Seba-san/Trabajo_Final_Controlados/Posible_bibliografia/Bibliografia_SJ/CONTROL PID_2017.pdf

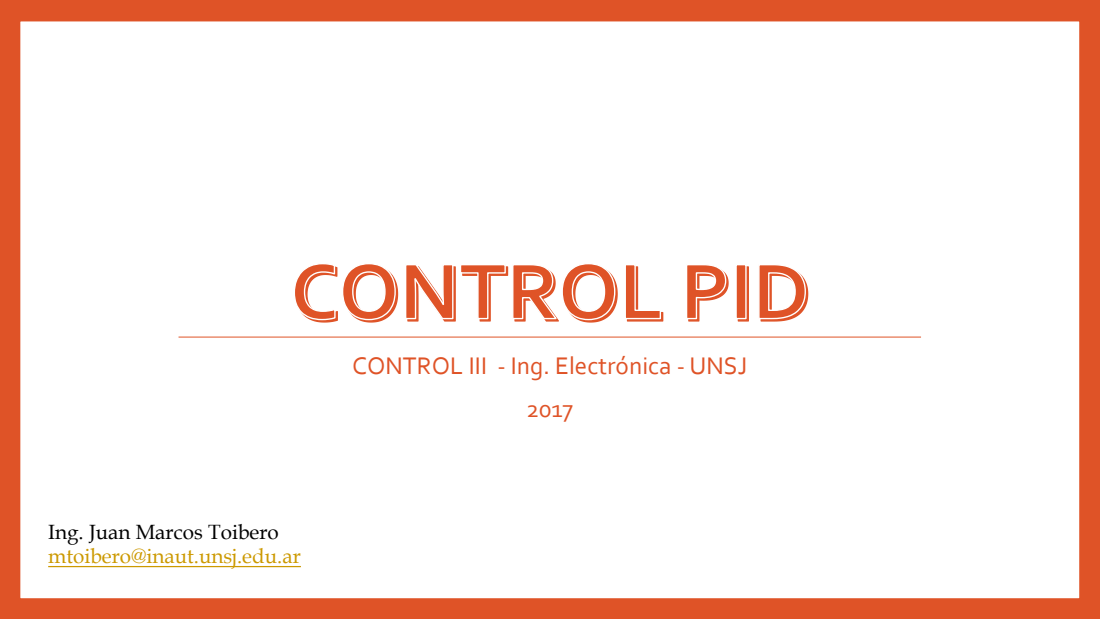
[picture p93: page 1]

CONTROL III - Ing. Electrónica - UNSJ

Ing. Juan Marcos Toibero
mtoibero@inaut.unsj.edu.ar

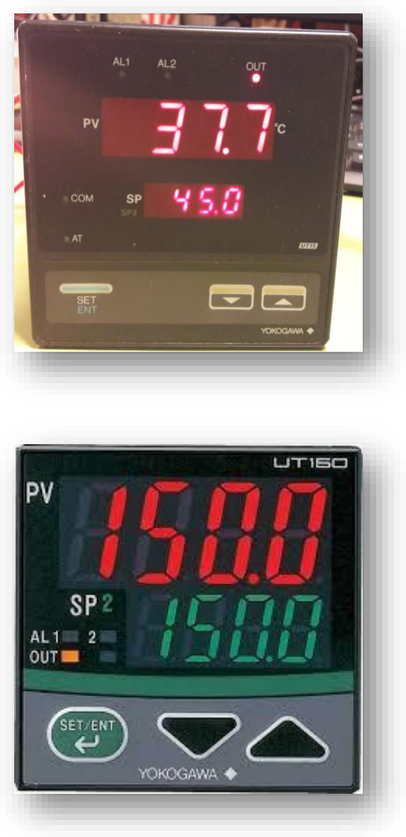
[picture p94: figure]

# Controladores PID industriales

### - Yokogawa UT15 (disponible)

### - Yokogawa UT150 (último modelo comercial)

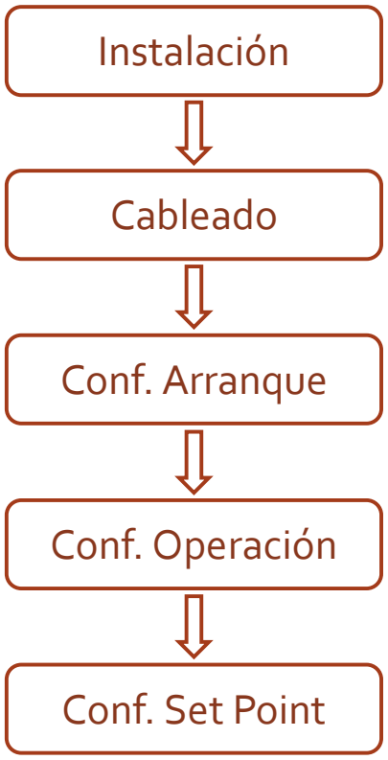
[picture p95: figure]
Instalación; Cableado; Conf. Arranque; Conf. Operación; Conf. Set Point

UT15

### - Pasos antes de operar el equipo

1) Instalación
2) Cableado
3) Configuración de Parámetros de Arranque
4) Configuración de Parámetros de Operación
5) Configuración de Set Point

¡Precaución!
El equipo no tiene interruptor de encendido y apagado.
Entrega la acción de control apenas es conectado en caso de ser necesario.

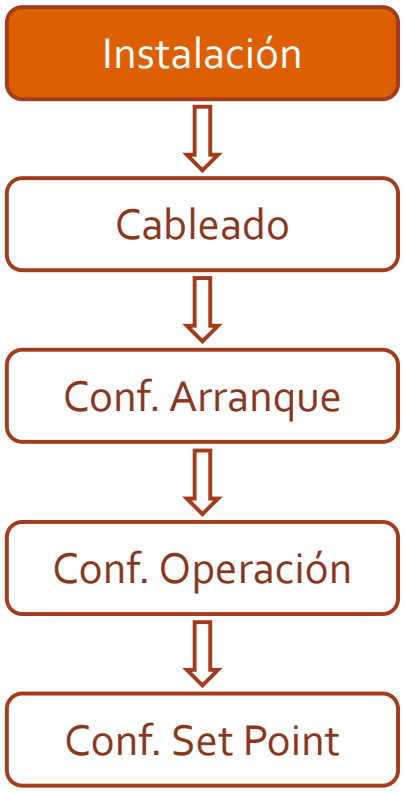
[picture p96: figure]
Instalación; Cableado; Conf. Arranque; Conf. Operación; Conf. Set Point

UT15

### - Instalación

Es la conexión del equipo al tablero, teniendo en cuenta las dimensiones del mismo.

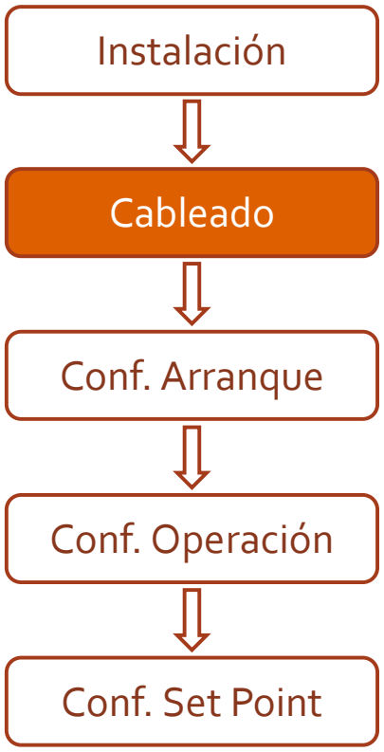
[picture p97: figure]
Instalación; Cableado; Conf. Arranque; Conf. Operación; Conf. Set Point

UT15

### - Cableado

Las conexiones se encuentran en la parte trasera

¡Precaución!

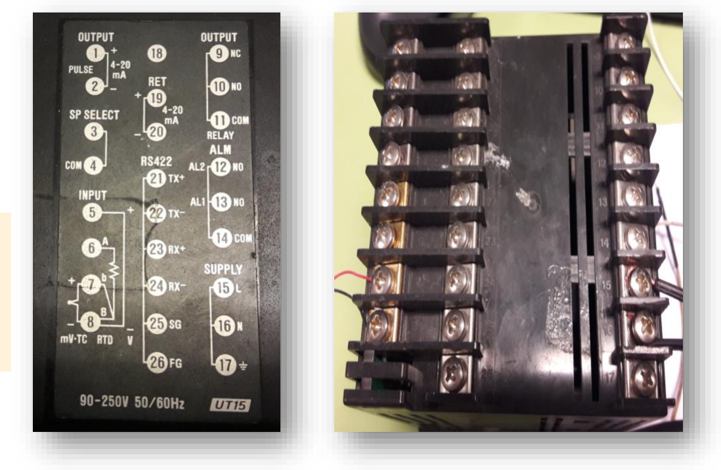
[picture p98: figure]

El equipo no tiene fusibles. De ser necesario se deben agregar en una instalación aparte. Si la carga excede el valor máximo de contacto de salida, deberán agregarse relés extra. Debe tenerse en cuenta además que se pueden llegar a requerir protecciones para los circuitos de accionamiento:
- Diodos para las salidas de DC
- Circuitos RC para las salidas de AC

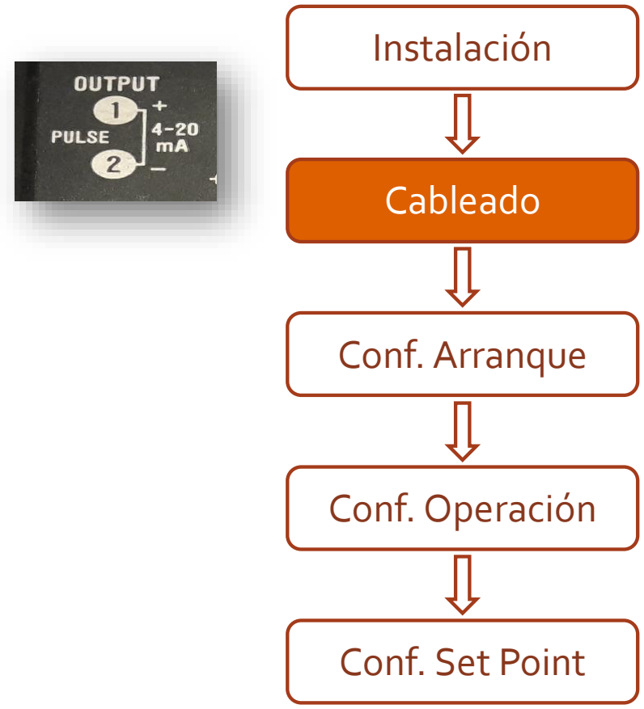
[picture p99: figure]
Instalación; Cableado; Conf. Arranque; Conf. Operación; Conf. Set Point

UT15

### - Salida Analógica

### 4-20[mA] o para tensión

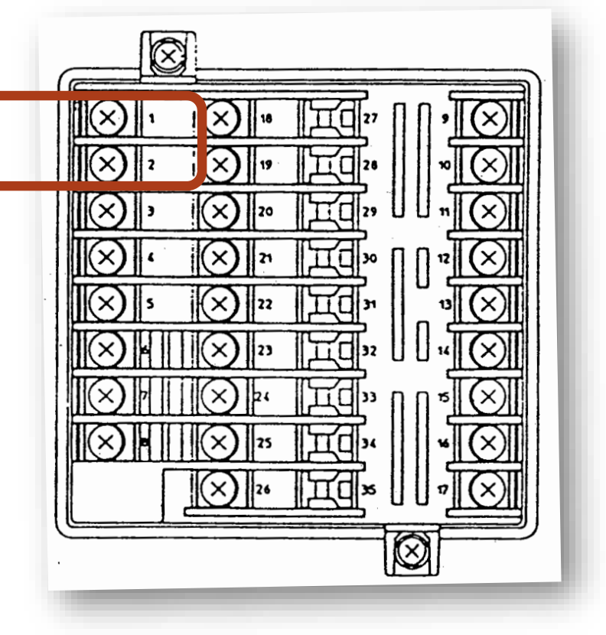
[picture p100: figure]

OUT Analógica

UT15

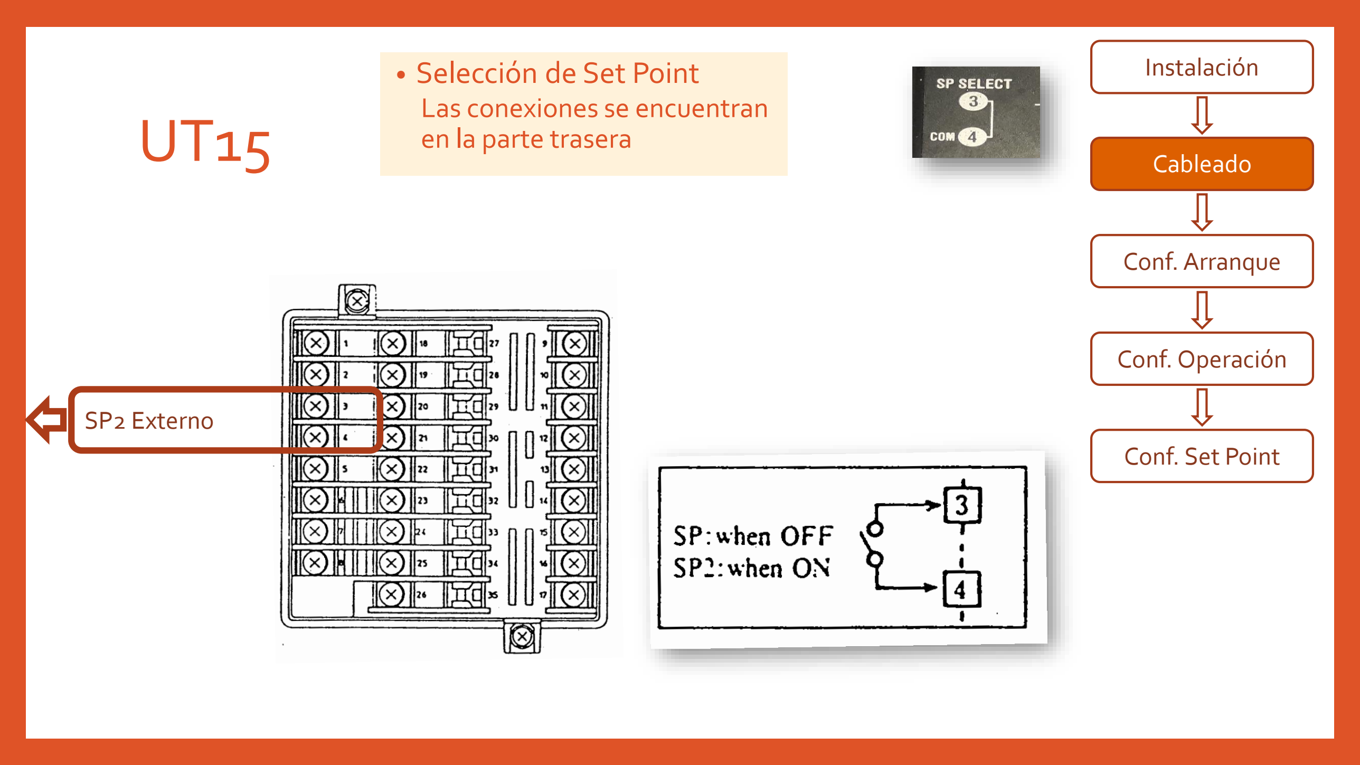
[picture p101: page 7]

### - Selección de Set Point

Las conexiones se encuentran en la parte trasera

Instalación

Cableado

Conf. Arranque

Conf. Operación

Conf. Set Point

SP2 Externo

UT15

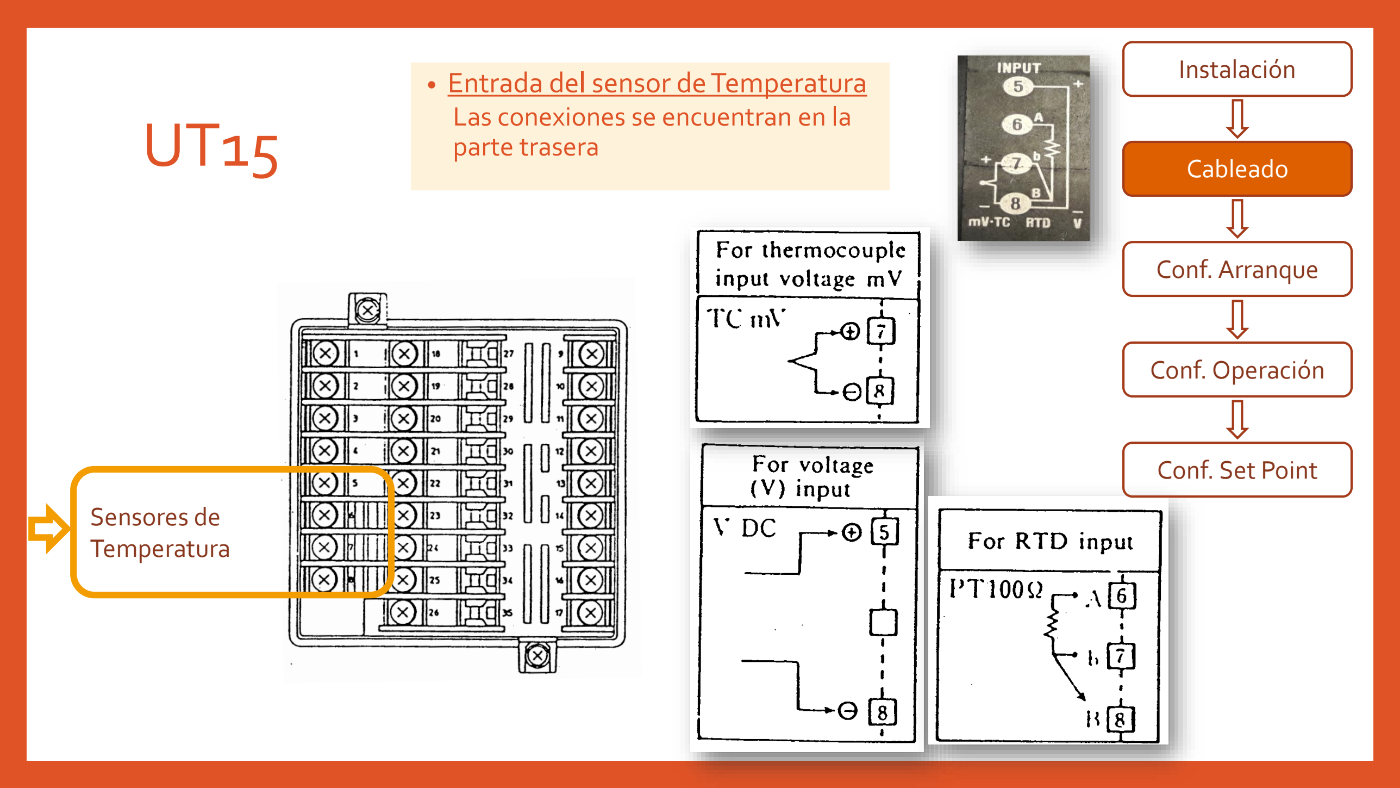
[picture p102: page 8]

- Entrada del sensor de Temperatura Las conexiones se encuentran en la parte trasera

Sensores de
Temperatura

Instalación

Cableado

Conf. Arranque

Conf. Operación

Conf. Set Point

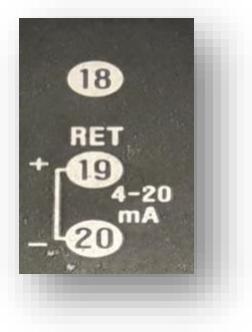
[picture p103: figure]

UT15

### - Retransmisión Salida Opcional

4-20 [mA]

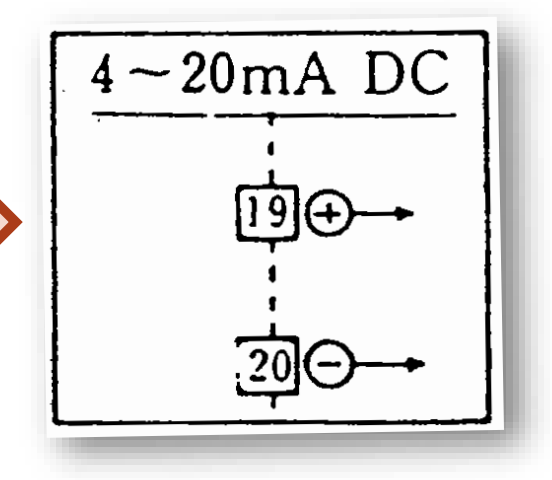
[picture p104: figure]
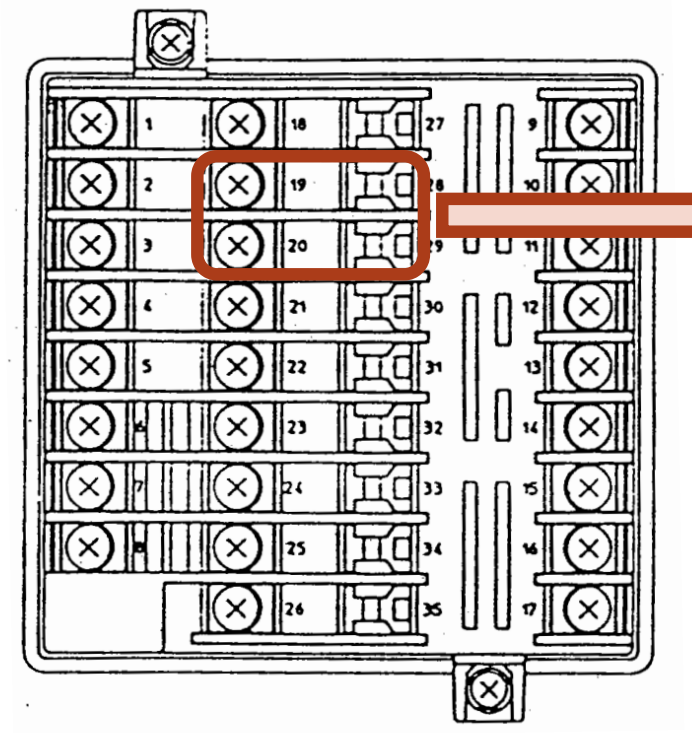
[picture p105: figure]

UT15

### - Comunicación RS422 Opcional

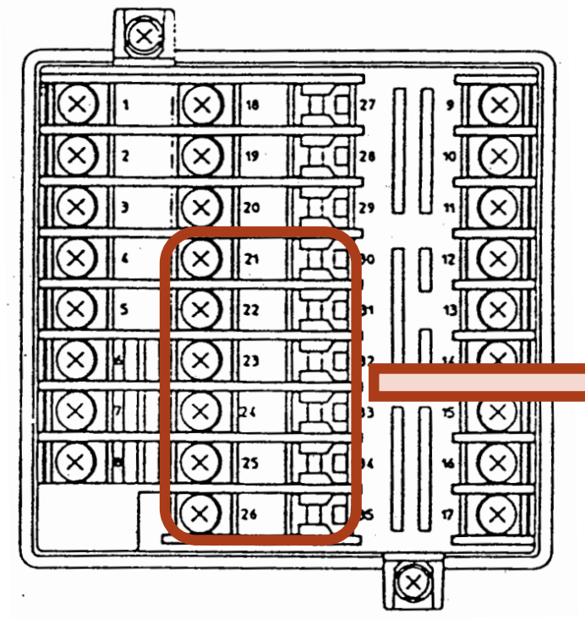
[picture p106: figure]
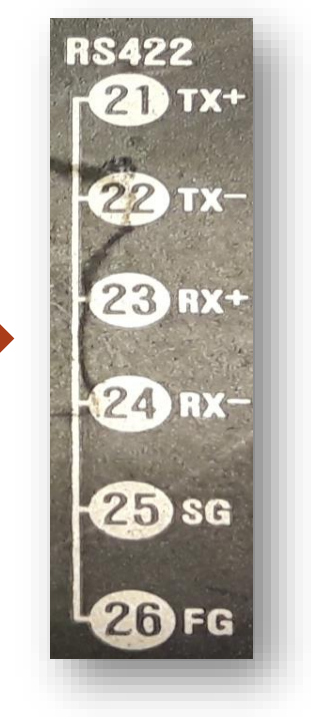
[picture p107: figure]

UT15

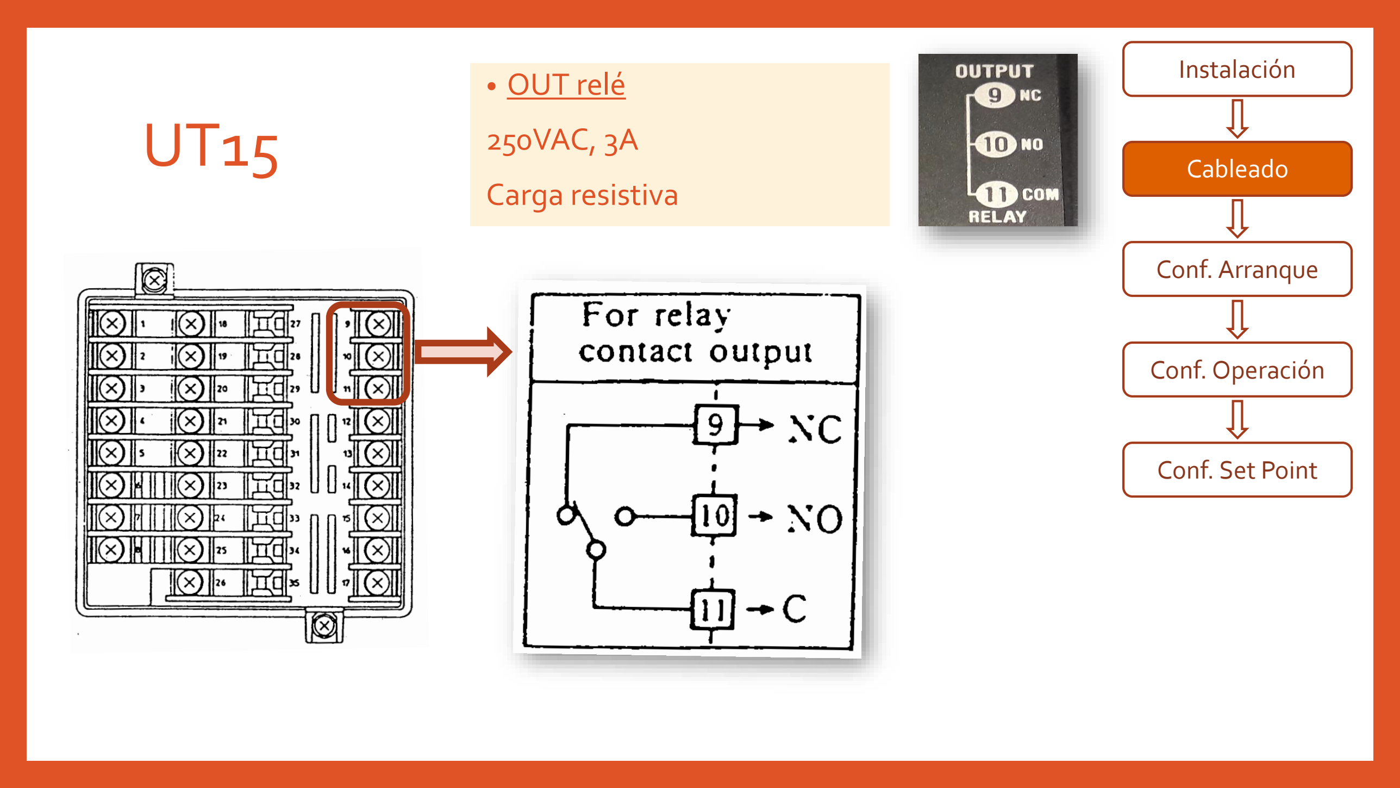
[picture p108: page 11]

### - OUT relé

### 250VAC, 3A

### Carga resistiva

Instalación

Cableado

Conf. Arranque

Conf. Operación

Conf. Set Point

UT15

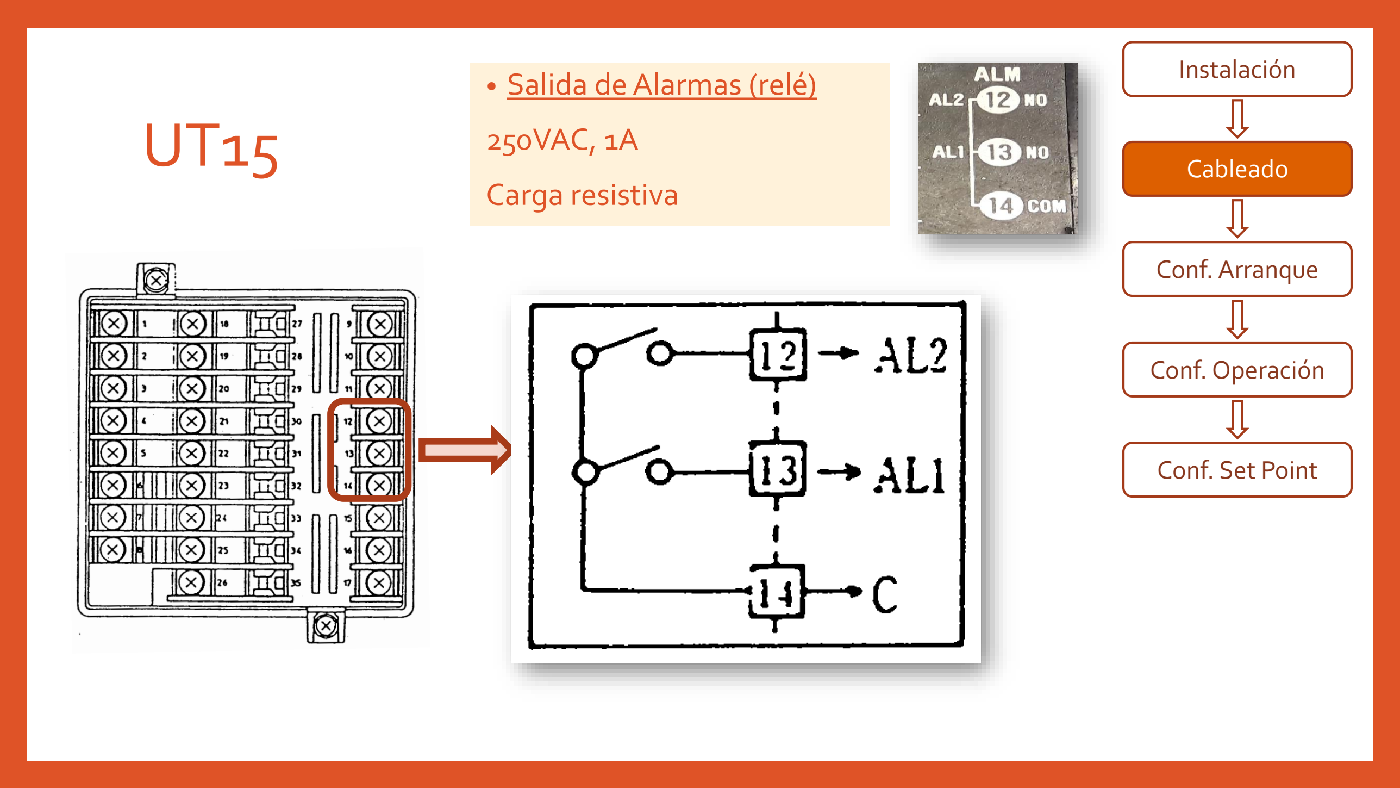
[picture p109: page 12]

### - Salida de Alarmas (relé)

### 250VAC, 1A

### Carga resistiva

Instalación

Cableado

Conf. Arranque

Conf. Operación

Conf. Set Point

UT15

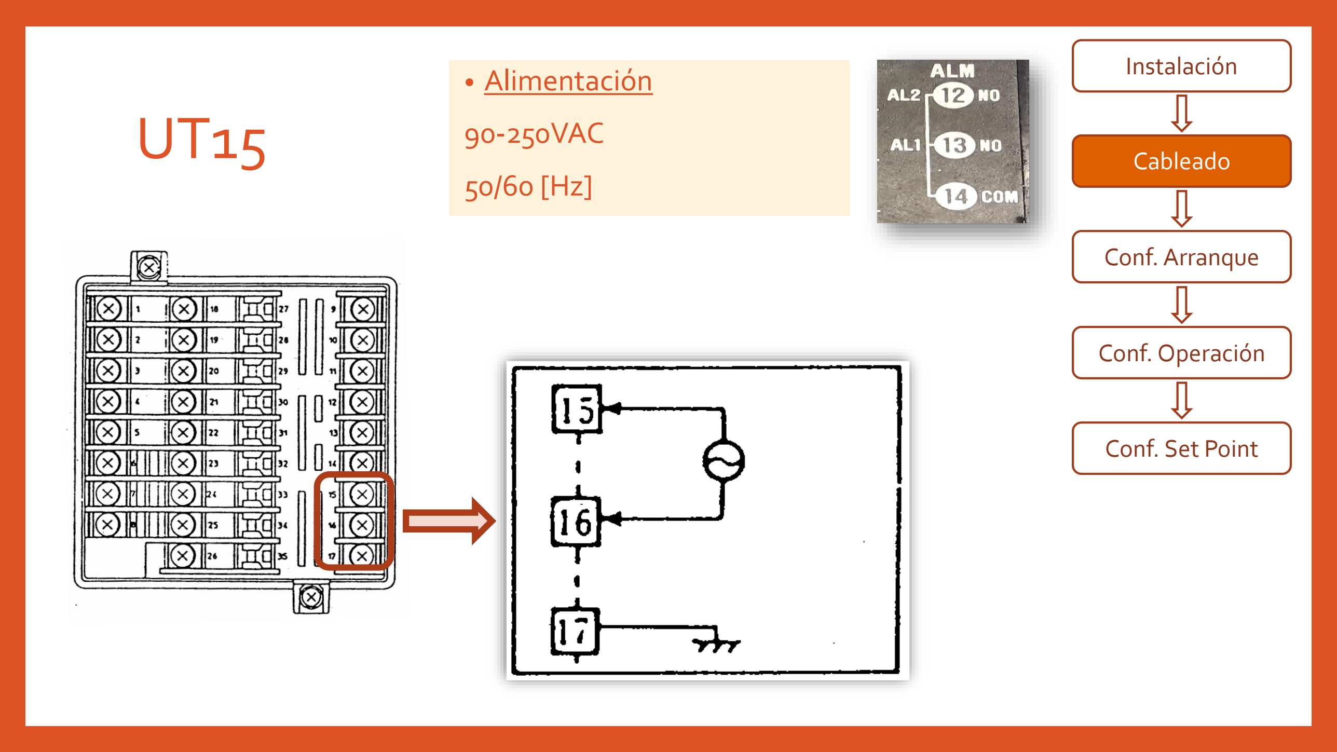
[picture p110: page 13]

### - Alimentación

90

### -250VAC

50/60 [Hz]

Instalación

Cableado

Conf. Arranque

Conf. Operación

Conf. Set Point

UT15

### - Panel Frontal

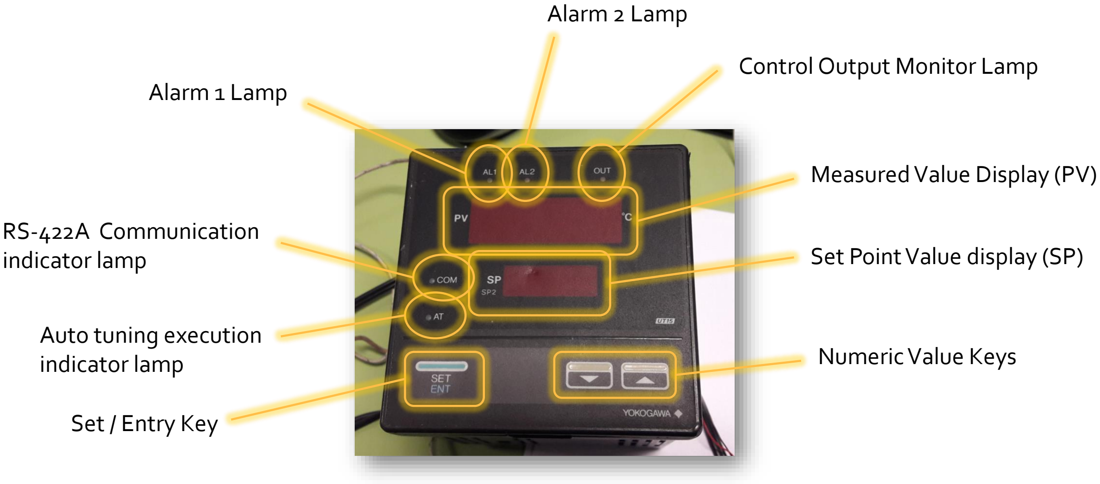
[picture p111: figure]
Set / Entry Key; Numeric Value Keys; Alarm 1 Lamp; Alarm 2 Lamp; Control Output Monitor Lamp; Measured Value Display (PV); Set Point Value display (SP); Auto tuning execution indicator lamp; RS-422A Communication indicator lamp

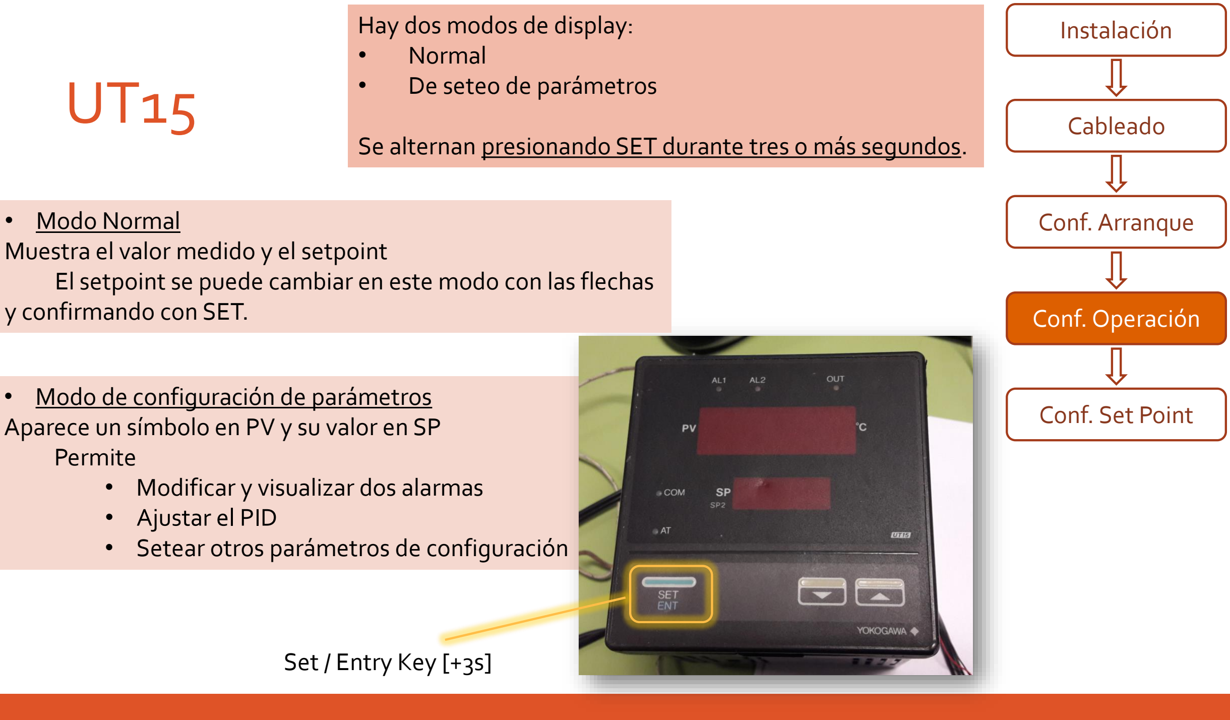
[picture p112: figure]
• Modo de configuración de parámetros; Permite • Modificar y visualizar dos alarmas • Ajustar el PID; Set / Entry Key [+3s]; Hay dos modos de display: • Normal • De seteo de parámetros; • Modo Normal Muestra el valor medido y el setpoint; y confirmando con SET.; Instalación; Cableado; Conf. Arranque; Conf. Operación; Conf. Set Point

Aparece un símbolo en PV y su valor en SP

- Setear otros parámetros de configuración

Se alternan presionando SET durante tres o más segundos.

El setpoint se puede cambiar en este modo con las flechas

UT15

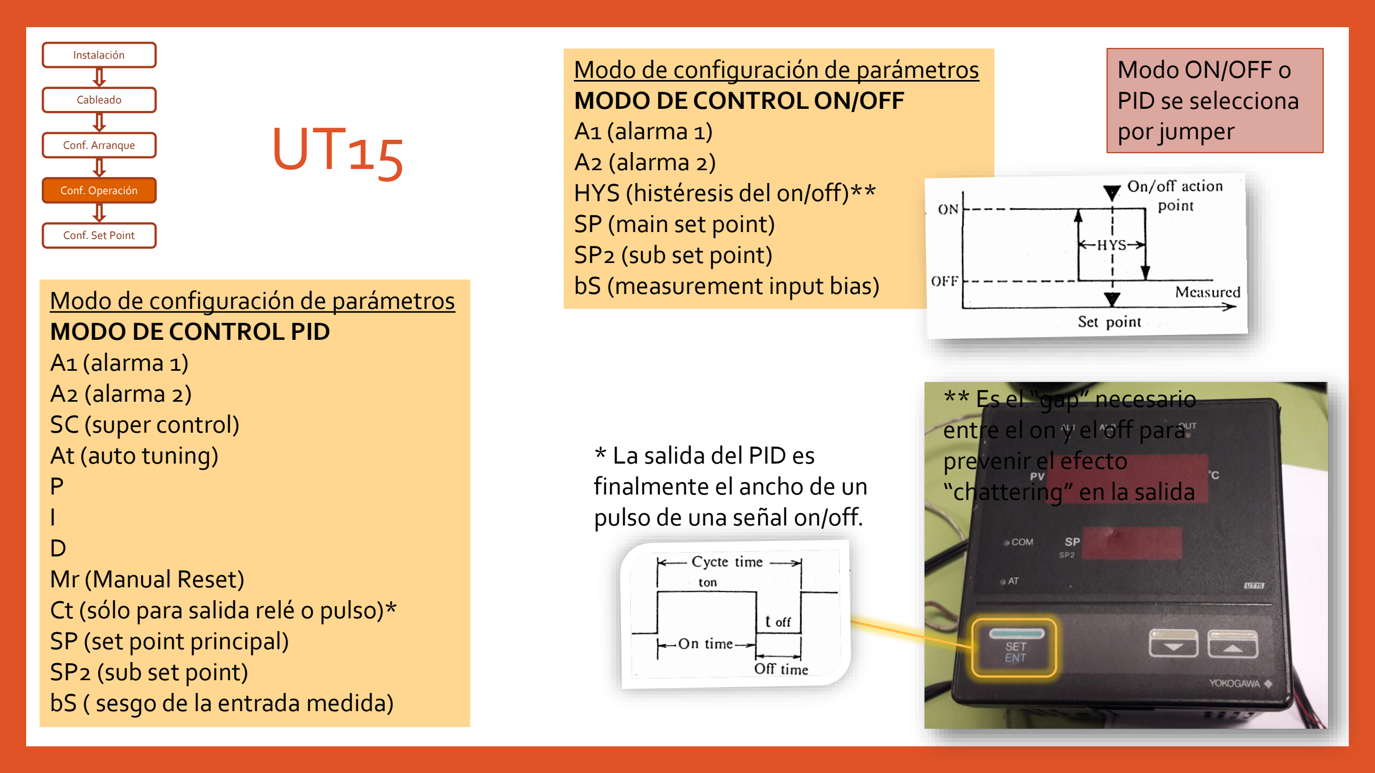
[picture p113: page 16]

Set / Entry Key

Modo de configuración de parámetros MODO DE CONTROL PID
A1 (alarma 1)
A2 (alarma 2)
SC (super control)
At (auto tuning)
P
I
D
Mr (Manual Reset)
Ct (sólo para salida relé o pulso)* SP (set point principal)
SP2 (sub set point)
bS ( sesgo de la entrada medida)

Modo de configuración de parámetros MODO DE CONTROL ON/OFF
A1 (alarma 1)
A2 (alarma 2)
HYS (histéresis del on/off)** SP (main set point)
SP2 (sub set point)
bS (measurement input bias)

Modo ON/OFF o
PID se selecciona
por jumper

* La salida del PID es
finalmente el ancho de un
pulso de una señal on/off.

** Es el “gap” necesario
entre el on y el off para
prevenir el efecto
“chattering” en la salida

Instalación

Cableado

Conf. Arranque

Conf. Operación

Conf. Set Point

SP2

- Los valores del PID son los mismo para SP que para SP2
- Hay que tener precaución si se usó auto tuning para algún set point, porque puede ser que los valores obtenidos no funcionen tan bien con uno como con el otro.

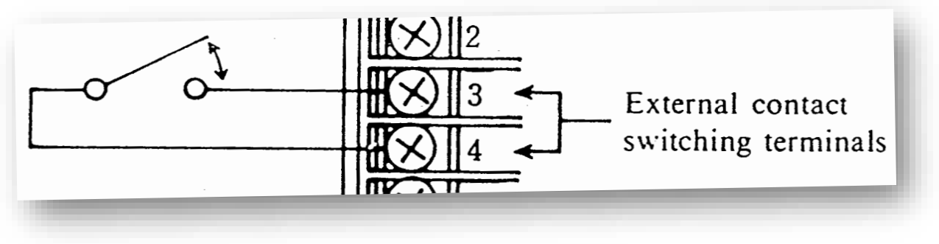
[picture p114: figure]

### - Cuando se observe una diferencia entre la temperatura en la ubicación del sensor

y la que debe ser controlada. Se puede ingresar esta diferencia para compensar.

### PV_medida + Bias = PV_empleada

# Sesgo en la medida de entrada (input bias)

El cambio entre SP y SP2
se realiza por medio de
un contacto externo

Instalación

Cableado

Conf. Arranque

Conf. Operación

Conf. Set Point

# UT15 :: Configuración de Alarmas

Modo de configuración de parámetros
Aparece A1 en PV
Se ajusta el valor de alarma MÁXIMA A1 usando las flechas
El punto decimal en SP debe parpadear.

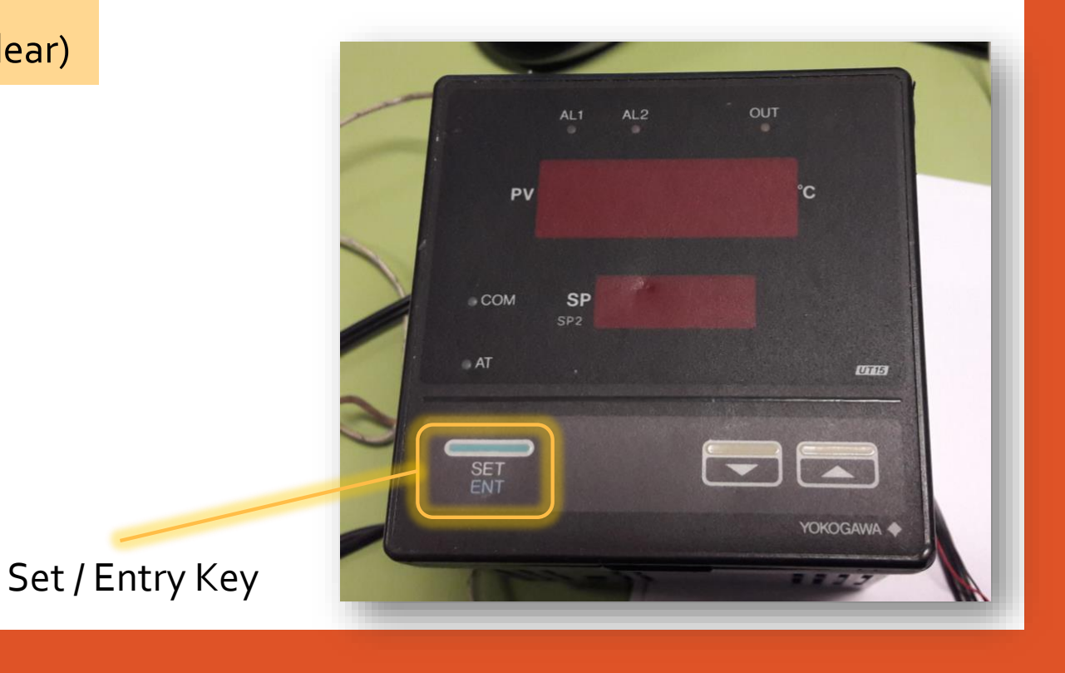
[picture p115: figure]
Set / Entry Key

Se confirma con SET (el punto decimal debe dejar de parpadear)

✓ La alarma suena cuando PV>A1 encendiendo
el led AL1 y activando el relé correspondiente en la salida [salida 13].

✓ Se cancela cuando PV<A1 pero un valor de histéresis del 0,5% para activar y para desactivar

Instalación

Cableado

Conf. Arranque

Conf. Operación

Conf. Set Point

UT15

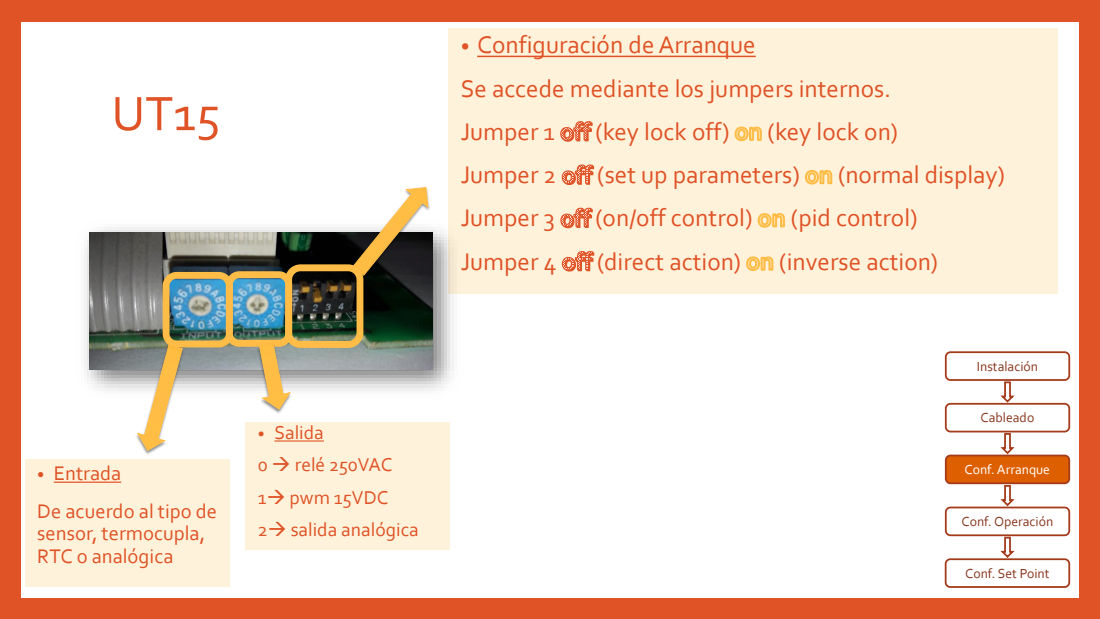
[picture p116: page 19]
Jumper 1; (key lock off); (key lock on); Jumper 2; (set up parameters); (normal display); Jumper 3; (on/off control); (pid control); Jumper 4; (direct action); (inverse action); Instalación; Cableado; Conf. Arranque; Conf. Operación; • Salida; 0 → relé 250VAC; 1→ pwm 15VDC; 2→ salida analógica

• Configuración de Arranque
Se accede mediante los jumpers internos.

• Entrada
De acuerdo al tipo de
sensor, termocupla,
RTC o analógica

Conf. Set Point

UT15

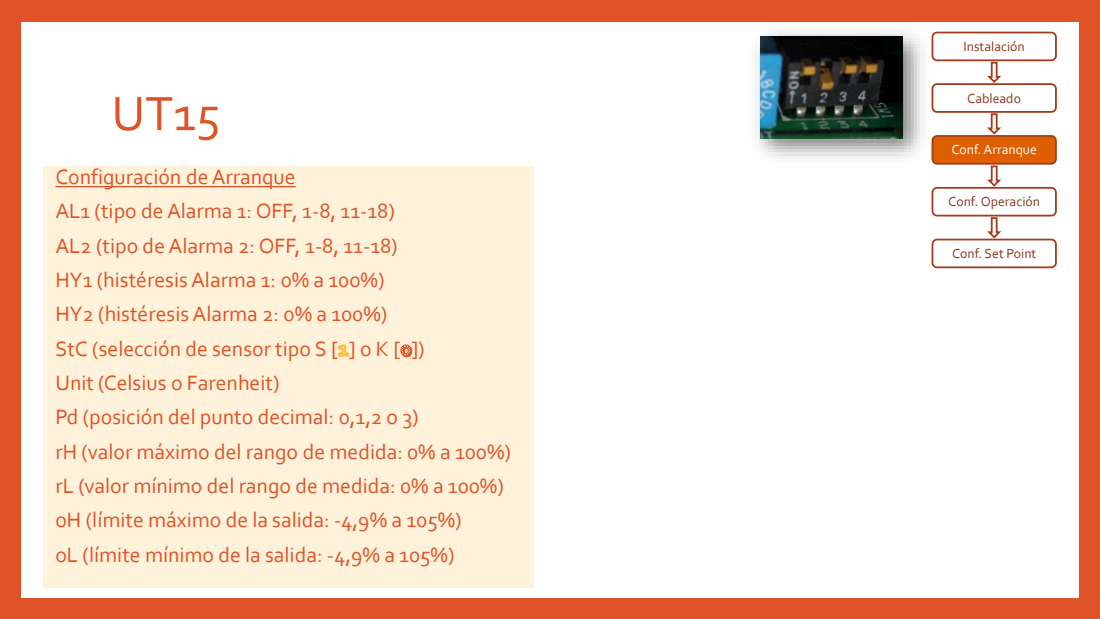
[picture p117: page 20]
Instalación; Cableado; Conf. Arranque; Conf. Operación

Configuración de Arranque
AL1 (tipo de Alarma 1: OFF, 1
AL2 (tipo de Alarma 2: OFF, 1
HY1 (histéresis Alarma 1: 0% a 100%)
HY2 (histéresis Alarma 2: 0% a 100%)
StC (selección de sensor tipo S [ ] o K [ ])
Unit (Celsius o Farenheit
Pd (posición del punto decimal: 0,1,2 o 3)
rH (valor máximo del rango de medida: 0% a 100%)
rL (valor mínimo del rango de medida: 0% a 100%)
oH (límite máximo de la salida:
oL (límite mínimo de la salida:

Conf. Set Point

UT15

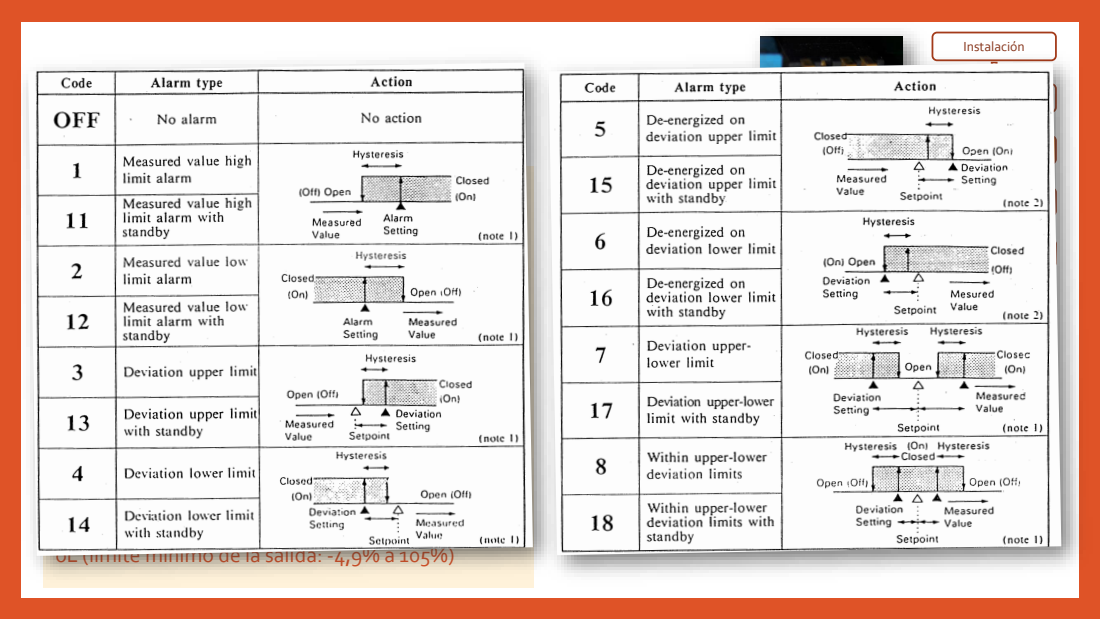
[picture p118: page 21]
Instalación; Cableado; Conf. Arranque; Conf. Operación

Configuración de Arranque
AL1 (tipo de Alarma 1: OFF, 1
AL2 (tipo de Alarma 2: OFF, 1
HY1 (histéresis Alarma 1: 0% a 100%)
HY2 (histéresis Alarma 2: 0% a 100%)
StC (selección de sensor tipo S [ ] o K [ ])
Unit (Celsius o Farenheit
Pd (posición del punto decimal: 0,1,2 o 3)
rH (valor máximo del rango de medida: 0% a 100%)
rL (valor mínimo del rango de medida: 0% a 100%)
oH (límite máximo de la salida:
oL (límite mínimo de la salida:

Conf. Set Point

UT15

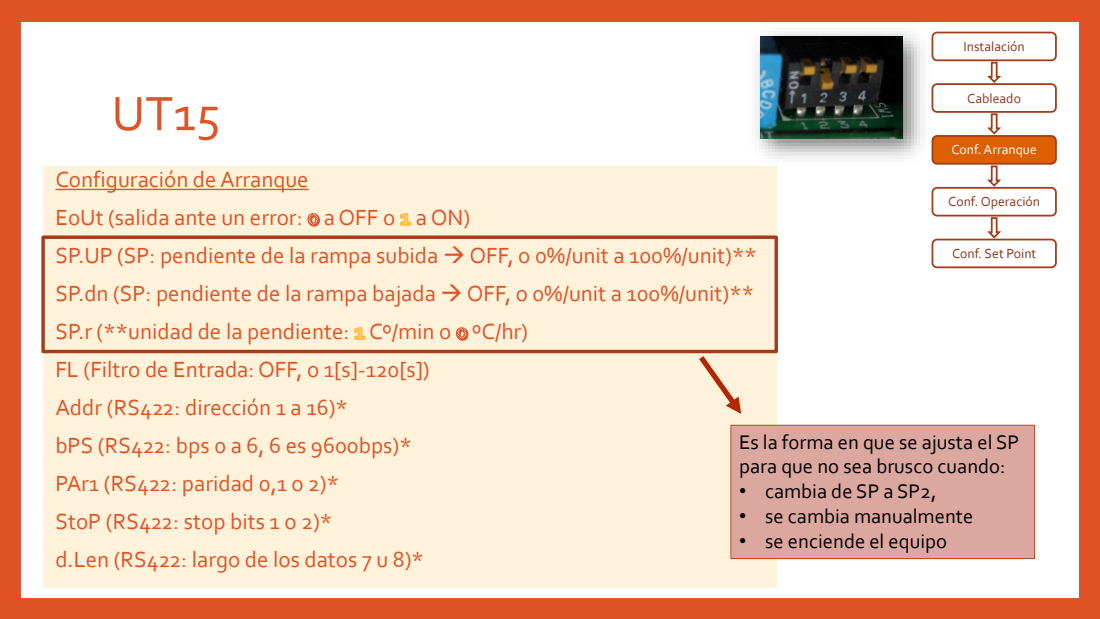
[picture p119: page 22]
Instalación; Cableado; Conf. Arranque; Conf. Operación

Configuración de Arranque
EoUt (salida ante un error: a OFF o a ON)
SP.UP (SP: pendiente de la rampa subida → OFF, o 0%/unit a 100%/unit)**
SP.dn (SP: pendiente de la rampa bajada →OFF, o 0%/unit a 100%/unit)**
SP.r (**unidad de la pendiente: Cº/min o ºC/hr)
FL (Filtro de Entrada: OFF, o 1[s]-120[s])
Addr (RS422: dirección 1 a 16)*
bPS (RS422: bps 0 a 6, 6 es 9600bps)*
PAr1 (RS422: paridad 0,1 o 2)*
StoP (RS422: stop bits 1 o 2)*
d.Len (RS422: largo de los datos 7 u 8)*

Conf. Set Point

Es la forma en que se ajusta el SP
para que no sea brusco cuando:
• cambia de SP a SP2,
• se cambia manualmente
• se enciende el equipo

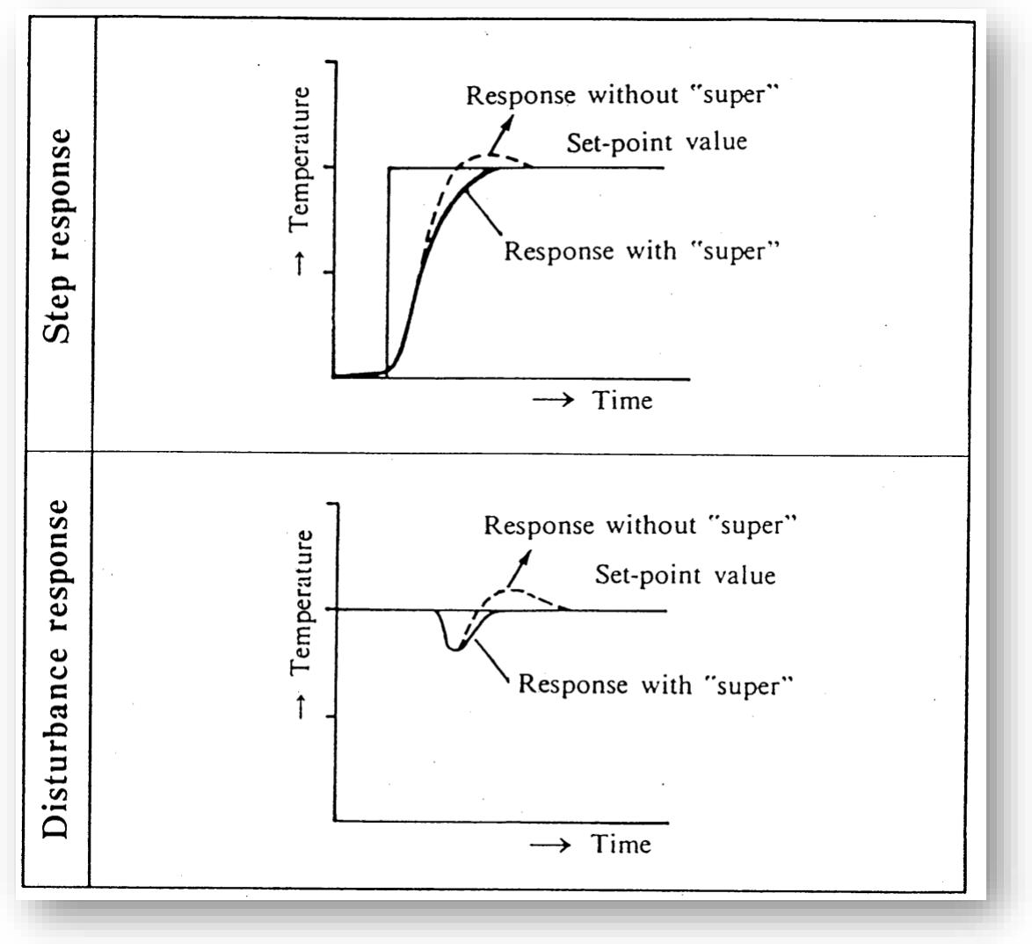
[picture p120: figure]

# PID Modo “Super”

### Efectos en cambios de carga o en cambios de set point:

### - Suprime sobre-elongación

### - Acorta tiempo de subida

Se basa en un algoritmo fuzzy.

# PID Auto-tuning

### Al conectarlo [1], habilita la salida hasta su máximo hasta que se alcance la referencia [2]. La

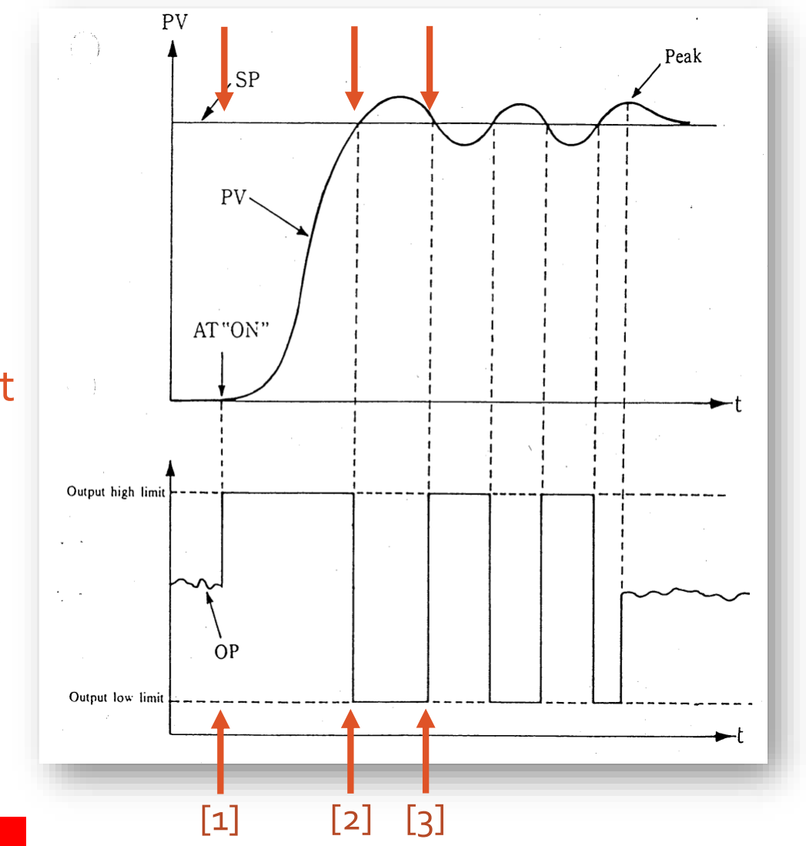
[picture p121: figure]

### salida se anula hasta que vuelve a alcanzarse el set

point en [3].

### Esto se repite tres veces, luego de esto se obtienen los valores de P, I y D en forma automática de acuerdo a como se ha comportado

la planta.

¡Precaución!
Antes de ejecutar esta secuencia, hay que asegurar que el producto final no sea afectado por las variaciones de la salida.

# P → Banda proporcional

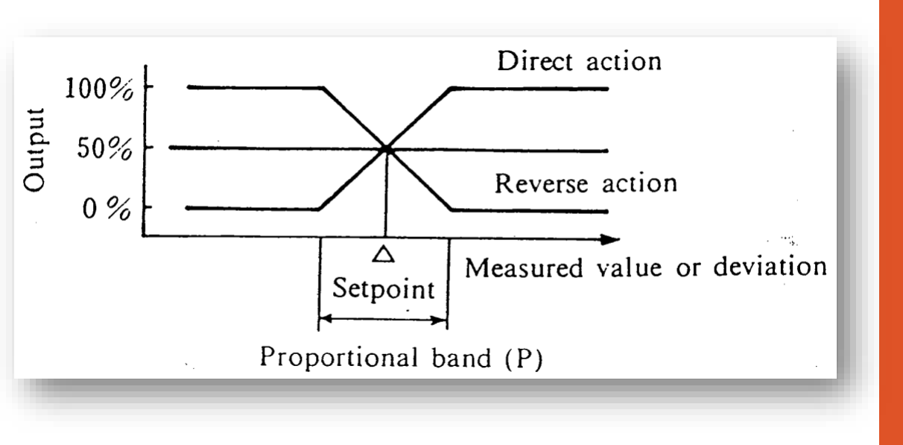
[picture p122: figure]

### En acción proporcional, la magnitud del cambio en la variable medida (o desviación) se expresa en porcentaje del rango total que se requiere para que la salida cambie

de 0 a 100%.

### En general, la salida será de un 50% cuando la variable medida y el set point sean exactamente iguales. Pero esto debe ser

ajustado manualmente.

# I →Tiempo Integral

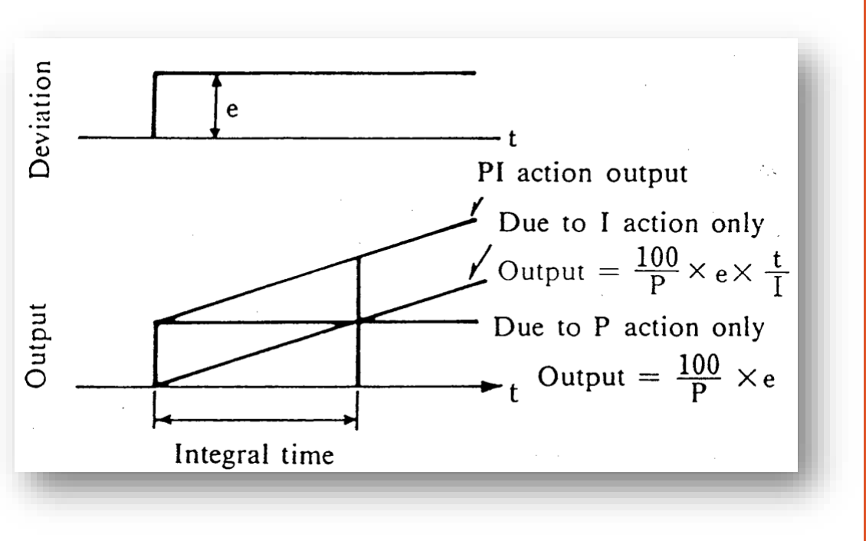
[picture p123: figure]

### Es el parámetro que determina que tan rápido cambia la salida en correspondencia

con el error.

### Cuanto menor el tiempo integral, mayor es la acción integral (la tasa de cambio de la

salida).

Es el tiempo requerido para que el cambio en la salida debido sólo al efecto I sea igual al efecto P para una entrada escalón. Generalmente se aplica con la acción P.

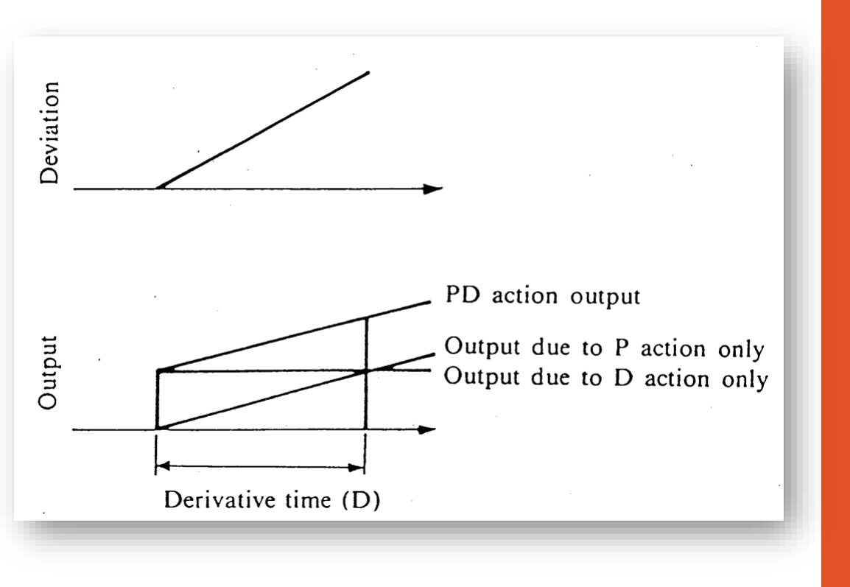
[picture p124: figure]

# D →Tiempo Derivativo

### Se utiliza para alcanzar respuestas más rápidas y operar en una zona más estable en plantas lentas o con tiempos muertos

considerables.

### Siempre debe aplicarse con un P o con un

PI.

### Es el tiempo requerido cuando al aplicar una rampa unitaria a un controlador PD, la salida del efecto P es igual a la salida del

efecto D.
Cuanto mayor sea el tiempo derivativo, mayor será la acción derivativa.

# FIN

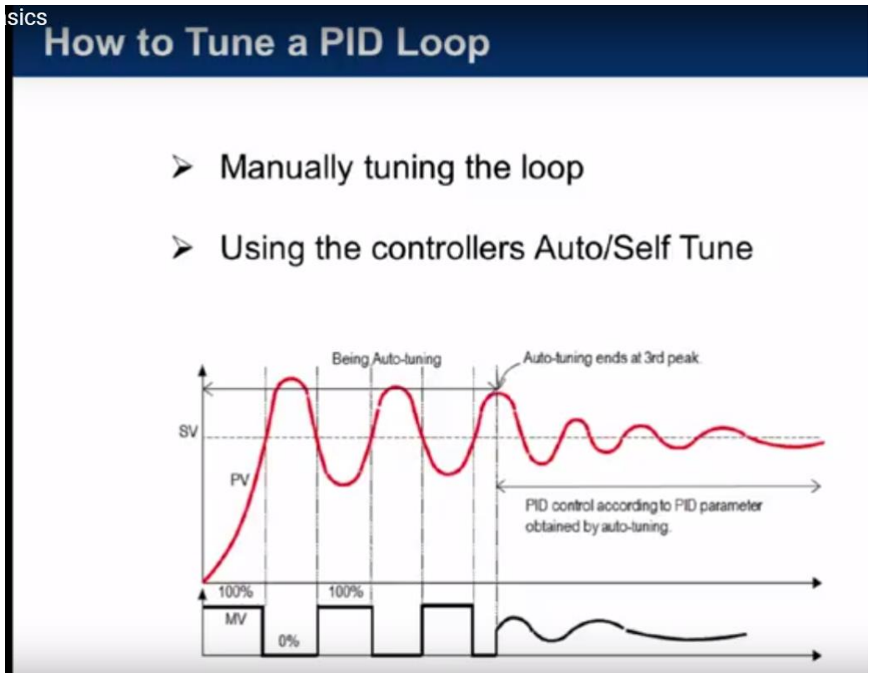
[picture p125: figure]

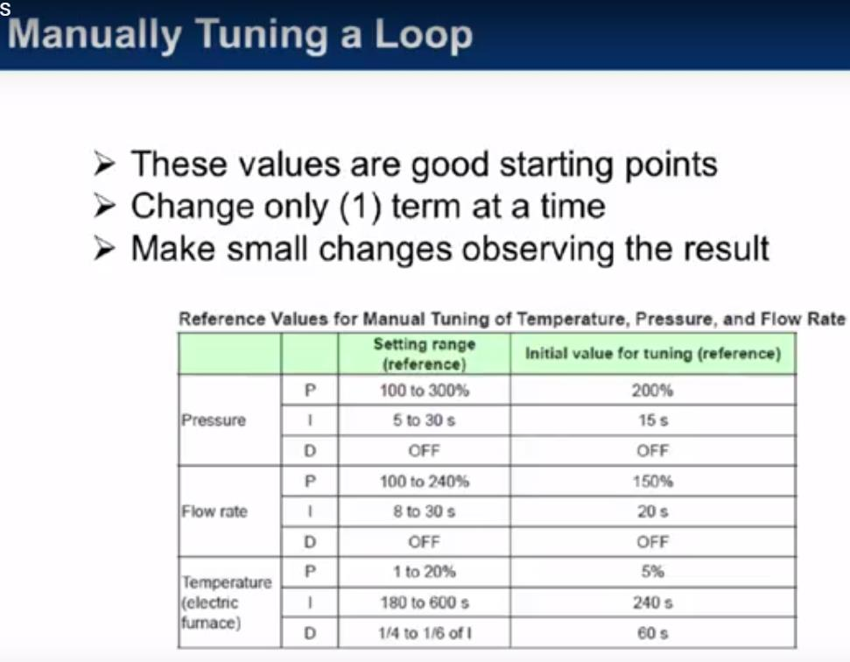
[picture p126: figure]

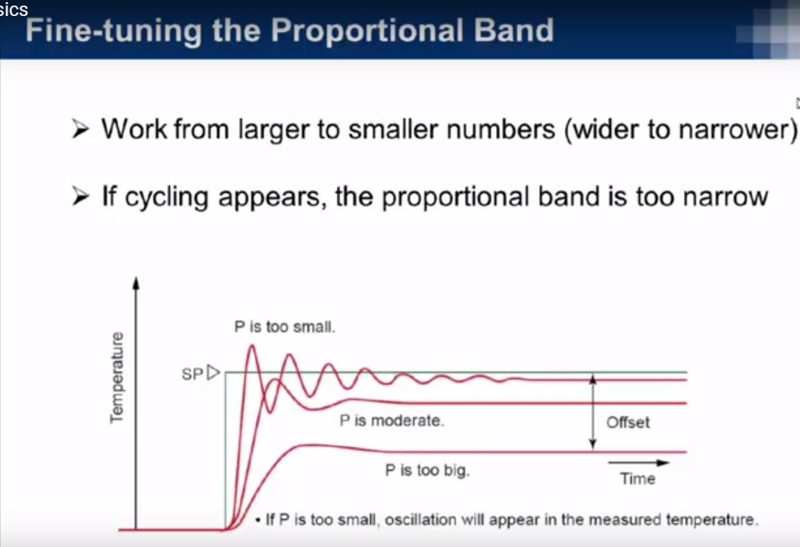
[picture p127: figure]

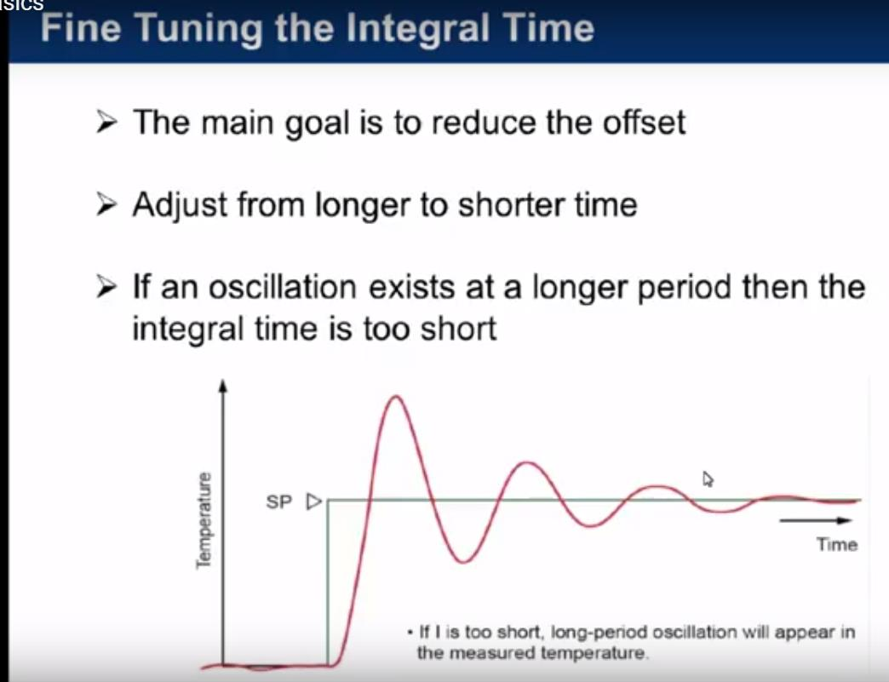
[picture p128: figure]

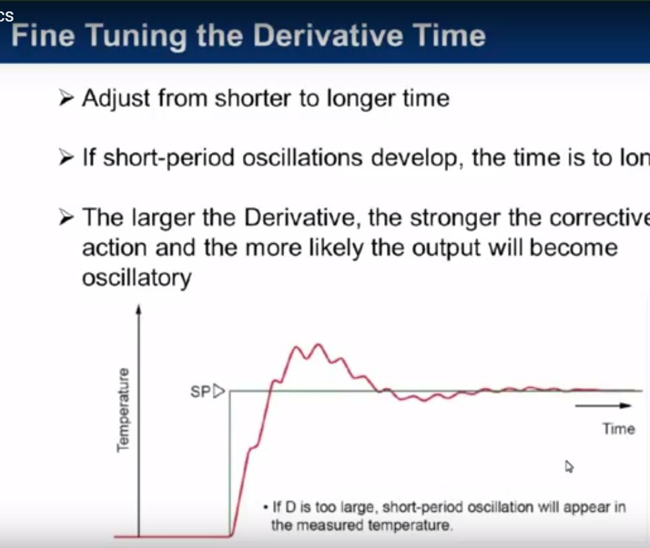
[picture p129: figure]

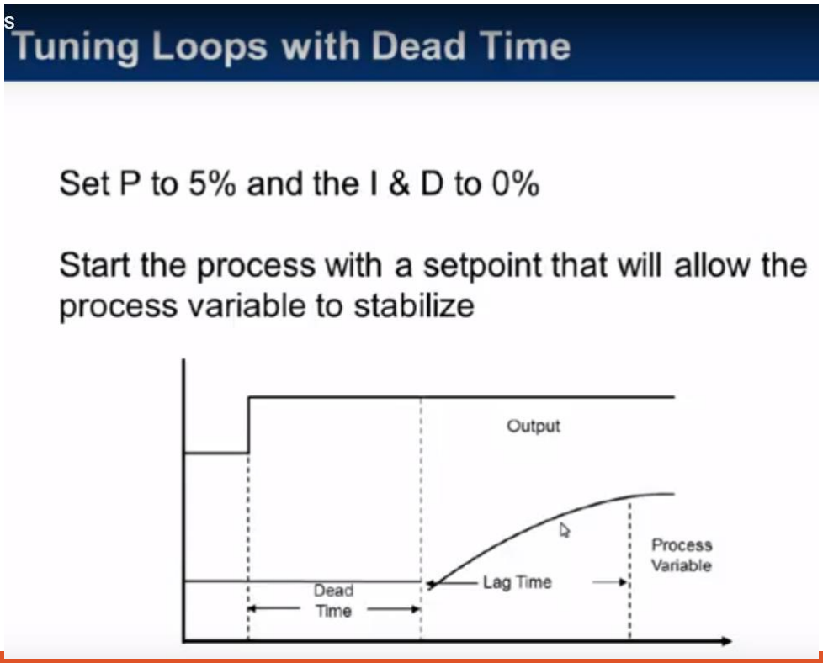
[picture p130: figure]

# Auto Tune

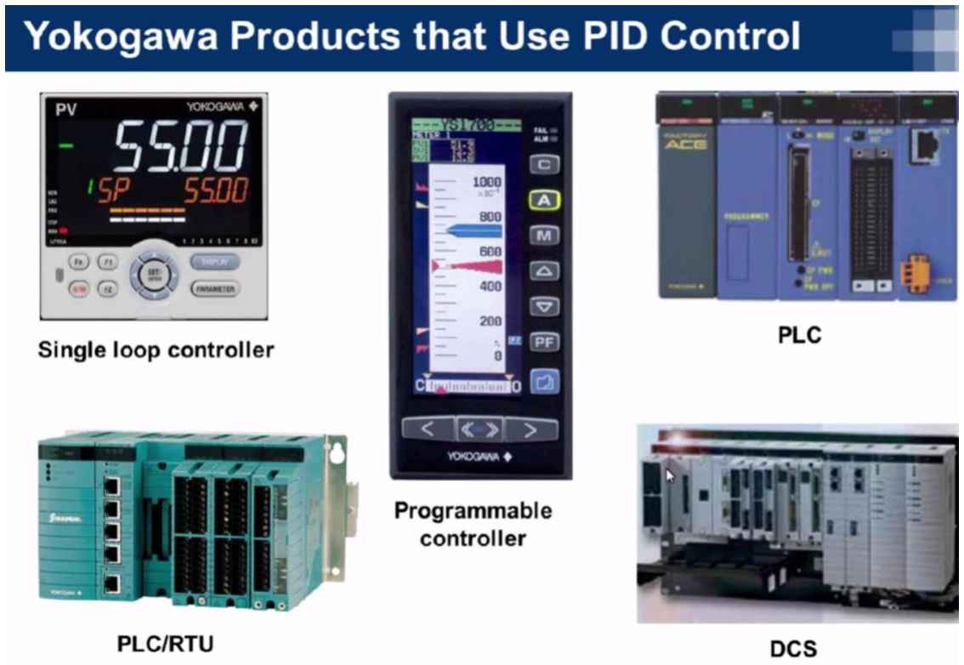
[picture p131: figure]

# Auto Tune

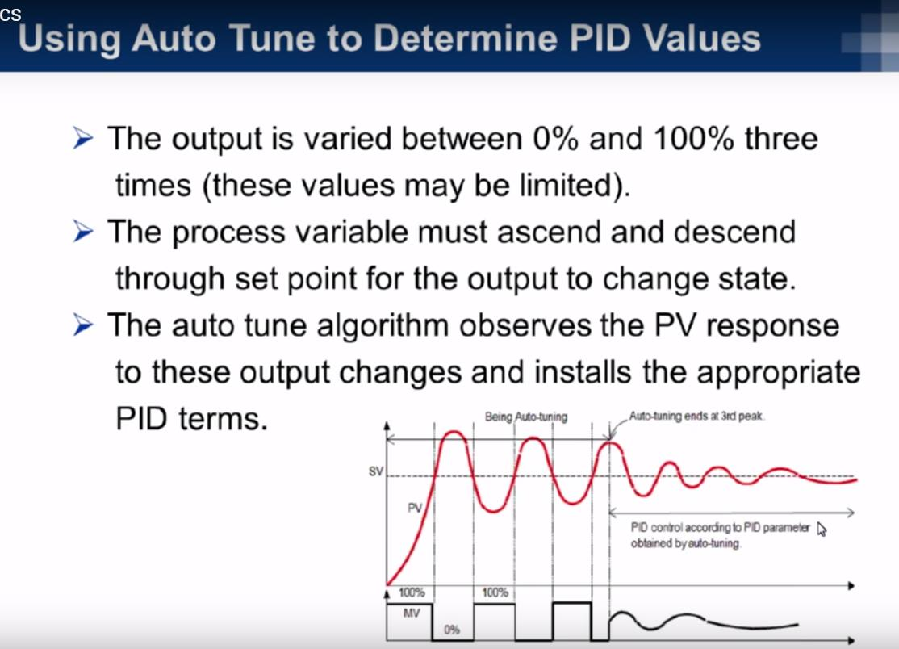
[picture p132: figure]

# Auto Tune

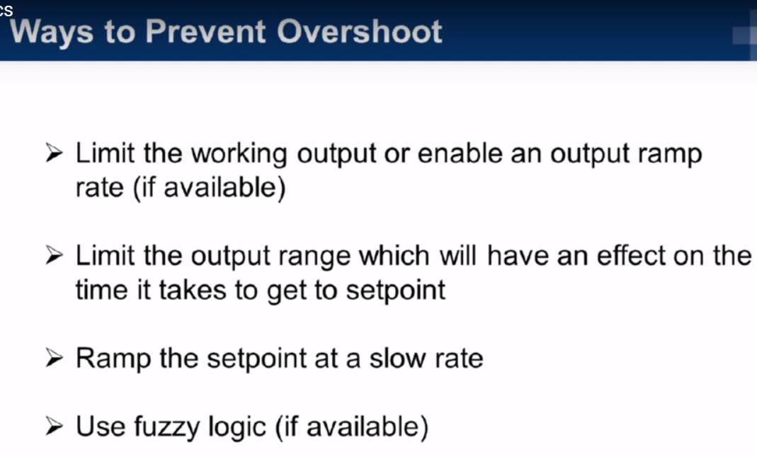
[picture p133: figure]

# Auto Tune

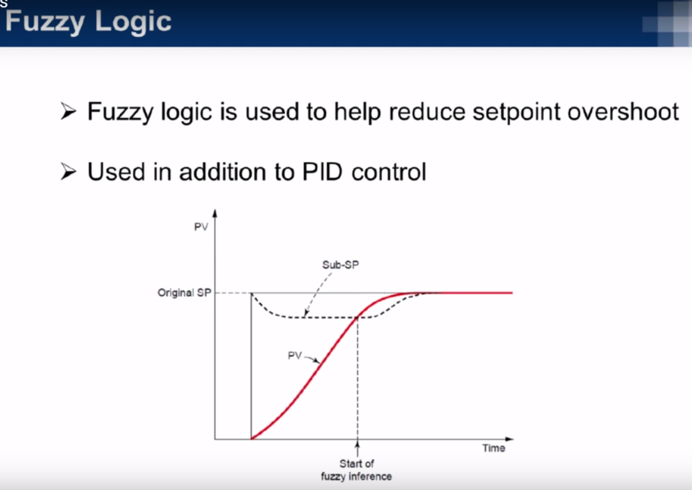
[picture p134: figure]

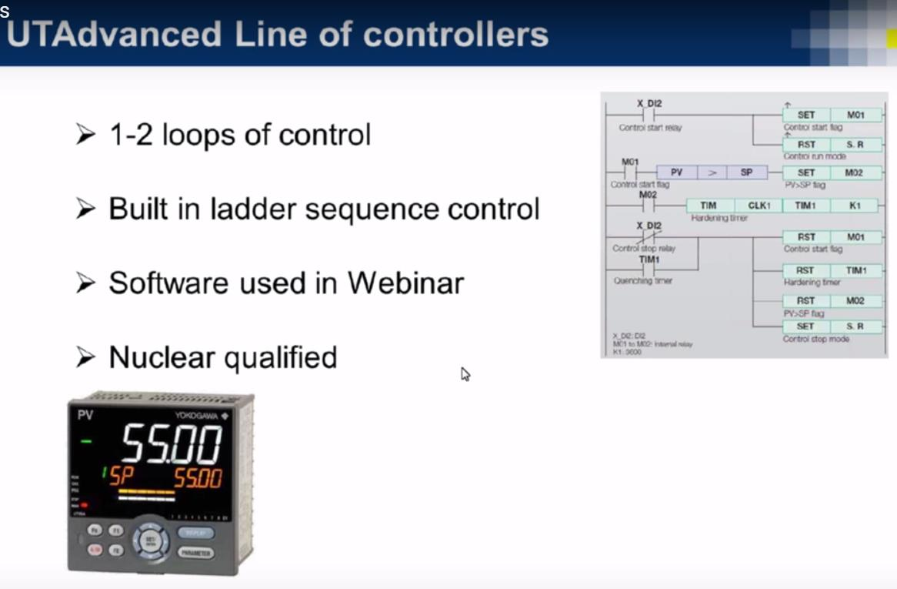
[picture p135: figure]

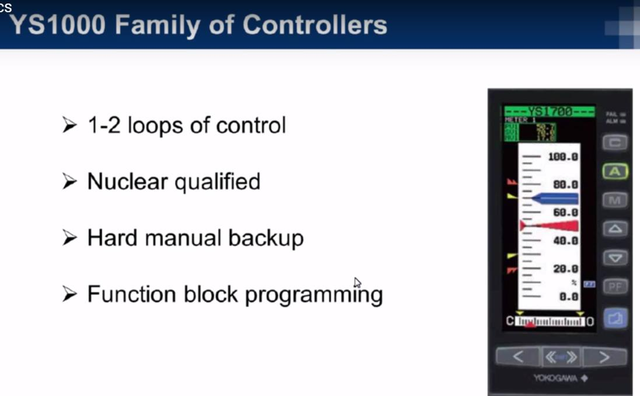
[picture p136: figure]

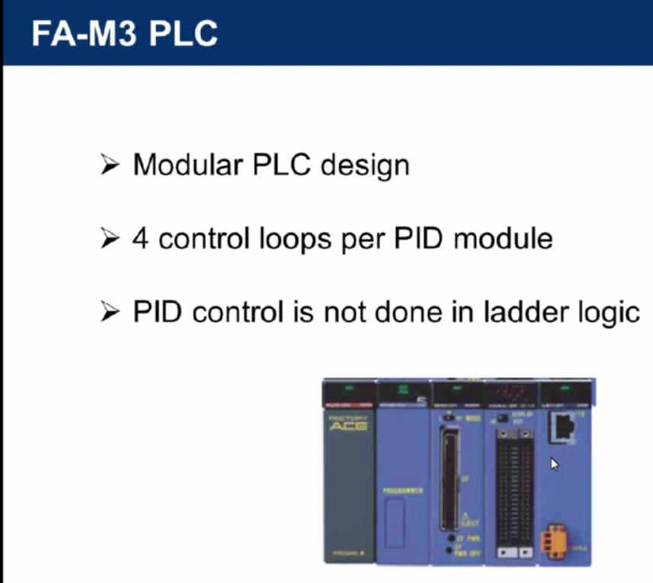
[picture p137: figure]
