Seba-san/Trabajo_Final_Controlados/Informe/Pre_informe/imagenes/LogoUNC-eps-converted-to.pdf

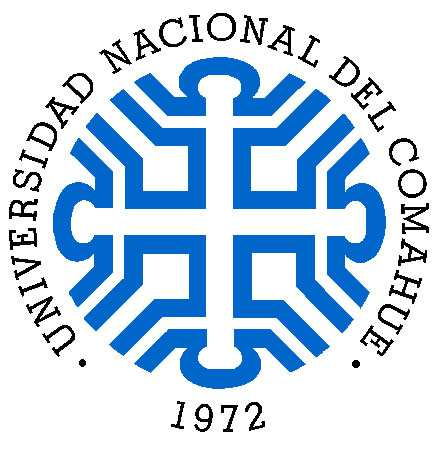
[picture p138: page 1]
