Seba-san/Trabajo_Final_Controlados/Informe/Pre_informe/imagenes/resp_escalon_sys_total-eps-converted-to.pdf

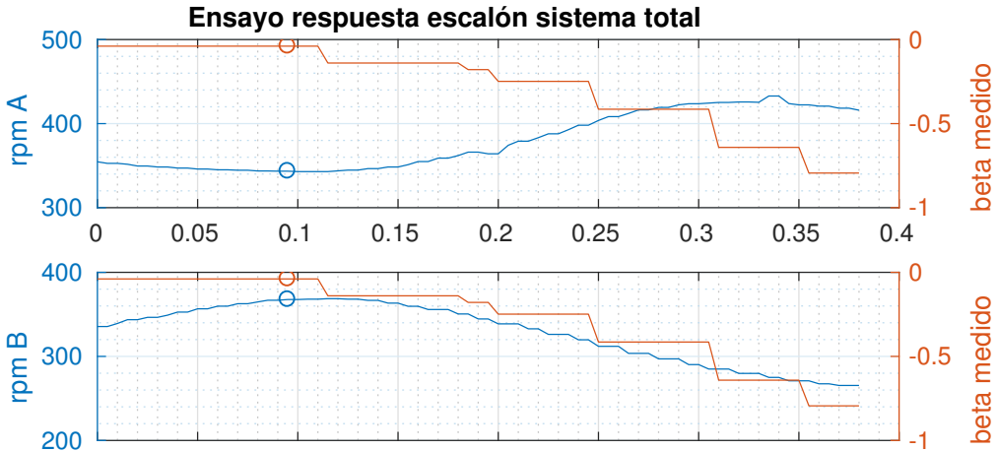
[picture p139: figure]
rpm A; beta medido; Ensayo respuesta escalón sistema total
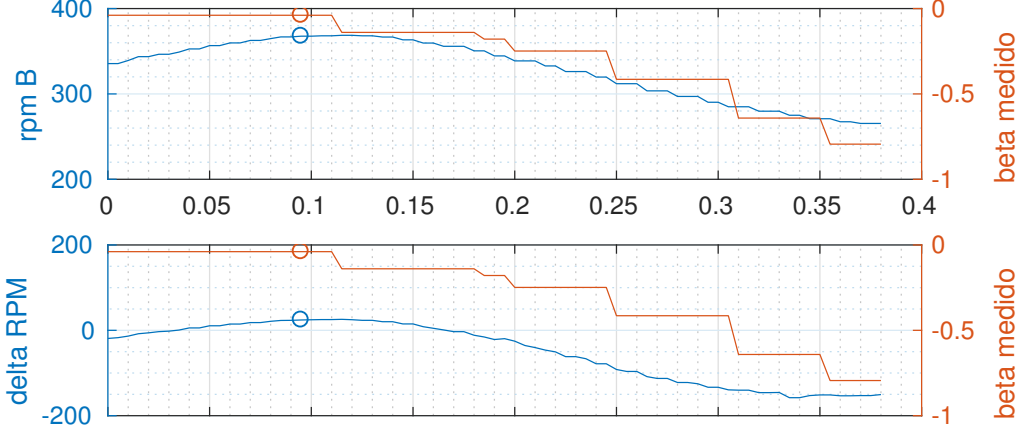
[picture p140: figure]
rpm B; delta RPM; beta medido
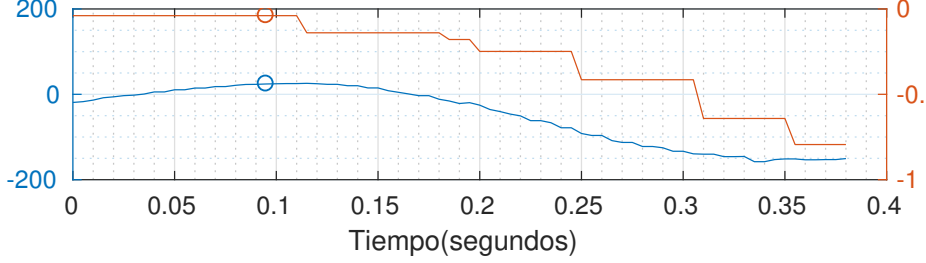
[picture p141: figure]
Tiempo(segundos)
