Seba-san/Trabajo_Final_Controlados/Posible_bibliografia/Bibliografia_SJ/capitulo6_predictor.pdf

Ingeniería Electrónica | 1 | CONTROL III

CONTROL DE PROCESOS CON RETARDOS

1. Introducción.

En capítulos anteriores se han estudiado y desarrollado controladores digitales para procesos sin retardo o con retardos pequeños tal que se puedan considerar incluidos dentro de la constante de tiempo del sistema. Para procesos cuyos retardos son comparables con estas constantes de tiempo, las técnicas desarrolladas no son aplicables en forma directa. Una excepción es el caso del controlador de tiempo finito, en donde se hizo una consideración especial para procesos con retardo. Por otra parte, los procesos con retardos son comunes de encontrar en la práctica, por lo tanto se justifica analizar este caso particular.

Los retardos, generalmente son producidos por el tiempo de transporte de energía o materia dentro del sistema. Otro origen de los retardos son las dinámicas de distintos elementos colocados a lo largo del proceso que, por efecto cascada se suman y generan entre la entrada y salida un retardo que puede ser considerable. Desde el punto de vista del control, se puede considerar un único retardo, que es la sumatoria de todos. En control digital el retardo se expresa en (1), donde d =1, 2,3,...m y T0
es el periodo de muestreo.
Retardo | 0 = d T | (1)
En este capítulo se presenta una solución a este problema de control que es conocida como “Predictor de Smith”. Esta solución permite utilizar técnicas ya conocidas para el diseño de controladores para sistemas sin retardo y adaptarlas a sistemas con retardo.
2. Modelos de Sistemas con Retardo.
Como ya se dijo, independientemente del origen del retardo, el efecto visto desde la entrada y salida es el mismo y por lo tanto en el modelo se puede considerar un único retardo que incluye a todos. El modelo de un sistema con retardo se puede expresar como una función de transferencia discreta (2) o como una ecuación en diferencias (3) .
( ) ( )
( )

d
P
Y z G z | b z
U z

−
= | = | (2)
y k | b u k d ( ) | ( | ) = | − | (3)
En general un proceso con retardo y dinámica adicional se puede expresar como lo indica la Ec. (4)
1 | 1 | 2
1 | 2
1 | 1 | 2
1 | 2
( ) | ( ) | ... ( )
( ) | ( ) | 1 | ...

m
d | m | d
p | m
m
Y z | B z | b z | b z | b z G z | z | z
U z | A z | a z | a z | a z
− | − | − | −
− | −
− | − | − | −
+ | + +
= | = | =
+ | + | + +

(4)

3. Principio de Smith.
El “Principio de Smith” plantea como objetivo de diseño lograr que la respuesta del sistema con retardo, tenga las mismas características dinámicas del sistema sin retardo, por ejemplo que tenga la misma respuesta a la entrada escalón, pero desplazada en el tiempo el valor del retardo. La Fig. 1 presenta la respuesta a una entrada escalón unitario para un sistema sin retardo y con retardo. Se puede observar que la salida con retardo tiene la mismas características dinámicas pero

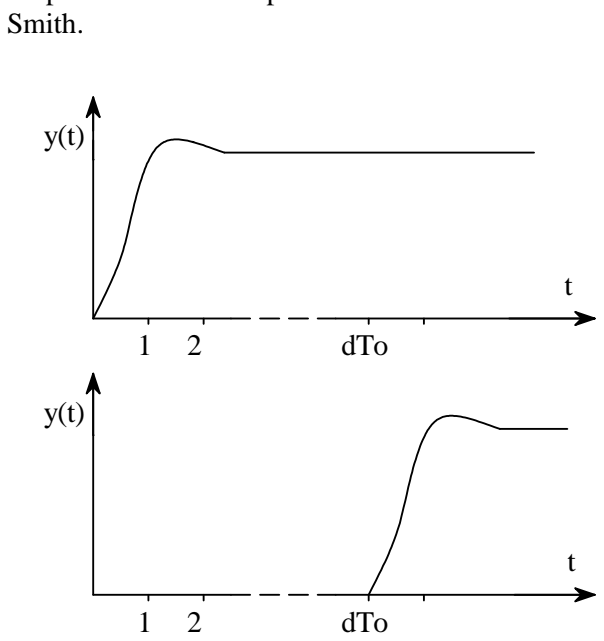
[picture p190: figure]
Smith.; dTo
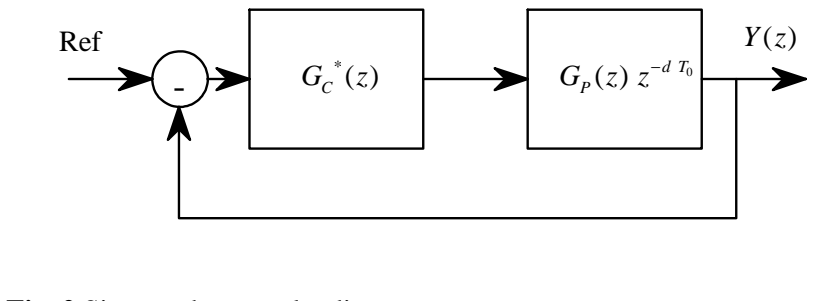
[picture p191: figure]
Ref

Ingeniería Electrónica | 2 | CONTROL III

desplazada en el tiempo el valor del retardo. El sistema presentado cumple con el principio de

4. Método de Smith.
En un sistema sin retardo, la función de transferencia de lazo cerrado es como lo indica (5). ( ) ( ) ( )
1 | ( ) ( )
C | P
T
C | P

G z G z G z
G z G z

=
+

(5)

Para un proceso con un retardo 0

d T , la función de transferencia de lazo cerrado para un sistema que cumpla con el Principio de Smith deberá ser como lo expresa (6). ( ) ( ) ( )
1 | ( ) ( )
C | P | d
T
C | P
G z G z G z | z
G z G z

−
=
+

(6)

El objetivo es diseñar un controlador * G z( ), presentado en la Fig. 2, de tal forma que el sistema de control cumpla con el principio de Smith. Esta condición está expresada en (7).

Fig. 1: Respuesta de un sistema que cumple el Principio de Smith

Fig. 2 Sistema de control a diseñar

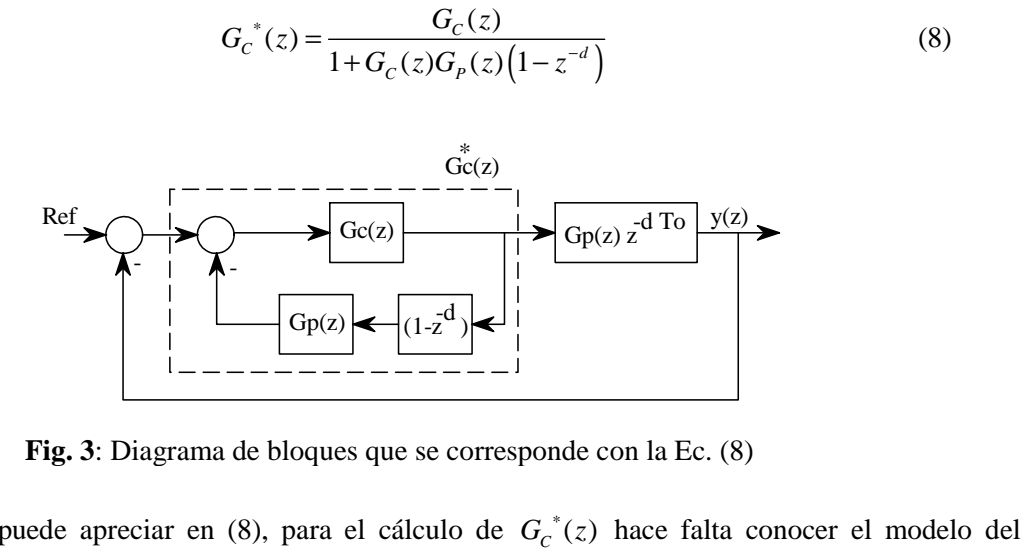
[picture p192: figure]
hace falta conocer el modelo del; Ref
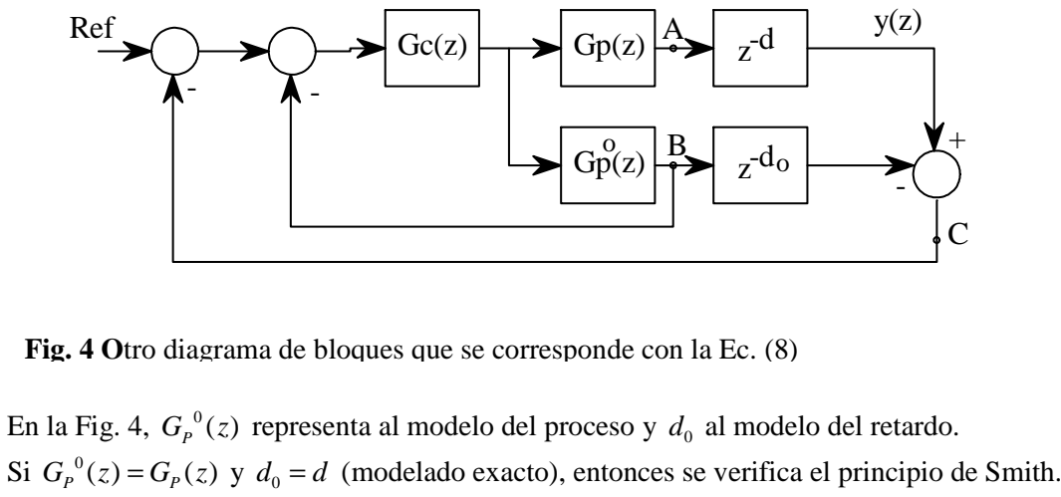
[picture p193: figure]
En la Fig. 4,; representa al modelo del proceso y 0; d al modelo del retardo.; Ref

Ingeniería Electrónica | 3 | CONTROL III

*

*

| ( ) ( ) | | ( ) ( )
1 | ( ) ( ) | 1 | ( ) ( )

d
C | P | C | P | d
d
C | P | C | P
G z G z z | G z G z
z
G z G z z G z G z

−
−
−

=
+ | +

(7)

De (7) se obtiene (8) que es la expresión del controlador buscado.

Como se puede apreciar en (8), para el cálculo de *
proceso, esto implica una previa identificación de la planta. La función de transferencia del controlador *
( ) G z C

corresponde a un diagrama de bloques como el mostrado en la Fig. 3.

Otra forma de presentar un controlador con Predictor de Smith para un proceso con retardo es el mostrado en la Fig. 4, donde se ha expresado la posible diferencia entre el modelo y la planta

d d = (modelado exacto), entonces se verifica el principio de Smith.

De la Fig. 4, se pueden hacer las siguientes observaciones:

Fig. 4 Otro diagrama de bloques que se corresponde con la Ec. (8)

Fig. 3: Diagrama de bloques que se corresponde con la Ec. (8)

Ingeniería Electrónica | 4 | CONTROL III
- El lazo interno realimenta al proceso en base a un modelo de la planta. Este lazo realiza el control como si los retardos no existieran y el valor instantáneo de la variable a controlar (punto A) fuera accesible. Este lazo funciona como un observador-predictor de la salida.
- El lazo externo sirve para realimentar los errores de modelado. Si el modelo del proceso y del retardo se corresponden exactamente con los correspondientes al sistema real, la señal en C es nula para condiciones iniciales iguales.

Resumiendo, el proceso de diseño de un controlador con predictor de Smith es el siguiente:

- Realizar el diseño del controlador para un proceso sin retardo.
- Obtener un modelo de la planta y del retardo.
- Obtener *
( ) G z C

La función de transferencia del sistema presentado en la Fig. 4 está expresada en (9).
( | ) ⁰ | 0 | 0

( ) ( ) ( )
1 | ( ) | ( ) | ( ) | ( ) | ( )
| | | | d
C | P
T | d | d
C | P | C | P | P

G z G z z G z
G z G z G z G z z G z z

−

− | −

=
+ | + | −

(9)

5. Necesidad de Precisión en el Modelado.
Si el modelado es exacto ( | ( ) | ( )
0 G z | G | z P | P = | y | 0

d d = ) se cumple (10) y observando (9) se verifica el principio de Smith, como lo demuestra (11).
( | )
0 | 0
( ) | ( ) | ( ) | 0 d | d G z G z z | G z z C | P | P
− | −
− | = | (10)
( ) ( ) ( )
1 ( ) ( )

d
C | P
T
C | P

G z G z z G z
G z G z

−
=
+

(11)

Cuando el modelado es inexacto, los polos del sistema cambian y de (9) pueden calcularse las raíces del sistema mediante (12).
( | )
0 | 0 | 0 1 | ( ) | ( ) | ( ) | ( ) | ( ) | 0 d | d d G z G z G z G z z | G z z | z C | P | C | P | P
− | −
- + | + | − | =

(12)

Por lo expuesto se desprende la necesidad de un modelado preciso del proceso y del retardo.

Ingeniería Electrónica | 5 | CONTROL III

Ejemplo Nº 1:
Para el proceso G z | b P ( ) = , con un tiempo de retardo | 0
d T en el lazo de control, diseñar:
a) Un controlador de tiempo finito para el sistema con retardo
b) Un controlador de tiempo finito aplicando Predictor de Smith
c) Un controlador PI para el sistema con retardo.
d) Un controlador PI aplicando predictor de Smith
a) Diseño de un controlador de tiempo finito para el sistema con retardo. El modelo del proceso se puede expresar como en (13).
( )
1 | 2 0 | 0 | ... d | d G z | b z | z | z | b z P
− | − | − | − = | = | + | + + | (13)
De (13) se calculan los parámetros de controlador:

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
; | 1 | 1 0 q a q = | = 0 ; | 1 0 | 1 d
p | b q = | =

El controlador de tiempo finito diseñado para el sistema con retardo queda como lo expresa (14)
( )

1
0 1

1

1 | 1 C | d | d
d
q q z | b G z
p z | z

−

− | −

+
= | =
− | −

(14)

b) Diseño con un controlador de tiempo finito para el sistema sin retardo y aplicar Predictor de Smith contemplando el retardo
Se puede descomponer el modelo del proceso con retardo como lo expresa (15)
( )
d | 1 | (d 1) G z | b z | b z z P
− | − | − −
= | = | (15)
Se calculan los parámetros del controlador de tiempo finito:

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
; | 1

1
p b 1
b

= =

El controlador de tiempo finito para el sistema sin retardo está expresado en
( ) 0
1
1

1

1 | 1 C | d
q | b G z
p z | z
− | −
= | =
− | −

(16)

El Predictor de Smith para este sistema queda expresado en

( ) | ( )
( ) ( ) | ( ) ( | )
( ) ( | )

1
*
1
1 | 1
1

1
1
1
1 | 1 | 1 | 1
1 | 1
1

C
C | d | d
C | P
d

b
G z | z | b G | z
G z G z | z | z
b
b z z
z

−
− − | −
− | − −
−
− = | = | =
+ | − | −
+ | −
−

(17)

Se observa de (14) y (17) se llega al mismo controlador por dos caminos diferentes:
- Considerando el retardo en el diseño del controlador de tiempo finito.
- Diseñando un controlador de tiempo finito para el sistema sin retardo y aplicando (8).

Ingeniería Electrónica | 6 | CONTROL III
c) Diseño de un controlador PI para G z | b P ( ) =

El controlador PI está expresado en (18), donde 0

q > 0 y (q q 0 | 1 + | >) 0
( )

1
0 1
1
1

C

q q z G z
z

−

−

+
=
−

(18)

La función de transferencia total del sistema es (19) y su ecuación característica (20).
( ) ( ) ( )
( )
( )

1
0 | 1
1 | 1
0 | 1 1 | 1
d | d | d
C
T | d | d | d
C
G z b z | q bz | q bz G z
G z b z | z | q bz | q z
− | | − | − +
− | − | − | − +

+
= | =
+ | − + | +

(19)

1
0 | 1 | 0
d | d z | z | q bz q b ⁺ | − − | + | + | = | (20)
d) Diseño de controlador PI y aplicación de Predictor de Smith para contemplar el retardo puro d
Aplicando (8) se obtiene el controlador (21) y la función de transferencia total (22).
( )
( | ) ( | ) ( | ) | ( )

1
0 1
1
1
* | 0 | 1
1 | 1
0 | 1 | 0 | 1 | 0 | 1
1

1
1 | 1 1 | 1
1
C | d | d
d

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

−
−
−
− | − | − +
−
−

+
− | +
= | =
+ | + | + | − − | −
+ | −
−

(21)

( ) | ( | )

1
0 | 1 | 1
1
0 | 1
1 | 1 | 1
0 | 1 | 0 | 1
1

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

−
−
−
− | −
− | − | −

−

+
+
− = | =
+ | − + | +
+
−

(22)

La ecuación característica de (22) es (23).
( | ) | (( | ) ( | ))
1 | 1 | 1
0 | 1 | 0 | 1 1 | 1 | 1 | 0 d | d | d | d
q b z | z | q bz | q b z q b | z ⁻ | − | −
+ | − | + | = + | + | − | = | (23)

Se observa que la ecuación característica tiene:

( )

1

0

1 raíces en elorigen
1-q 1 raíz en
1

d
b
q b
- −
- +

### 6. Sensibilidad a Errores del Modelo de Retardo

Para el controlador de tiempo finito ya calculado, (24) es la ecuación del controlador, (25) es el modelo de la planta y d 1
z

−
es el retardo.
( ) 1

1

1

C

b G z
z

−

=
−

(24)
( )
1 G z bz P

−
= | (25)
La ecuación característica del sistema total fue obtenida en (12):
( ) ( ) | ( ) ( ) | ( ) ( | )
0 | 0 | 0 1 | 0
d | d | d G z G | z G z G z z | G | z z | z C | P | C | P | P
− | − + | + | − | =

(26)
Asumiendo que se tiene incertidumbre solo en el retardo, entonces | ( ) | ( )
0 G z | G | z P | P = | y | 0

d d ≠ , la
ecuación característica (26) queda como lo expresa (27).

Ingeniería Electrónica | 7 | CONTROL III
( ) ( ) | ( ) ( )( | )
( ) ( ) | ( ) ( ) | ( ) ( )
| | 0

0

1
0
d | d | d
C | P | C | P
d | d | d d
C | P | C | P | C | P
G z G z G z G z z | z | z
z | G z G z z | G z G z G z G z z
− | −

−

- + | + | − | =
+ | + | − | =

(27)

En el caso analizado se tiene

0 | 0

1
1
d | d
d | d
- → −
- → −

obteniéndose,

0

0

1 | 1 | 1 | 1
1 | 1 | 1

1
1
1 | 1 | 1
1 | 1 | 1
1
1 | 1 | 1
1 | 1 | 0
1 | 1 | 1
d | d d
d | d d
b | b | b bz | z | bz | bz z
z | z | z

z
z | z
z | z | z
− | − | − | − | −
− | − | −

−
− | −
− | − | −
- | | / | / | / | + | + | − | = / | / | /
− | − | − | |
+ | − | =
− | − | −

(28)

Sacando factor común

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
se obtiene (29).

0 1 | 0 d | d d
z | z

−
+ − | = | (29)
Si 0
d | d = −1, se obtiene (30).
1 | 0 d
z | z + − = | (30)
Si 0
d | d = +1, se obtiene (31).
| 1
1 | 0 d
z | z −
+ − | = | (31)
Si | 0
d d = , | 0
d

z = (se obtienen d raíces en el origen).

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
se obtienen 2 raíces en

0.5 | 0.866
0.5 | 0.866

j
j
- +
- −

, es un sistema estable y se corresponde con

(32).

2

z | z − − =1 0 | (32)

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
se obtienen 3 raíces en

0.3412 1.1615
0.3412 1.1615
0.6823

j
j
− | +
− | −

, es un sistema inestable y se corresponde

con (33).

3

z | z − − =1 0 | (33)

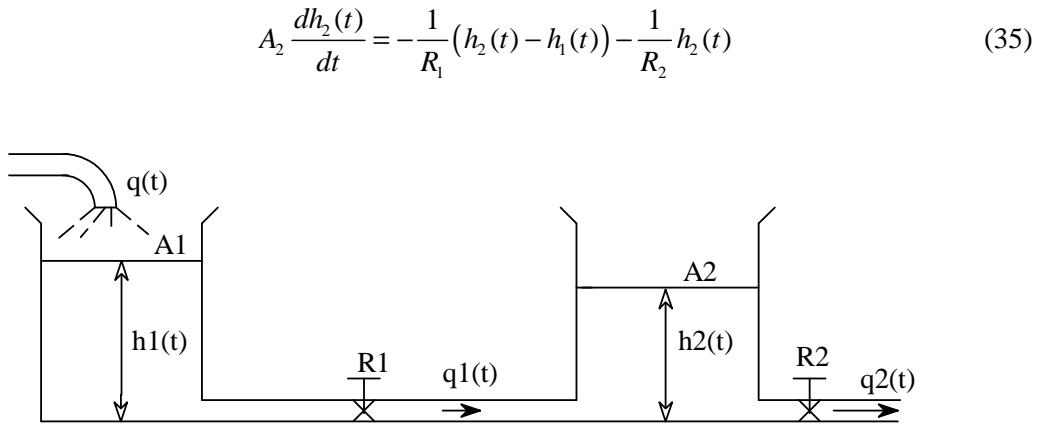
[picture p194: figure]

Ingeniería Electrónica | 8 | CONTROL III

Ejemplo Nº 2:
Se desea controlar el nivel del tanque 2 de la planta hidráulica presentada en la Fig. 5. El modelo matemático del proceso está descripto por (34) y (35). En el lazo de control existe un retardo total debido al sensor y al actuador de 2 segundos (D = 2s).
Desarrollar las siguientes actividades:
a) Ajustar un controlador PID para la planta sin retardo
b) Ajustar un controlador PID para la planta con retardo.
c) Aplicar Predictor de Smith con un modelado exacto de la planta y del retardo.
d) Aplicar Predictor de Smith cuando el modelo de la planta tiene un error del 20%.
e) Aplicar Predictor de Smith cuando el modelo del retardo tiene un error del 20%.
f) Obtener conclusiones.
( | ) ¹
1 | 2 | 1
1
( ) | 1
( ) | ( ) | ( ) dh t A | h t h t | q t
dt | R
= | − | + | (34)
( | ) ²

Donde: 1 A = 2 , 2 A = 2 , 1

1
3

R = , 2

1
4

R =

De (34) y (35) operando y reemplazando por los valores de los parámetros se obtiene la función de transferencia (36).
( ) | ( )
( ) | ( | )
2 | 2
2 | 2
1 2 1 2 | 2 1 | 1 1 | 2 2

0.75
1 | 5 3
H s | | R
G s
Q s | R R A A s | R A A R A R s | s | s
= | = | =
+ | + | + | + | + +

(36)

a) Ajustar un controlador PID para la planta sin retardo
Se ensaya el proceso a lazo abierto con una entrada escalón, de la respuesta temporal obtenida, se determinan los valores de TU

, TG

, KE

y posteriormente con tablas y realizando ajustes se
obtienen los siguientes parámetros del controlador PID: K = 0.85 , | 0.0835 TD = | , | 0.555 KI = | ,
0 T = 0.5.
El diagrama de bloques del sistema simulado lo muestra la Fig. 6 y la respuesta del sistema se presenta en la Fig. 7. Se observa que el sistema se establece aproximadamente a los 1.8s.

Fig. 5: Planta hidráulica

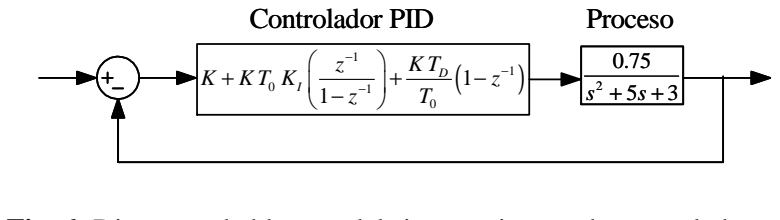
[picture p195: figure]
Controlador PID; Proceso
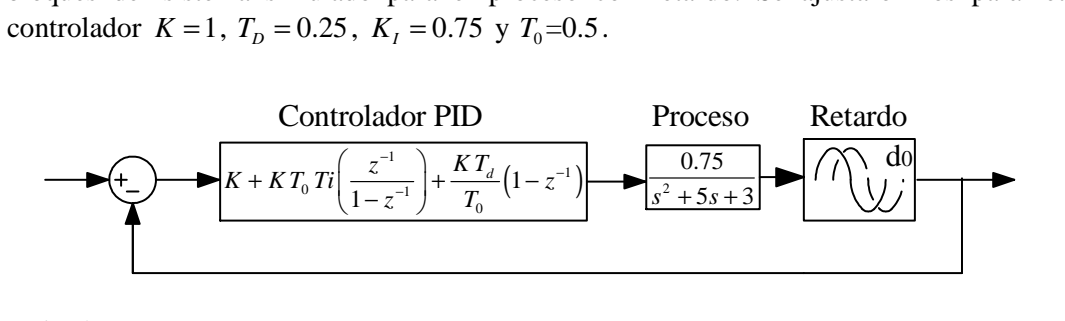
[picture p196: figure]
controlador K =1,; Controlador PID; Proceso; Retardo

Ingeniería Electrónica | 9 | CONTROL III
b) Ajustar un controlador PID para la planta con retardo
Se ajusta un controlador PID para el sistema con retardo. La Fig. 8 presenta el diagrama de bloques del sistema simulado para el proceso con retardo. Se ajustaron los parámetros del

La salida del sistema se presenta en la Fig. 9. Se observa de la respuesta temporal de la salida, que el sistema se establece aproximadamente a los 21 s.

Fig. 6: Diagrama de bloques del sistema sin retardo controlado con un PID

0 | 0.5 | 1 | 1.5 | 2 | 2.5 | 3 | 3.5 | 4 | 4.5 | 5

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
SISTEMA SIN RETARDO CONTROLADO CON PID

Tiempo [Seg]

Altura del Tanque 2 [m]

Fig. 7: Respuesta del sistema sin retardo controlado con un PID

Fig. 8: Diagrama de bloques del controlador PID aplicado a un proceso con retardo

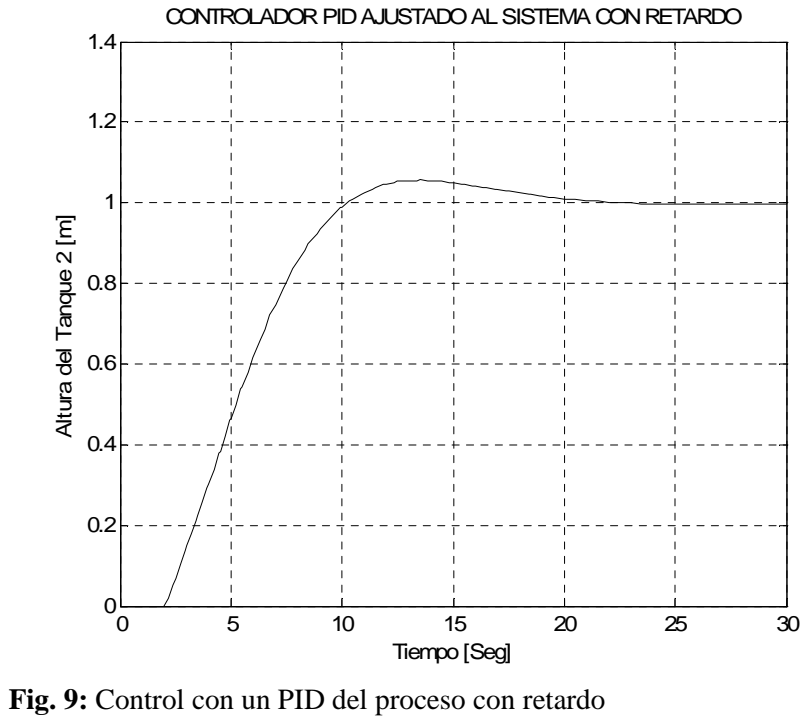
[picture p197: figure]
Tiempo [Seg]; Altura del Tanque 2 [m]

Ingeniería Electrónica | 10 | CONTROL III
c) Aplicar Predictor de Smith con un modelado exacto de la planta y del retardo.
Se aplica Predictor de Smith al sistema con retardo. El PID se ajustó con los parámetros que se
obtuvieron cuando no tenía retardo ( K = 8.35 , | 0.0835 TD = | , K =0.555 I

, 0 T = 0.5). La respuesta temporal de la salida es presentada en la Fig. 10. Se observa que el tiempo de establecimiento es aproximadamente 3.8 s.

d) Aplicar Predictor de Smith cuando el modelo del proceso tiene un error del 20%
Se aplica Predictor de Smith en el caso de que el modelo del proceso tiene un error del 20% en sus parámetros ( 1 A = 2.4 , 2 A = 2.4 , 1 R = 0.4, 2 R = 0.3). La respuesta temporal obtenida es presentada en la Fig. 11.

CONTROLADOR PID AJUSTADO AL SISTEMA CON RETARDO

Fig. 9: Control con un PID del proceso con retardo

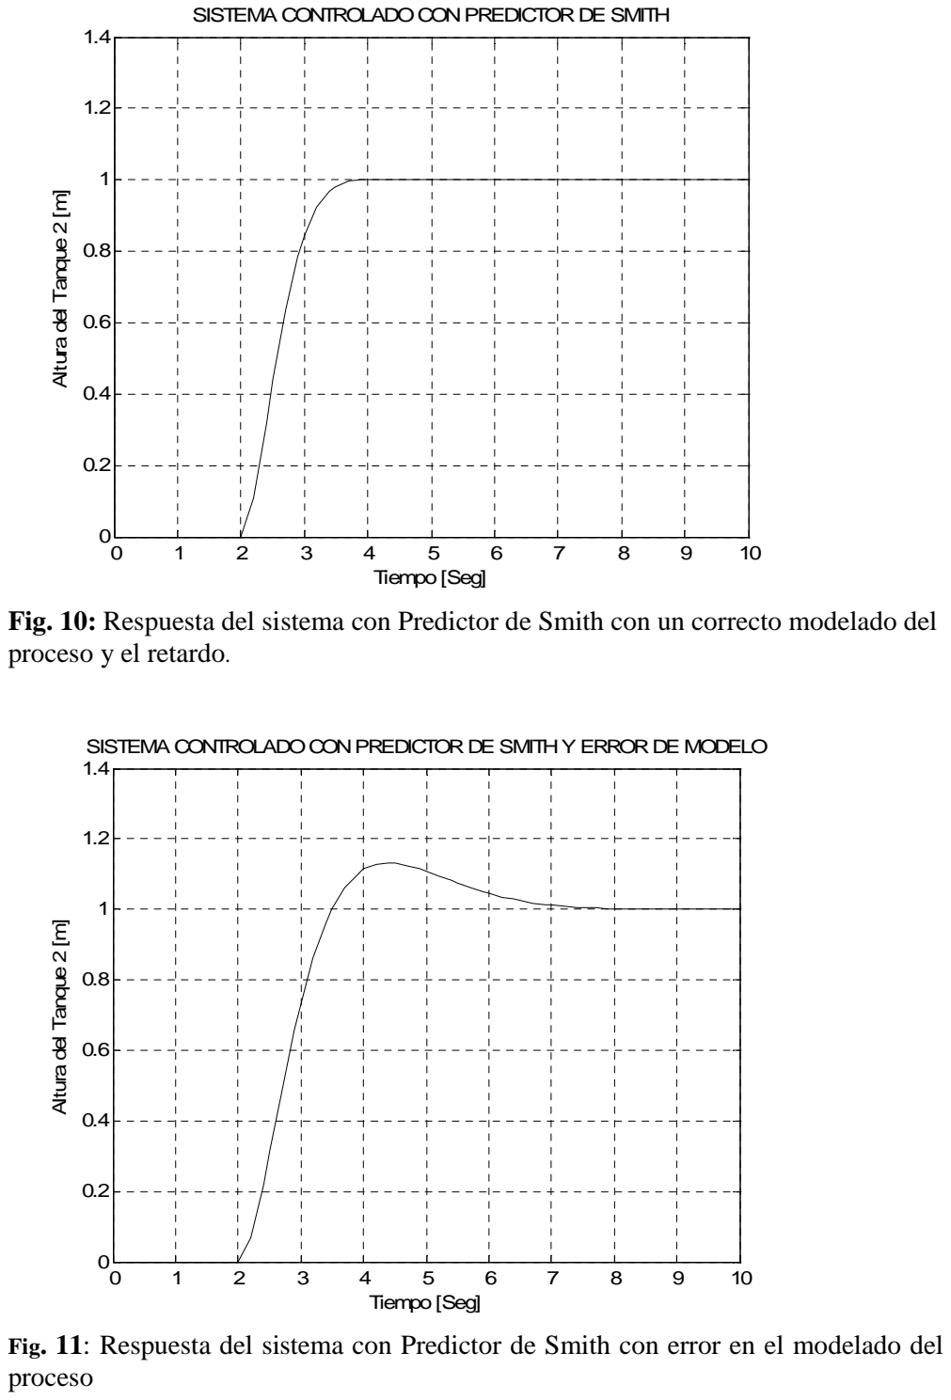
[picture p198: figure]
Tiempo [Seg]; Altura del Tanque 2 [m]; proceso y el retardo.; proceso

Ingeniería Electrónica | 11 | CONTROL III

SISTEMA CONTROLADO CON PREDICTOR DE SMITH

Fig. 10: Respuesta del sistema con Predictor de Smith con un correcto modelado del

SISTEMA CONTROLADO CON PREDICTOR DE SMITH Y ERROR DE MODELO

Fig. 11: Respuesta del sistema con Predictor de Smith con error en el modelado del

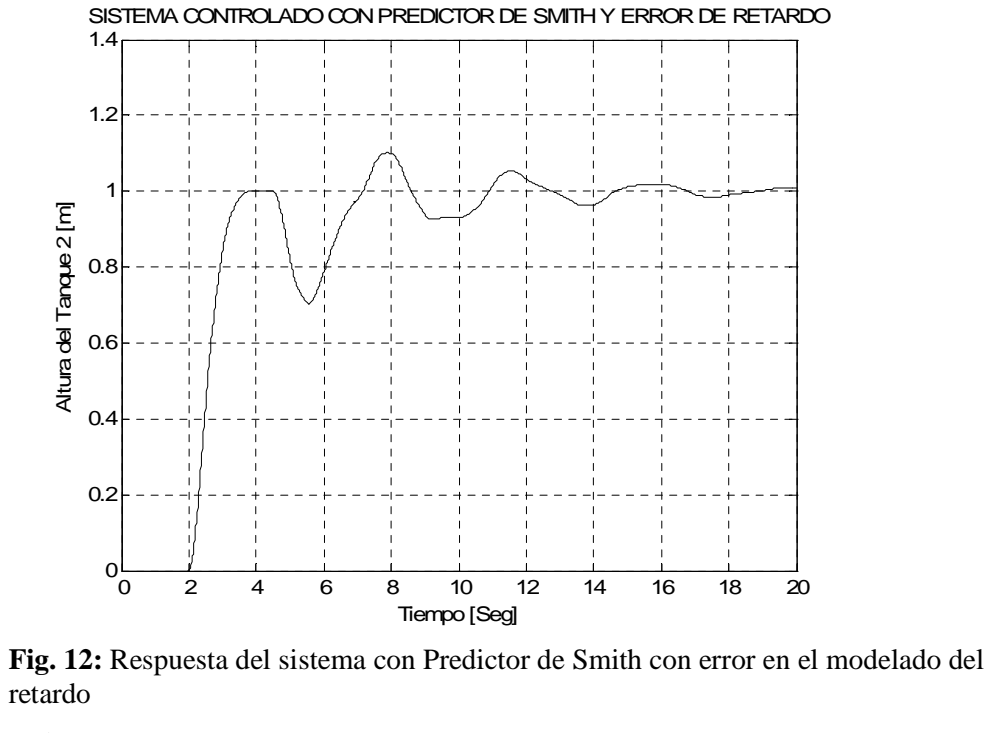
[picture p199: figure]
Tiempo [Seg]; Altura del Tanque 2 [m]; retardo

Ingeniería Electrónica | 12 | CONTROL III
e) Aplicar Predictor de Smith cuando el modelo del retardo tiene un error de 20%.
Se aplica Predictor de Smith para el caso de que el modelo del retardo tiene un error del 20% (d = 2.2s). La respuesta del sistema controlado se muestra en la Fig. 12. El sistema es oscilante hasta llegar a la referencia.
f) Conclusiones.
Del desarrollo del presente ejercicio se pueden extraer las siguientes conclusiones:
- De la Fig. 10 se observa que el tiempo de establecimiento que se logra en el sistema con retardo aplicando Predictor de Smith es de 3.8 segundos, mientras que si se ajusta un controlador PID para el mismo sistema se logra en aproximadamente 21 segundos (Fig. 9).
- El tiempo de establecimiento que se consigue con un Predictor de Smith es la suma de la respuesta del sistema sin retardo (1.8 seg.) y el valor del retardo (2 seg.).
- Cuando hay errores en el modelado, Fig. 11, la respuesta del sistema con Predictor de Smith se degrada (hay sobreimpulso y el tiempo de establecimiento es mayor) pero puede ser una respuesta aceptable. Esto se debe a que el PID es tolerante a variaciones en el proceso.
- Cuando se cometen errores en el modelado del retardo, Fig. 12, la respuesta del sistema es oscilante y tarda más en llegar a la referencia.
- Se puede decir en forma general que es más importante tener un buen modelo del retardo que de la planta.

SISTEMA CONTROLADO CON PREDICTOR DE SMITH Y ERROR DE RETARDO

Fig. 12: Respuesta del sistema con Predictor de Smith con error en el modelado del
