Seba-san/Trabajo_Final_Controlados/Posible_bibliografia/Bibliografia_SJ/TZ por Integral de Convolución.pdf

### Obtención de la Transformada Z por Integral de Convolución

La evaluación de la integral de convolución en el semiplano izquierdo permite disponer de la transformada Z de una función de TD a partir de la transformada de Laplace de función de tiempo continuo corresponiente. Para esto se considera:

F z = residuos de

F s z
z − e

Ts

en los polos de F(s)

Si el polo pi es simple, entonces el residuo es:

Ki = lims→pi

s − pi

F s

z
z − e

Ts

Si el polo pi es múltiple (de grado ni ) entonces:

Ki = lims→pi

1
ni − 1 !

d

ni−1
ds

ni−1

s − pi

niF s

z
z − e

Ts

EJEMPLO

Calcule la transformada z de la función escalón x t = u(t)

Sabemos que x s =

1
s

Luego

x z = lims→0

s − 0

1
s

z
z − e

Ts

=

z
z − 1

Que coincide con el valor que se puede obtener de la tabla.
