Seba-san/Trabajo_Final_Controlados/Archivos_Varios/Foto_transistor.png

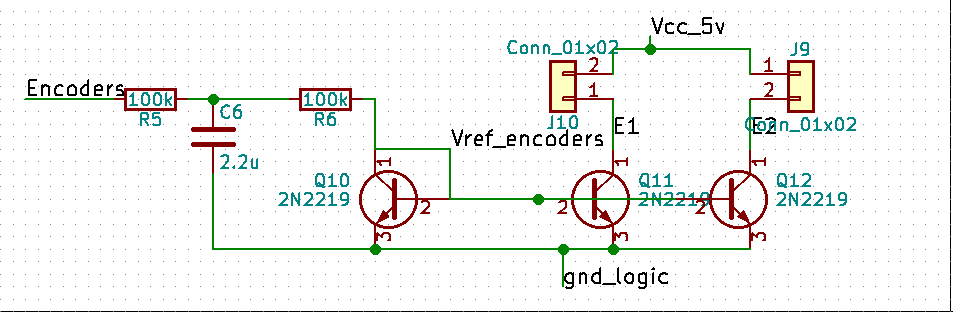
Archivos_Varios/Foto_transistor.png
