Seba-san/Trabajo_Final_Controlados/fotos-varias/20180415_150921.jpg

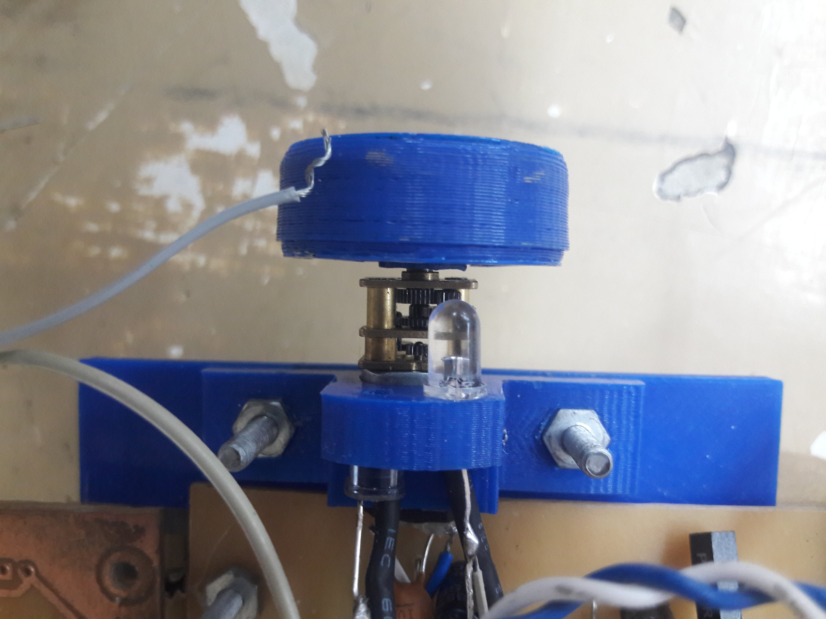
fotos-varias/20180415_150921.jpg
