Seba-san/Trabajo_Final_Controlados/fotos-varias/20180415_150932.jpg

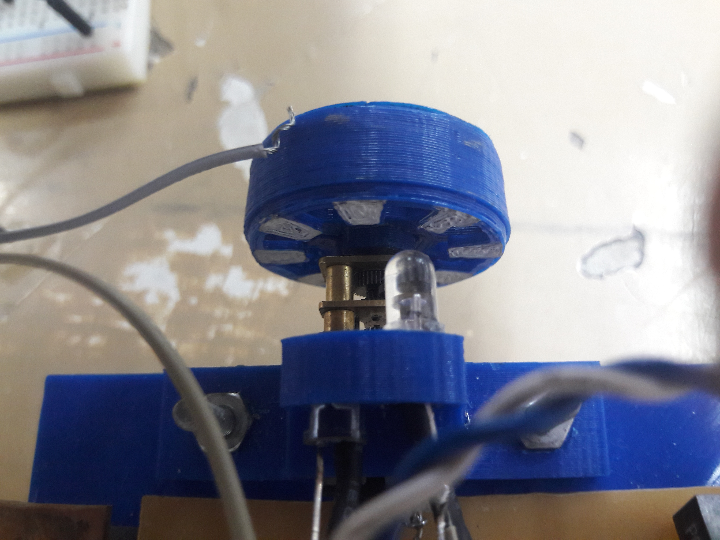
fotos-varias/20180415_150932.jpg
