Seba-san/Trabajo_Final_Controlados/fotos-varias/20180415_152713.jpg

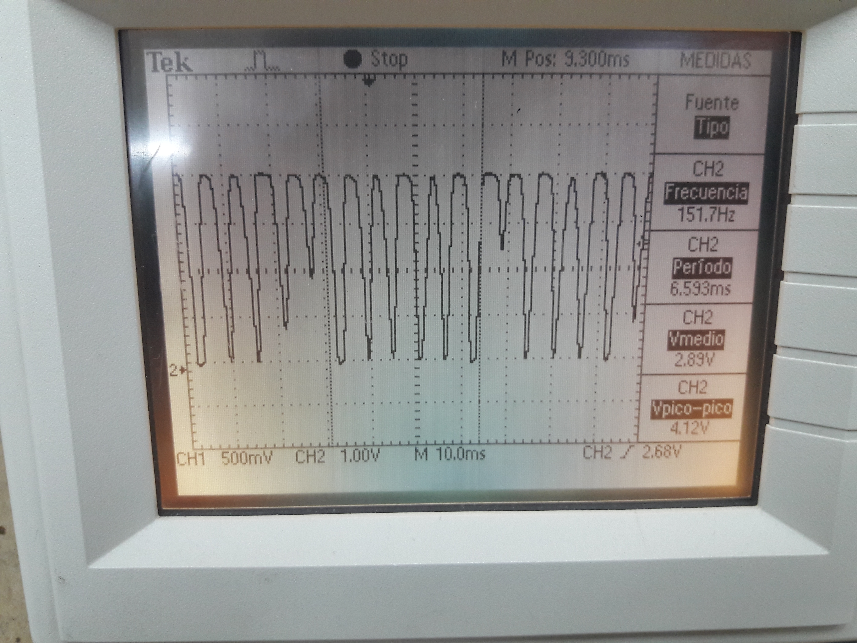
fotos-varias/20180415_152713.jpg
