Seba-san/Trabajo_Final_Controlados/fotos-varias/20180415_152946.jpg

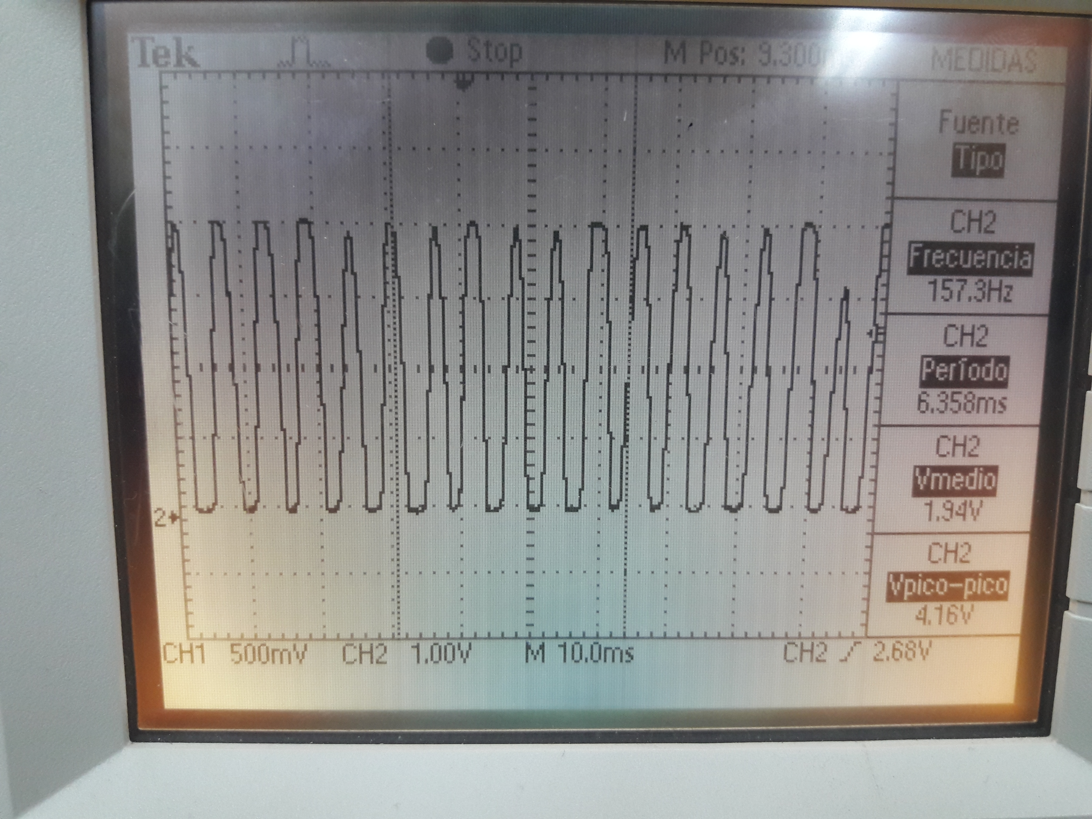
fotos-varias/20180415_152946.jpg
