Seba-san/Trabajo_Final_Controlados/fotos-varias/20180415_201951.jpg

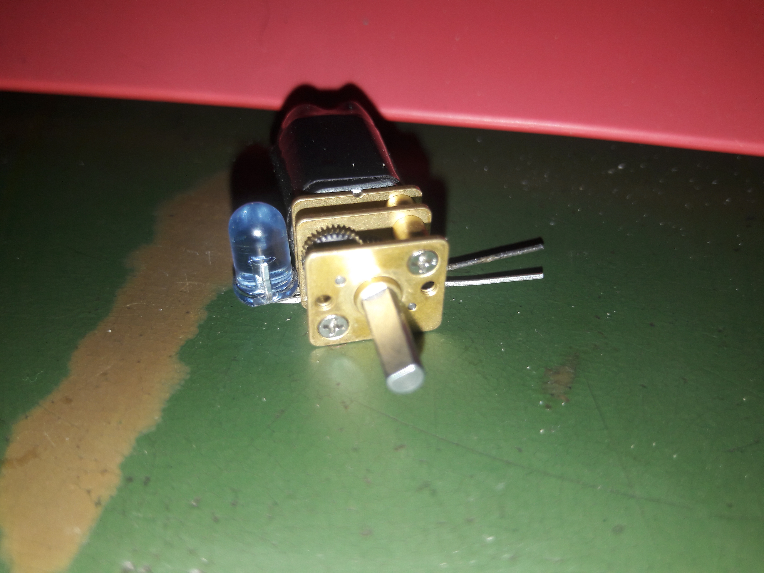
fotos-varias/20180415_201951.jpg
