Seba-san/Trabajo_Final_Controlados/fotos-varias/20180726_155523.jpg

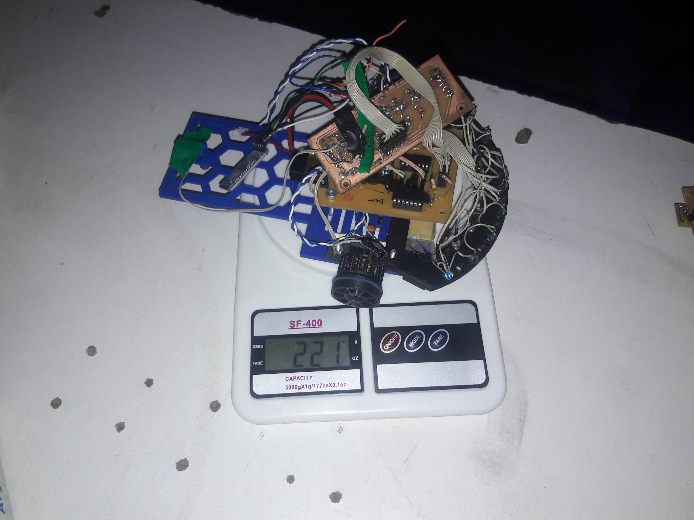
fotos-varias/20180726_155523.jpg
