Seba-san/Trabajo_Final_Controlados/Informe/Pre_informe/imagenes/20180720_015623.jpg

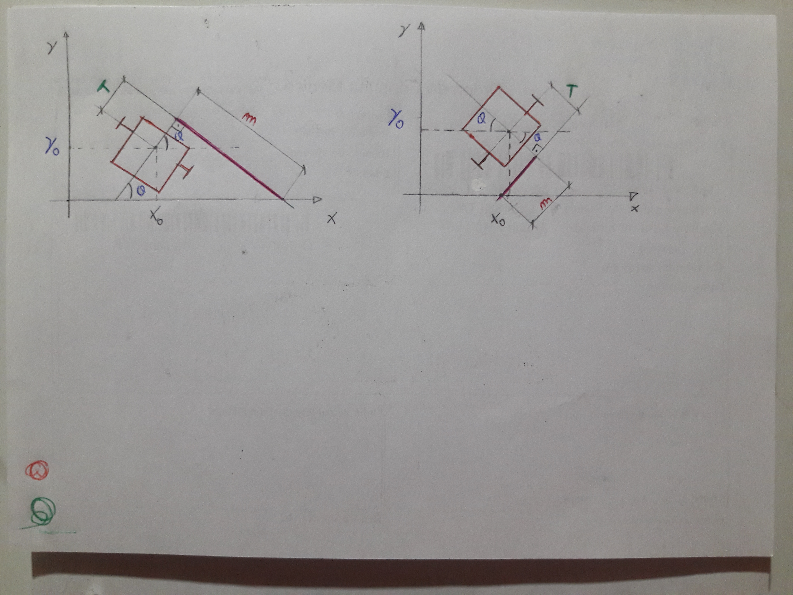
Informe/Pre_informe/imagenes/20180720_015623.jpg
