Seba-san/Trabajo_Final_Controlados/Informe/Pre_informe/imagenes/carrito1.png

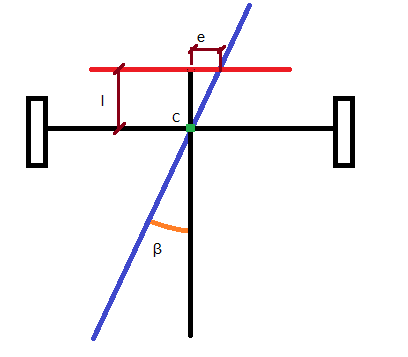
Informe/Pre_informe/imagenes/carrito1.png
