Seba-san/Trabajo_Final_Controlados/Informe/Pre_informe/imagenes/circuitoSensorLinea.png

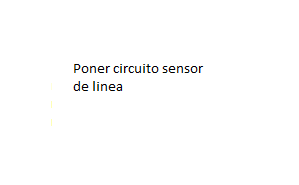
Informe/Pre_informe/imagenes/circuitoSensorLinea.png
