Seba-san/Trabajo_Final_Controlados/Informe/Pre_informe/imagenes/EstructurasSensores.png

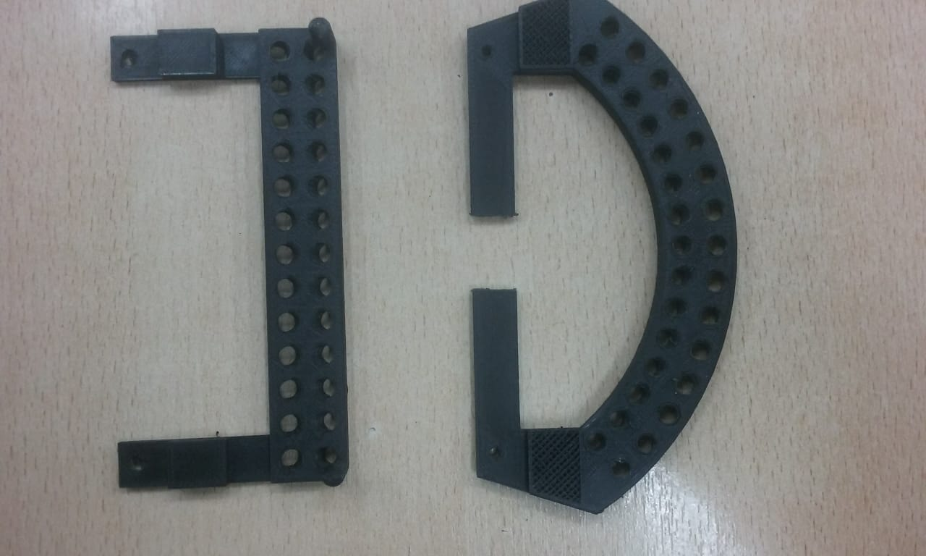
Informe/Pre_informe/imagenes/EstructurasSensores.png
