Seba-san/Trabajo_Final_Controlados/Informe/Pre_informe/imagenes/piezas.jpeg

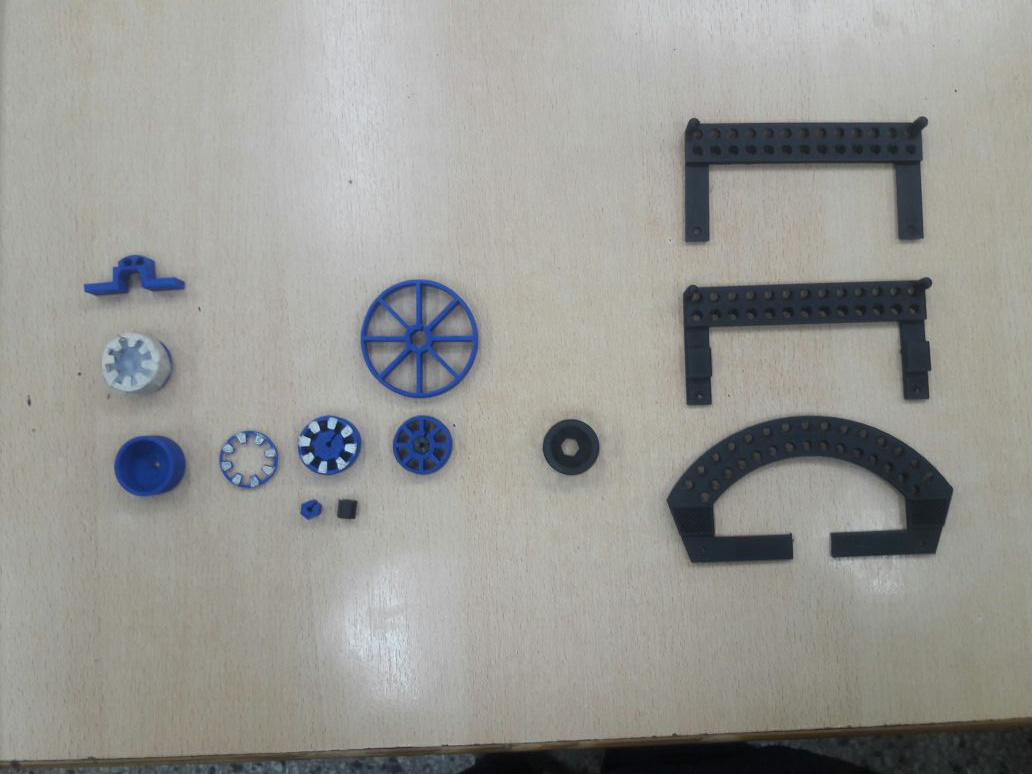
Informe/Pre_informe/imagenes/piezas.jpeg
