Seba-san/Trabajo_Final_Controlados/Informe/Pre_informe/imagenes/sens_rebotando.png

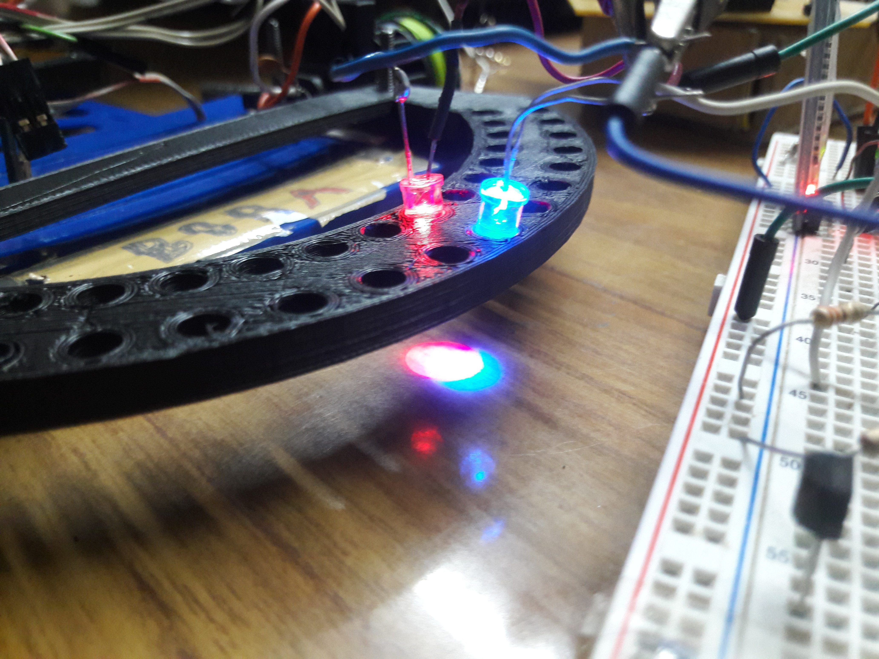
Informe/Pre_informe/imagenes/sens_rebotando.png
