Seba-san/Trabajo_Final_Controlados/Informe/Pre_informe/imagenes/sensorLinea.png

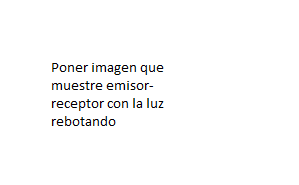
Informe/Pre_informe/imagenes/sensorLinea.png
