Seba-san/Trabajo_Final_Controlados/Mediciones/180423182356_resp_escalon.png

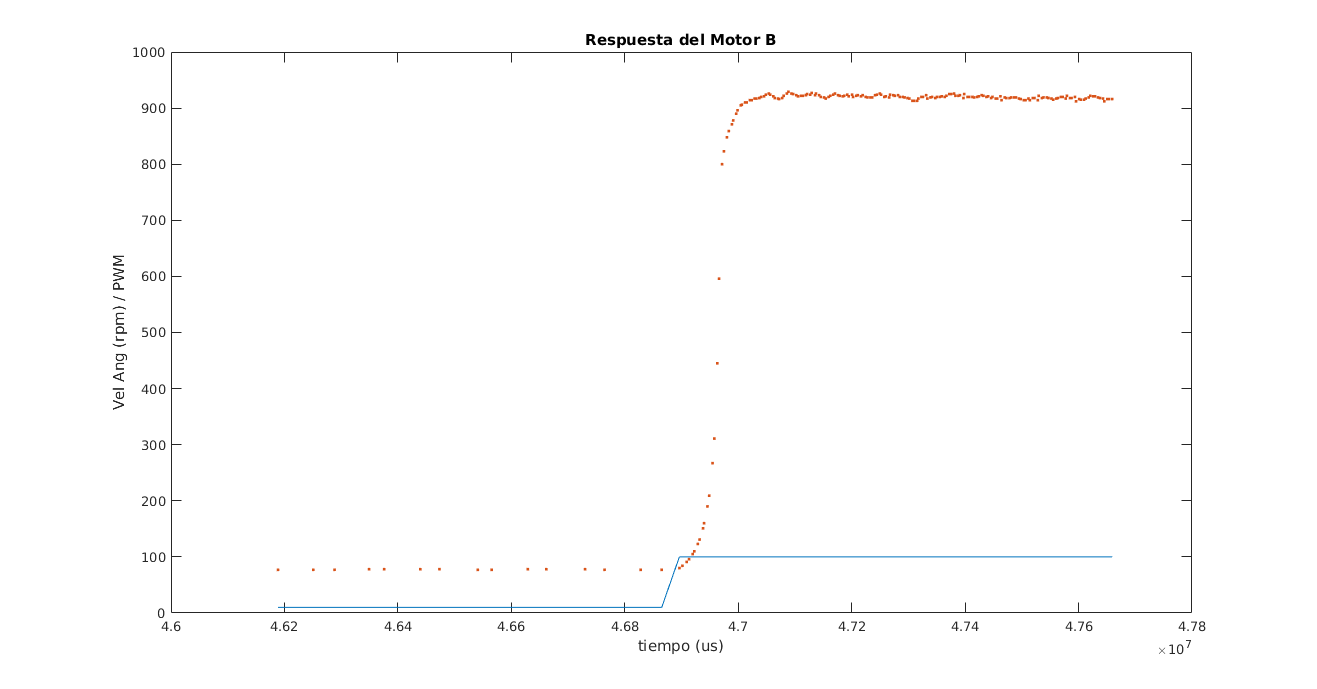
Mediciones/180423182356_resp_escalon.png
