Seba-san/Trabajo_Final_Controlados/Mediciones/control PI setpoint=200.png

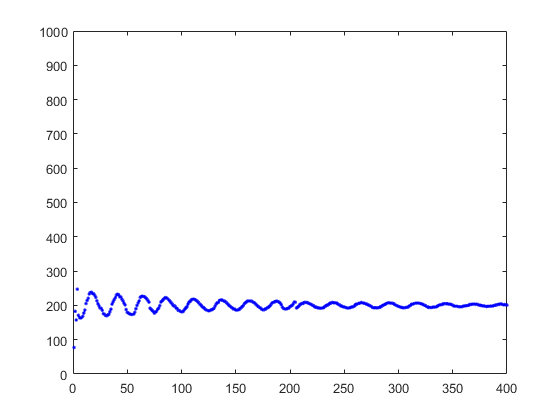
Mediciones/control PI setpoint=200.png
