Seba-san/Trabajo_Final_Controlados/Mediciones/control PI setpoint=500.png

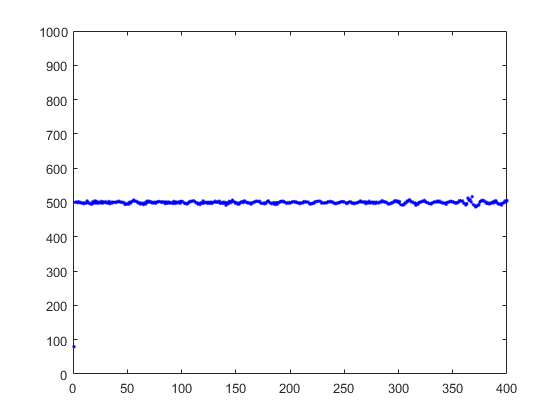
Mediciones/control PI setpoint=500.png
