Seba-san/Trabajo_Final_Controlados/Mediciones/control PI setpoint=800.png

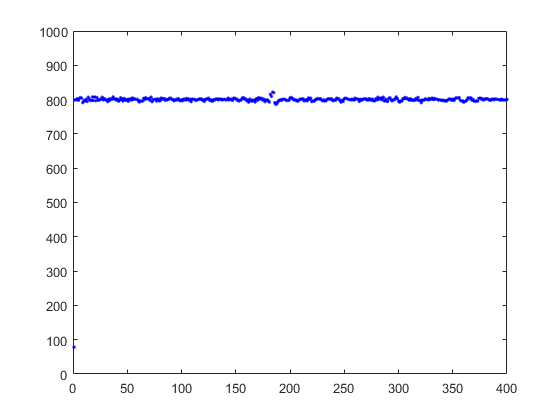
Mediciones/control PI setpoint=800.png
