Seba-san/Trabajo_Final_Controlados/modelos_3d/Ultima_version/Proyecto BORA/Piezas/breadboard-small-1.snapshot.2/BREADBOARD_350_POS.jpg

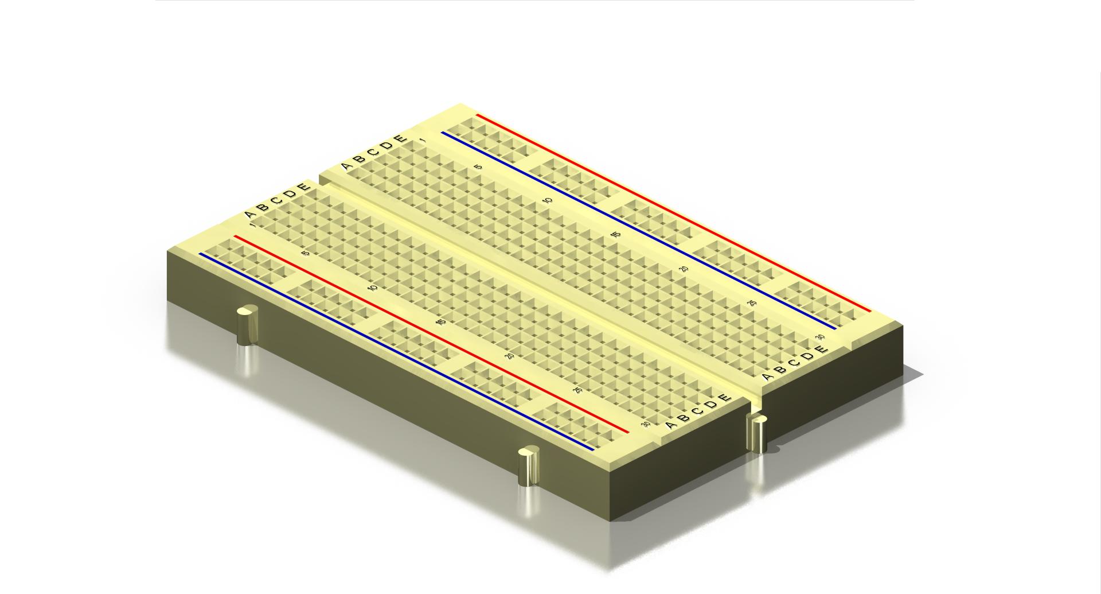
modelos_3d/Ultima_version/Proyecto BORA/Piezas/breadboard-small-1.snapshot.2/BREADBOARD_350_POS.jpg
