Seba-san/Trabajo_Final_Controlados/modelos_3d/Ultima_version/Proyecto BORA/Piezas/MotorV2/mini dc geared motor02.JPG

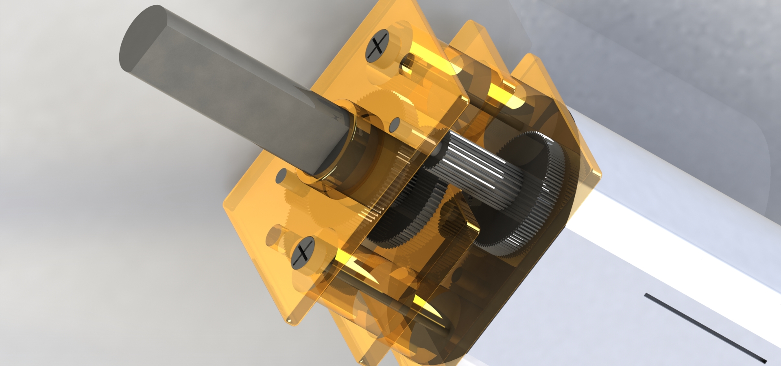
modelos_3d/Ultima_version/Proyecto BORA/Piezas/MotorV2/mini dc geared motor02.JPG
