Seba-san/Trabajo_Final_Controlados/modelos_3d/Ultima_version/Proyecto BORA/Piezas/MotorV2/motorDC02.jpg

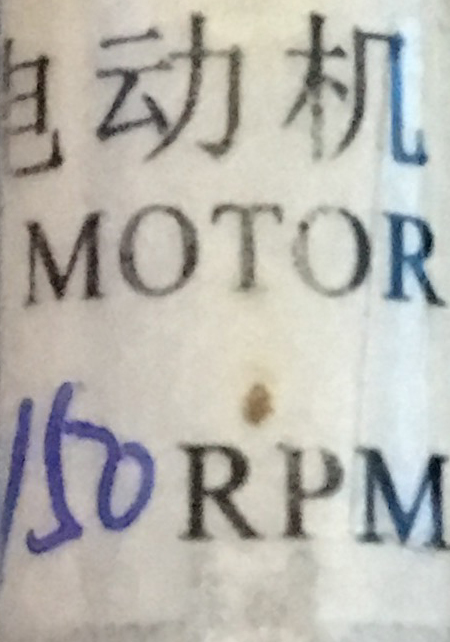
modelos_3d/Ultima_version/Proyecto BORA/Piezas/MotorV2/motorDC02.jpg
