Seba-san/Trabajo_Final_Controlados/modelos_3d/Ultima_version/Proyecto BORA/Piezas/MotorV2/motorDC03.jpg

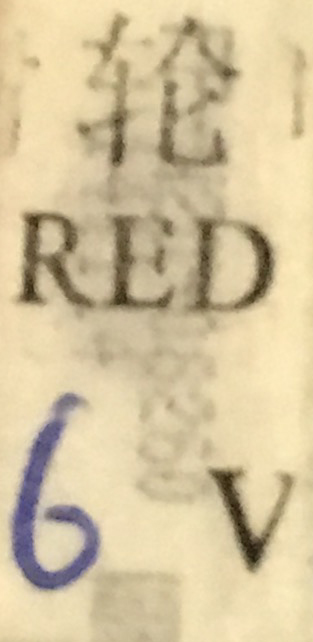
modelos_3d/Ultima_version/Proyecto BORA/Piezas/MotorV2/motorDC03.jpg
