Seba-san/Trabajo_Final_Controlados/pcb_mother/conexionado_esp.png

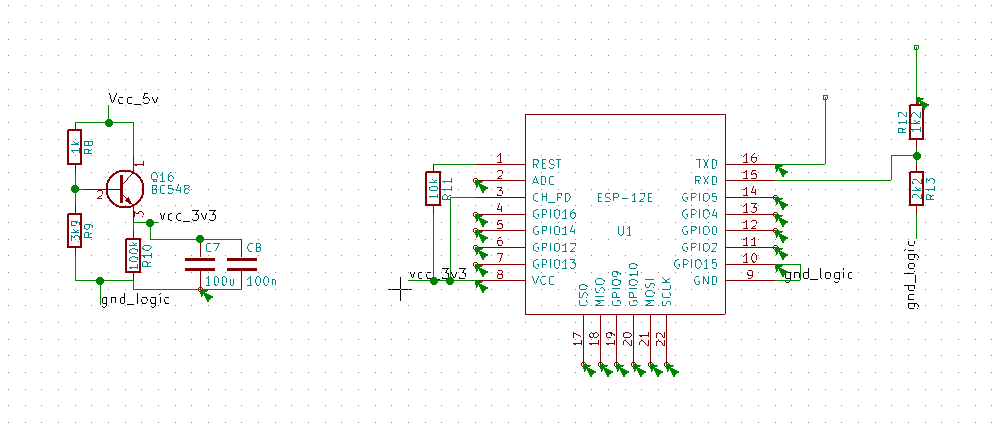
pcb_mother/conexionado_esp.png
