Seba-san/Trabajo_Final_Controlados/pcb_mother/Final.png

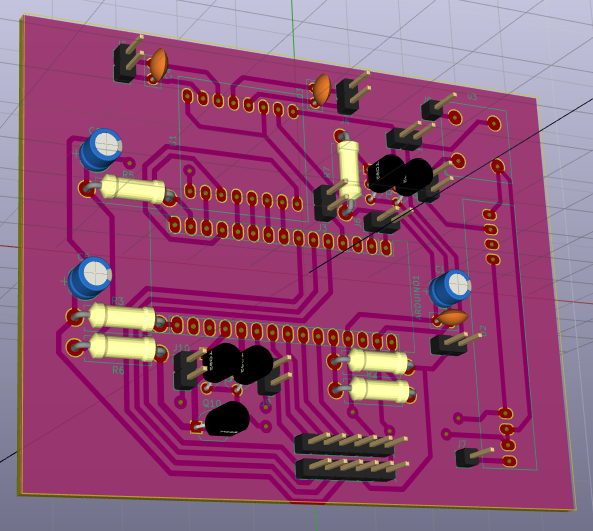
pcb_mother/Final.png
