Seba-san/Trabajo_Final_Controlados/registros/20180203_221103.jpg

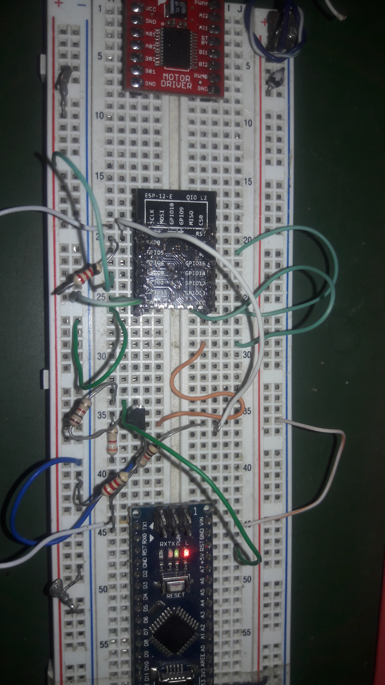
registros/20180203_221103.jpg
