Seba-san/Trabajo_Final_Controlados/registros/20180205_203101.jpg

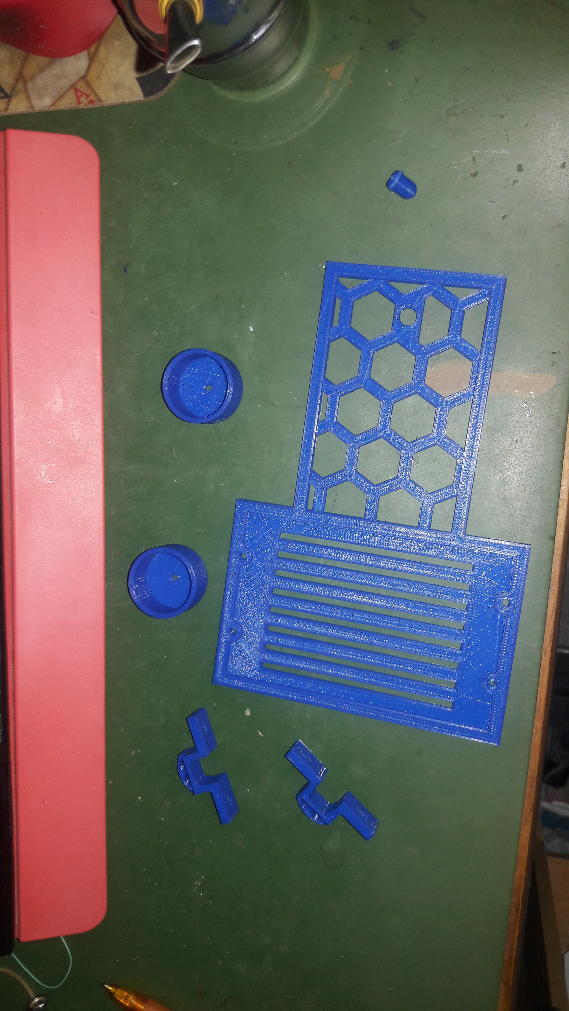
registros/20180205_203101.jpg
