Seba-san/Trabajo_Final_Controlados/registros/20180206_191756.jpg

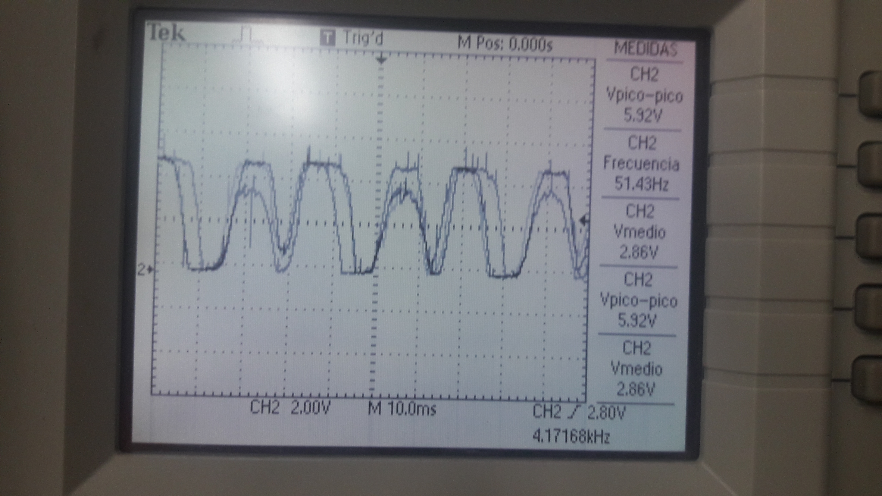
registros/20180206_191756.jpg
