Seba-san/Trabajo_Final_Controlados/registros/20180206_192858.jpg

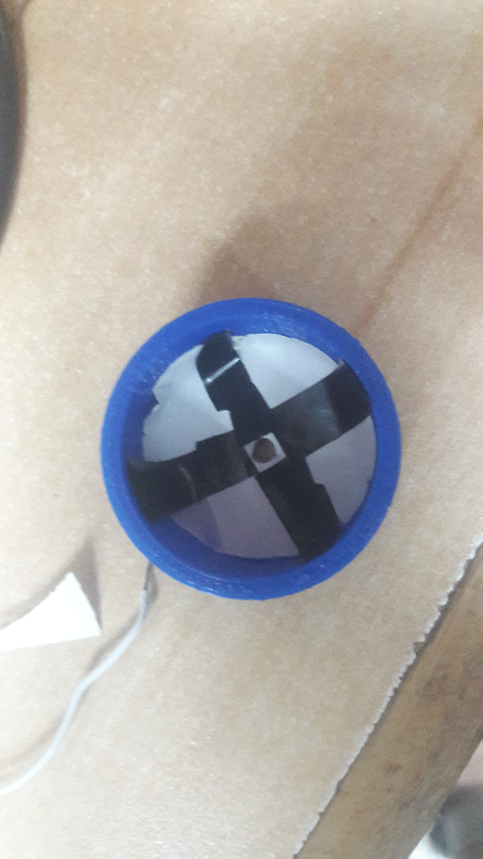
registros/20180206_192858.jpg
