Seba-san/Trabajo_Final_Controlados/registros/20180207_185513.jpg

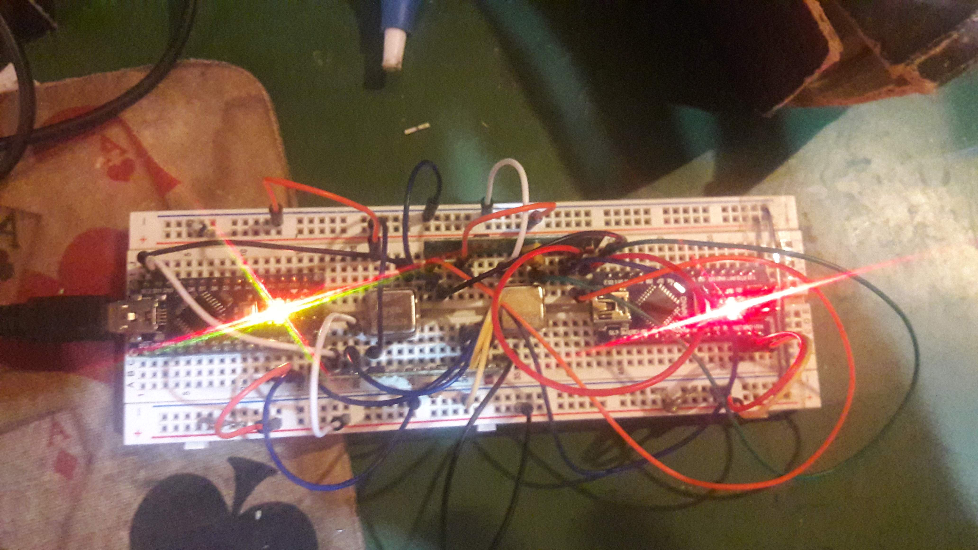
registros/20180207_185513.jpg
