Seba-san/Trabajo_Final_Controlados/registros/20180207_185523.jpg

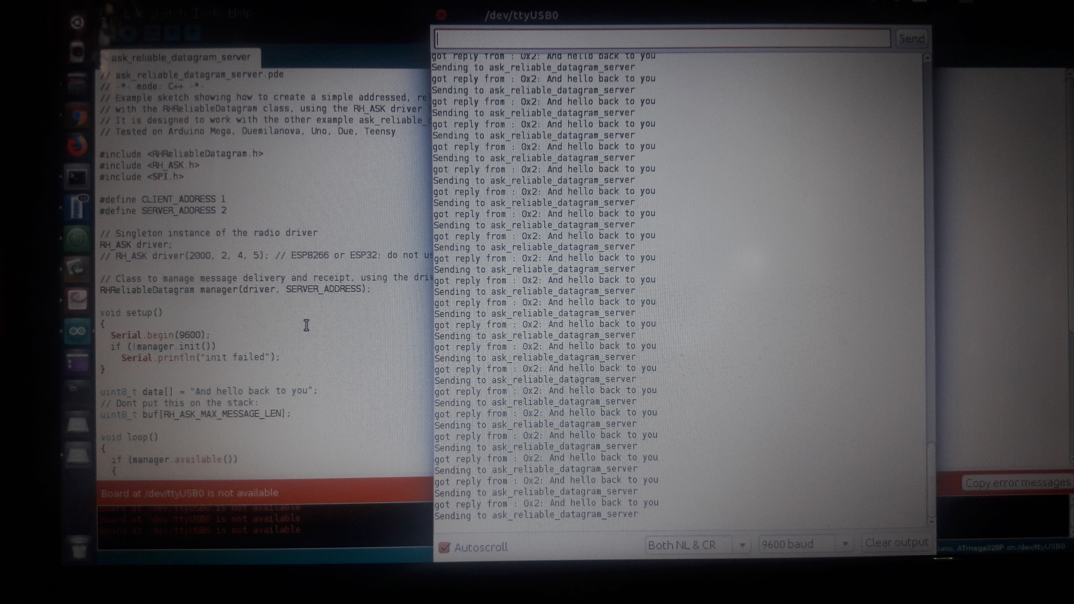
registros/20180207_185523.jpg
