Seba-san/Trabajo_Final_Controlados/registros/IMG-20180201-WA0000.jpg

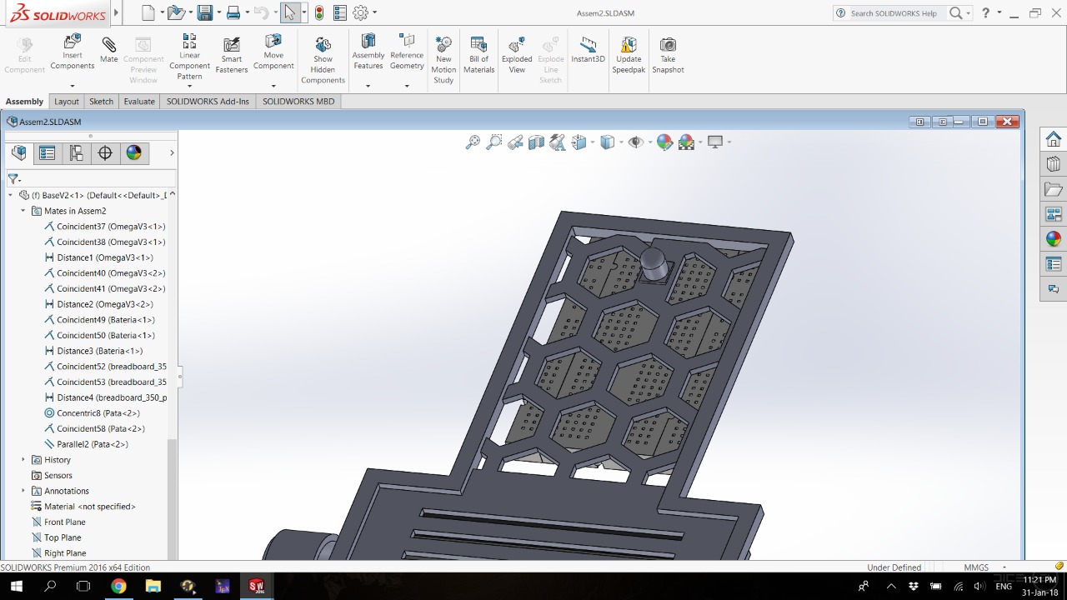
registros/IMG-20180201-WA0000.jpg
