Seba-san/Trabajo_Final_Controlados/registros/IMG-20180201-WA0002.jpg

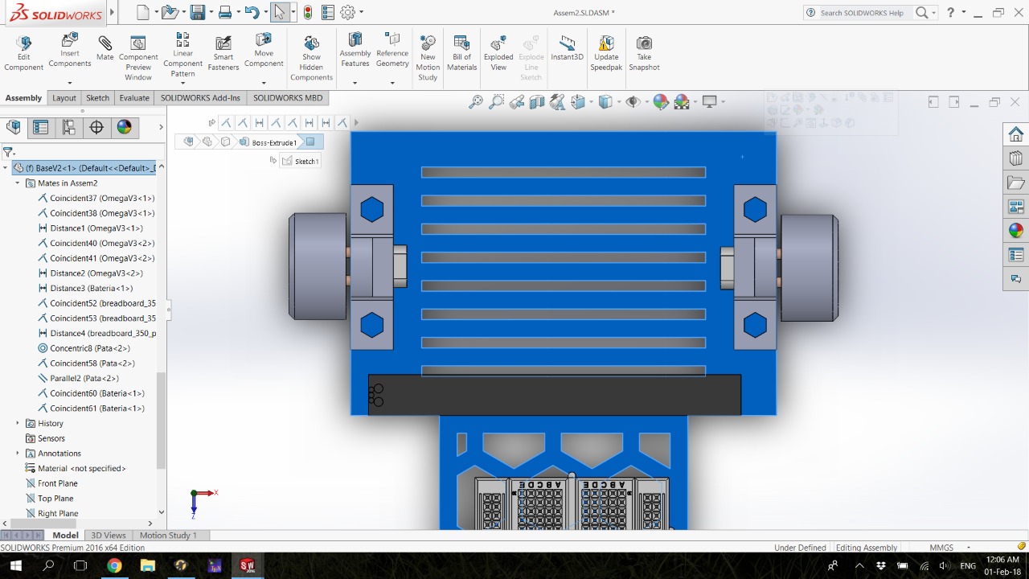
registros/IMG-20180201-WA0002.jpg
