Seba-san/Trabajo_Final_Controlados/registros/IMG-20180203-WA0002.jpeg

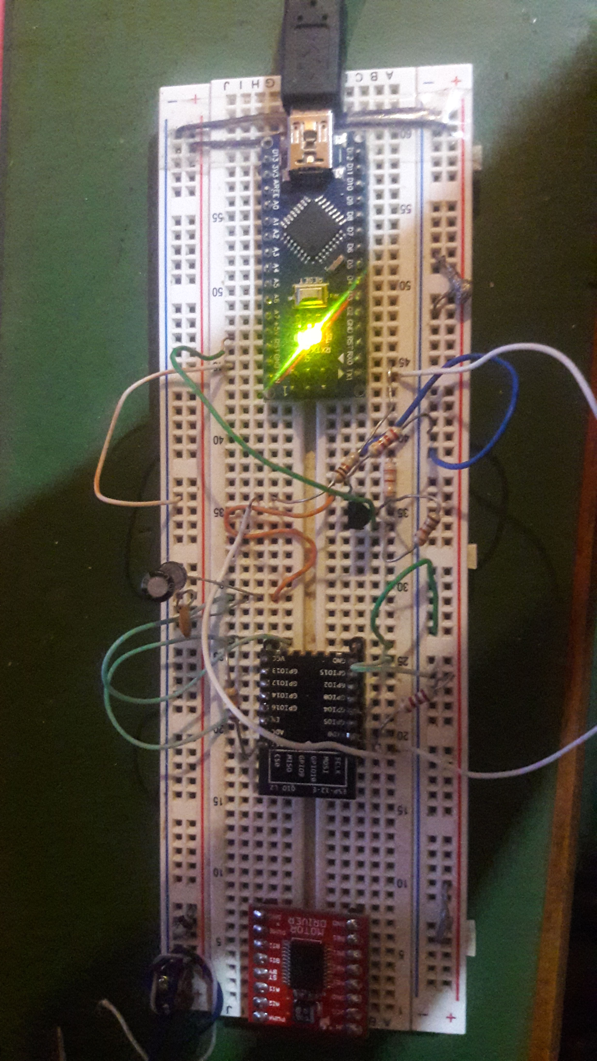
registros/IMG-20180203-WA0002.jpeg
