Seba-san/Trabajo_Final_Controlados/registros/IMG-20180203-WA0004.jpeg

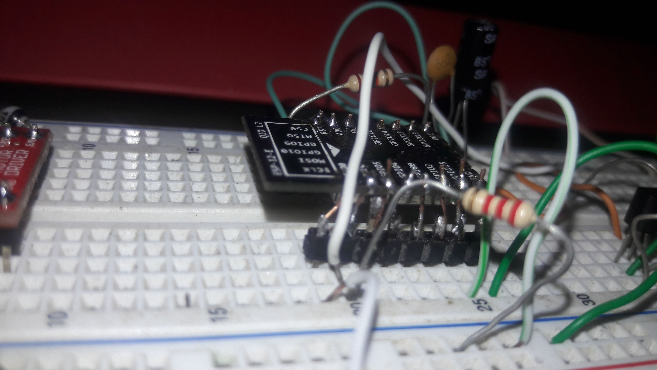
registros/IMG-20180203-WA0004.jpeg
