Seba-san/Trabajo_Final_Controlados/registros/IMG-20180205-WA0015.jpeg

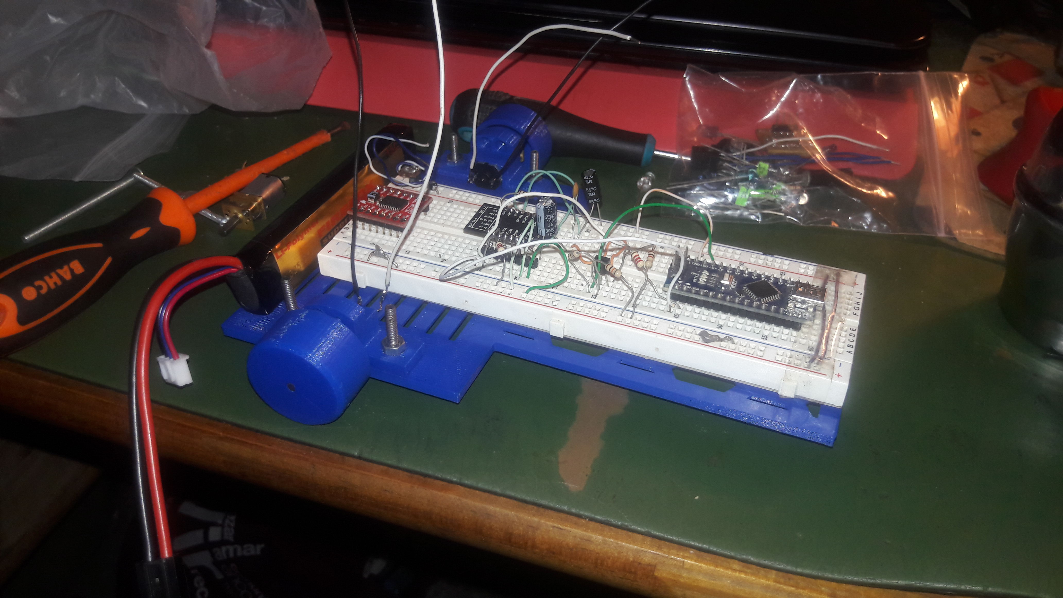
registros/IMG-20180205-WA0015.jpeg
