Seba-san/Trabajo_Final_Controlados/tmp/esp8266.png

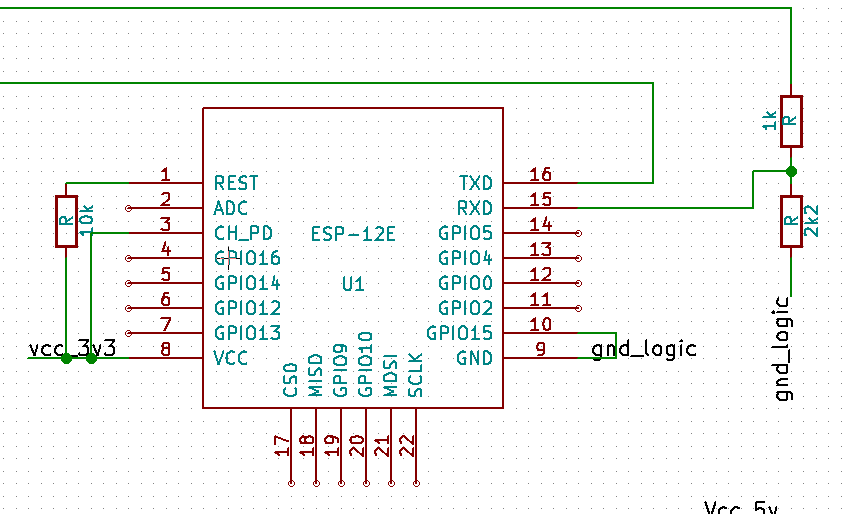
tmp/esp8266.png
