Seba-san/Trabajo_Final_Controlados/modelos_3d/Ultima_version/Proyecto BORA/Assem6.SLDASM

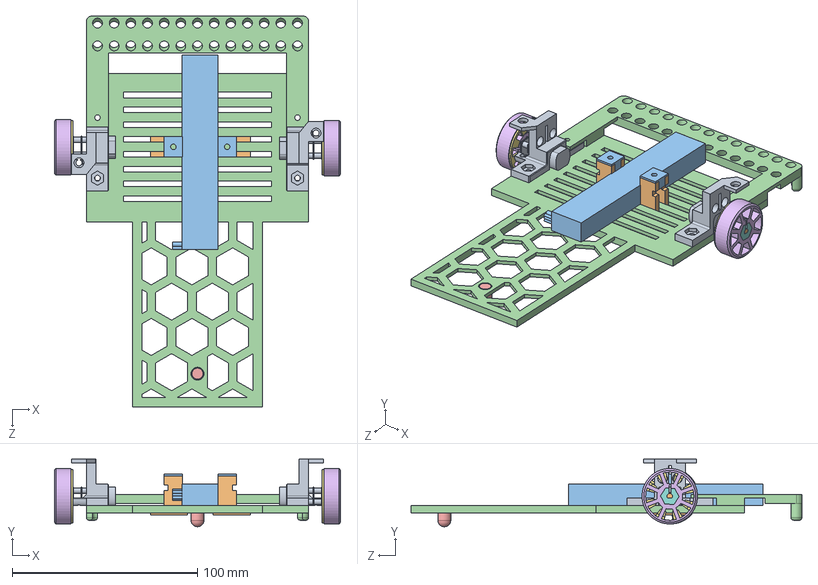
[picture p243: CAD file, 2018-07-02]
modelos_3d/Ultima_version/Proyecto BORA/Assem6.SLDASM
154.7 x 36.5 x 211.2 mm
Cuerpo x 2
Eje x 2
Bateria
BaseV2
Pata
RuedaV4 x 2
EncoderV2 x 2
ComplementoEje x 2
OmegaV8 x 2
SoporteBateria x 2
TapaSoporteBateria x 2
SensorLinealV2
