Seba-san/Trabajo_Final_Controlados/modelos_3d/Ultima_version/Proyecto BORA/Piezas/Motor/Motor.SLDASM

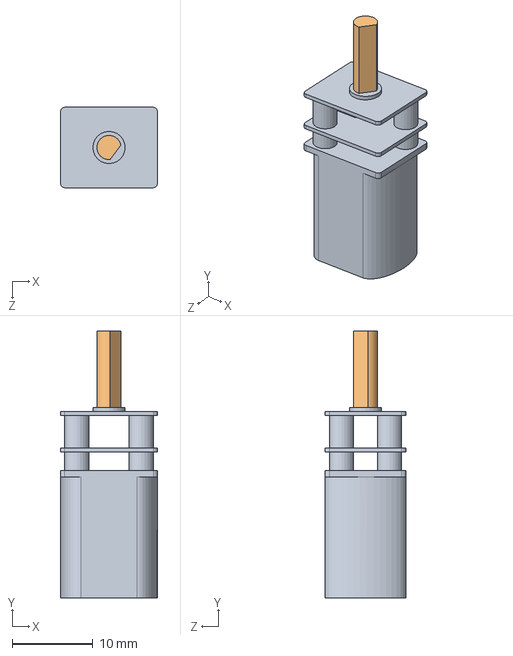
[picture p244: CAD file, 2018-07-02]
modelos_3d/Ultima_version/Proyecto BORA/Piezas/Motor/Motor.SLDASM
12.0 x 33.2 x 10.0 mm
Cuerpo
Eje
