Seba-san/Trabajo_Final_Controlados/modelos_3d/Ultima_version/Proyecto BORA/Piezas/MotorEncoder.SLDASM

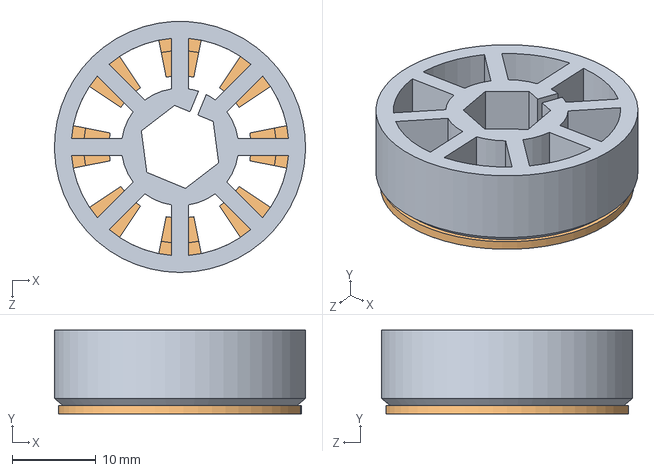
[picture p246: CAD file, 2018-07-02]
modelos_3d/Ultima_version/Proyecto BORA/Piezas/MotorEncoder.SLDASM
30.0 x 10.0 x 30.0 mm
RuedaV4
EncoderV2
