Seba-san/Trabajo_Final_Controlados/modelos_3d/Ultima_version/Proyecto BORA/Assem4.SLDASM

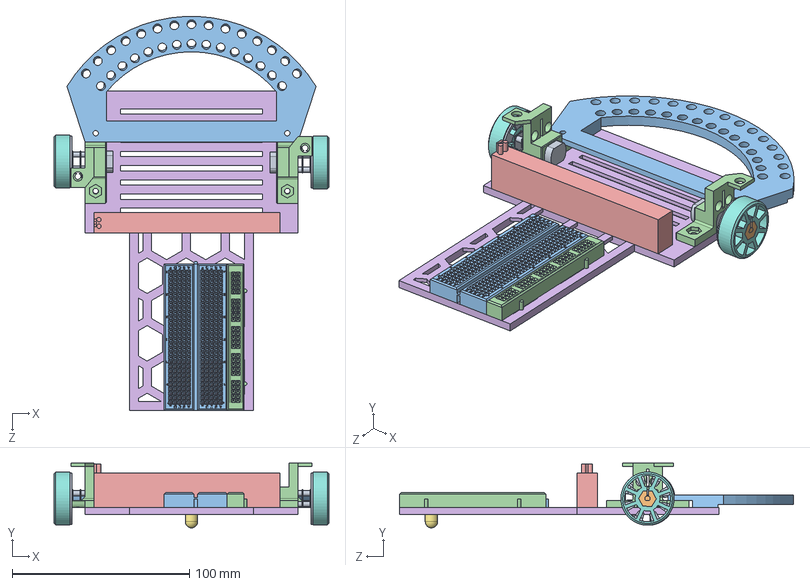
[picture p247: CAD file, 2018-07-02]
modelos_3d/Ultima_version/Proyecto BORA/Assem4.SLDASM
154.7 x 36.5 x 222.0 mm
Cuerpo x 2
Eje x 2
Bateria
BaseV2
Pata
RuedaV4 x 2
EncoderV2 x 2
ComplementoEje x 2
SensorLineaArco
OmegaV8 x 2
