Seba-san/Trabajo_Final_Controlados/modelos_3d/Ultima_version/Proyecto BORA/Piezas/breadboard-small-1.snapshot.2/breadboard_350_pos_asm.SLDASM

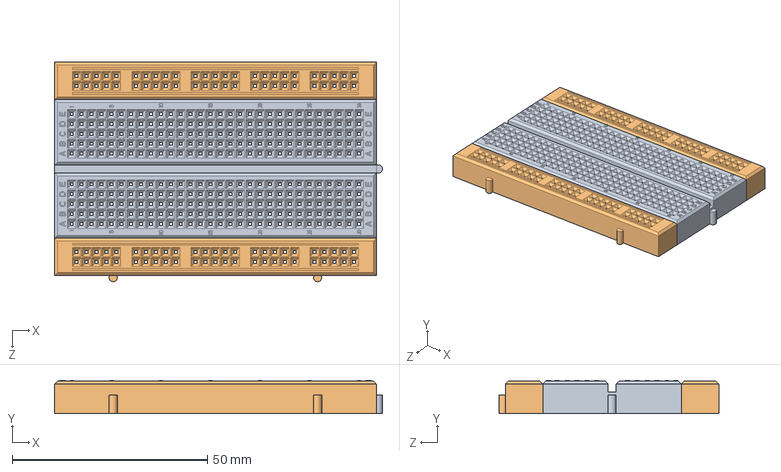
[picture p248: CAD file, 2018-07-02]
modelos_3d/Ultima_version/Proyecto BORA/Piezas/breadboard-small-1.snapshot.2/breadboard_350_pos_asm.SLDASM
84.1 x 8.50 x 56.3 mm
BREADBOARD_350_POS_CENTER
BREADBOARD_350_POS_SIDE x 2
