Seba-san/Trabajo_Final_Controlados/modelos_3d/Ultima_version/Proyecto BORA/Piezas/MotorV2/DC_GE_RED_Motor.SLDASM

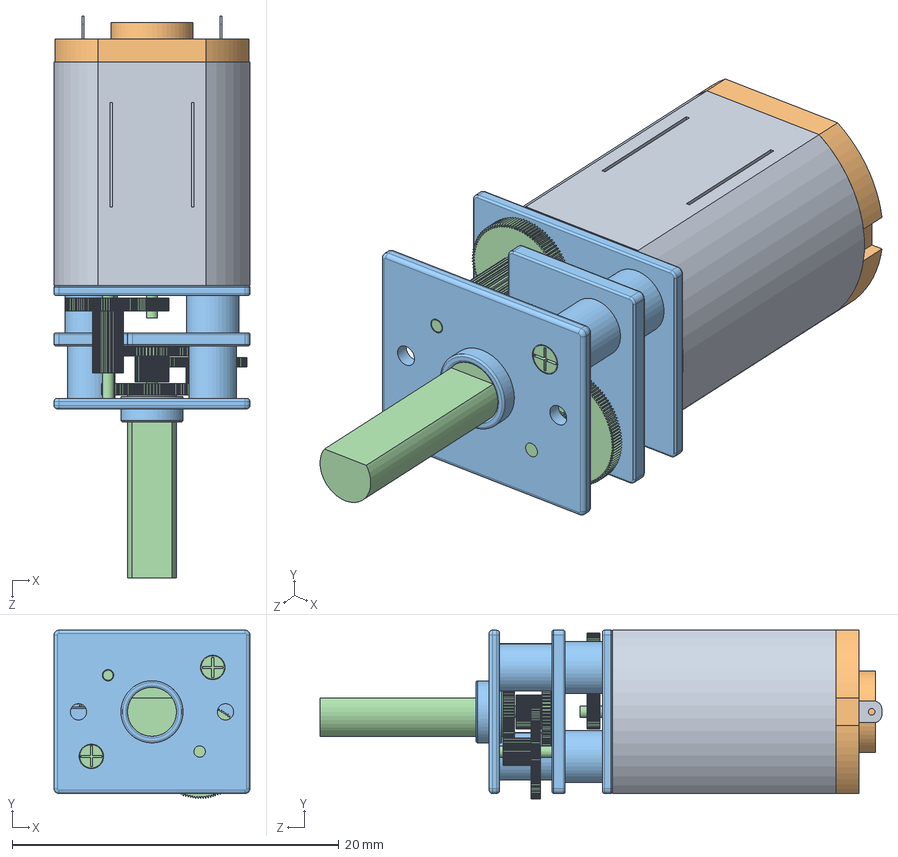
[picture p249: CAD file, 2018-07-02]
modelos_3d/Ultima_version/Proyecto BORA/Piezas/MotorV2/DC_GE_RED_Motor.SLDASM
12.0 x 10.3 x 34.4 mm
DC_GE_RED_Motor_01
DC_GE_RED_Motor_02
DC_GE_RED_Motor_03
DC_GE_RED_Motor_04
