Seba-san/Trabajo_Final_Controlados/modelos_3d/Ultima_version/Proyecto BORA/Assem1.SLDASM

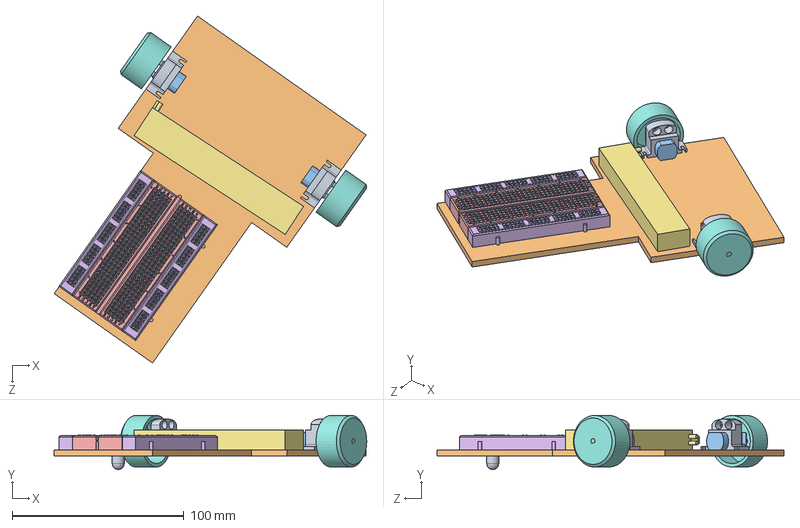
[picture p250: CAD file, 2018-07-02]
modelos_3d/Ultima_version/Proyecto BORA/Assem1.SLDASM
181.8 x 31.5 x 201.8 mm
Omega x 2
Base
Cuerpo x 2
Eje x 2
BREADBOARD_350_POS_CENTER
BREADBOARD_350_POS_SIDE x 2
Bateria
RuedaV3 x 2
Pata
