Seba-san/Trabajo_Final_Controlados/modelos_3d/Ultima_version/Proyecto BORA/Assem2.SLDASM

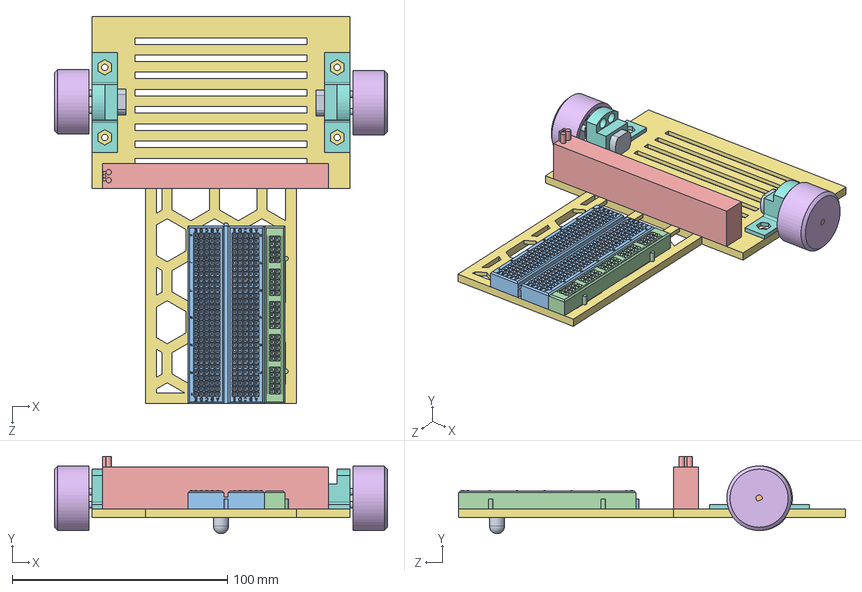
[picture p252: CAD file, 2018-04-25]
modelos_3d/Ultima_version/Proyecto BORA/Assem2.SLDASM
154.7 x 36.0 x 180.0 mm
Cuerpo x 2
Eje x 2
Bateria
RuedaV3 x 2
BaseV2
OmegaV3 x 2
Pata
