Seba-san/Trabajo_Final_Controlados/modelos_3d/BaseV2.SLDPRT

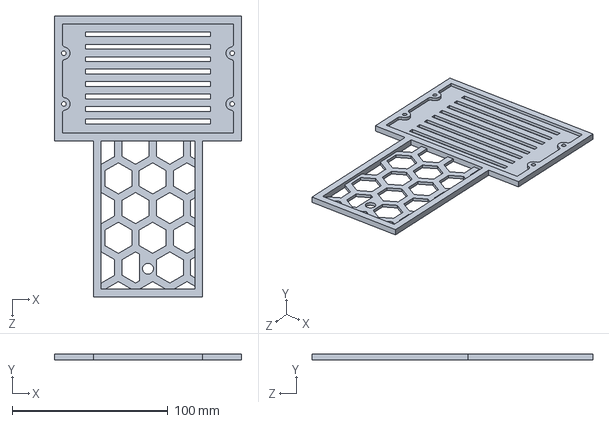
[picture p253: CAD file, 2018-04-25]
modelos_3d/BaseV2.SLDPRT
120.0 x 4.00 x 180.0 mm
