Seba-san/Trabajo_Final_Controlados/modelos_3d/Ultima_version/Proyecto BORA/Piezas/MotorV2/DC_GE_RED_Motor_01.SLDPRT

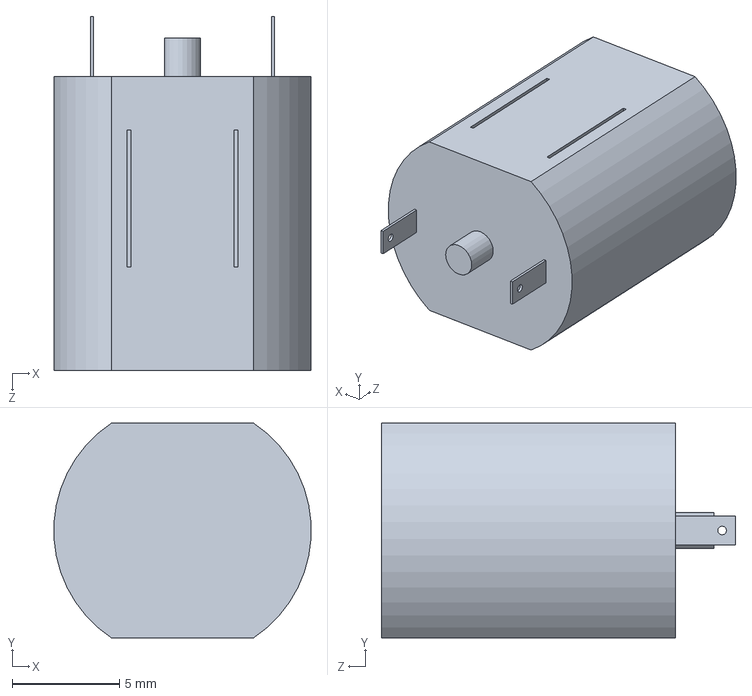
[picture p254: CAD file, 2018-07-02]
modelos_3d/Ultima_version/Proyecto BORA/Piezas/MotorV2/DC_GE_RED_Motor_01.SLDPRT
12.0 x 10.0 x 16.5 mm
