Seba-san/Trabajo_Final_Controlados/modelos_3d/Ultima_version/Proyecto BORA/Piezas/STL/EncoderV4.STL

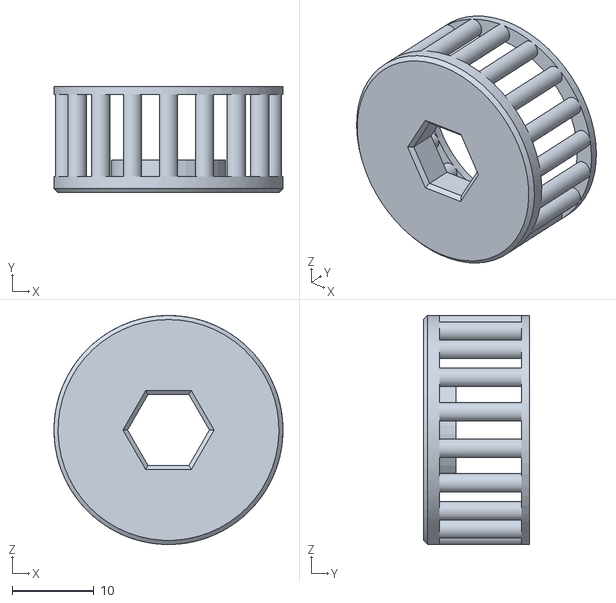
[picture p256: CAD file, 2018-07-02]
modelos_3d/Ultima_version/Proyecto BORA/Piezas/STL/EncoderV4.STL
28.0 x 13.0 x 28.0
