Seba-san/Trabajo_Final_Controlados/modelos_3d/Ultima_version/Proyecto BORA/Piezas/Motor/Eje.SLDPRT

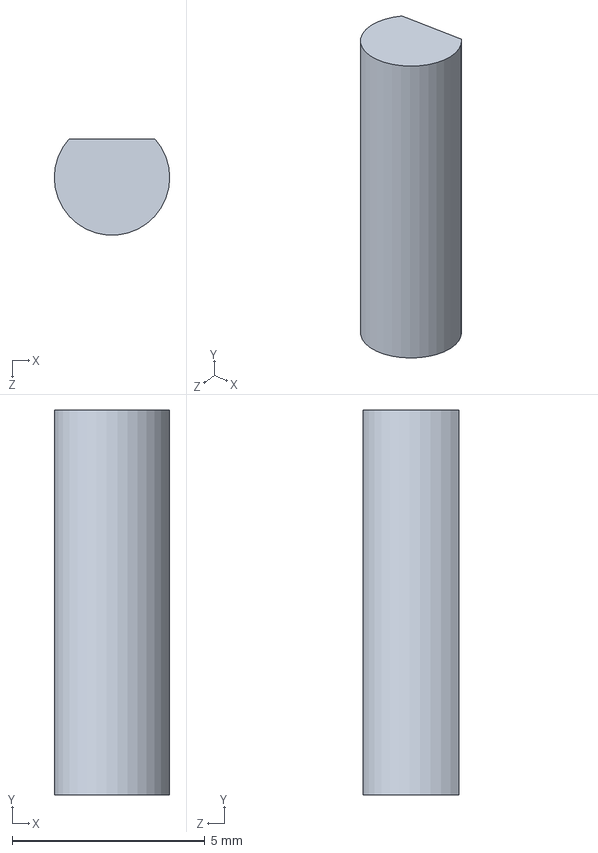
[picture p257: CAD file, 2018-07-02]
modelos_3d/Ultima_version/Proyecto BORA/Piezas/Motor/Eje.SLDPRT
3.00 x 10.0 x 2.49 mm
