Seba-san/Trabajo_Final_Controlados/modelos_3d/Ultima_version/Proyecto BORA/Piezas/MotorV2/DC_GE_RED_Motor_03.SLDPRT

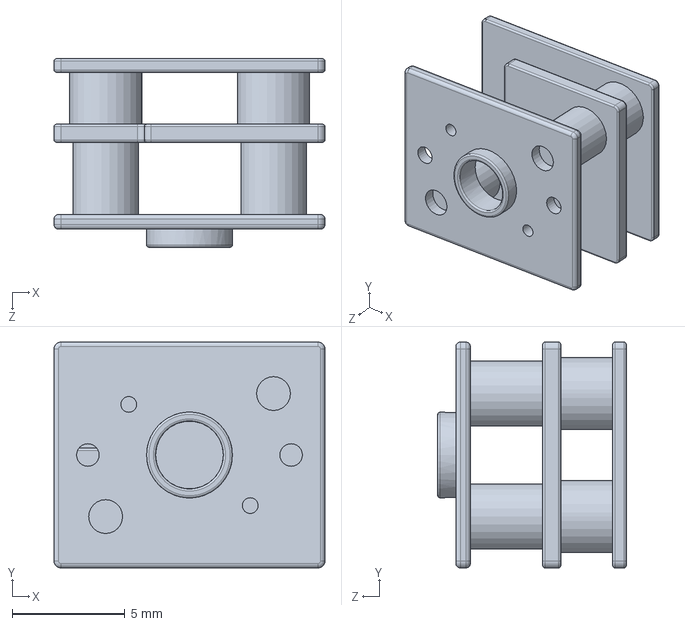
[picture p258: CAD file, 2018-07-02]
modelos_3d/Ultima_version/Proyecto BORA/Piezas/MotorV2/DC_GE_RED_Motor_03.SLDPRT
12.0 x 10.0 x 8.35 mm
