Seba-san/Trabajo_Final_Controlados/modelos_3d/Ultima_version/Proyecto BORA/Piezas/Bateria.SLDPRT

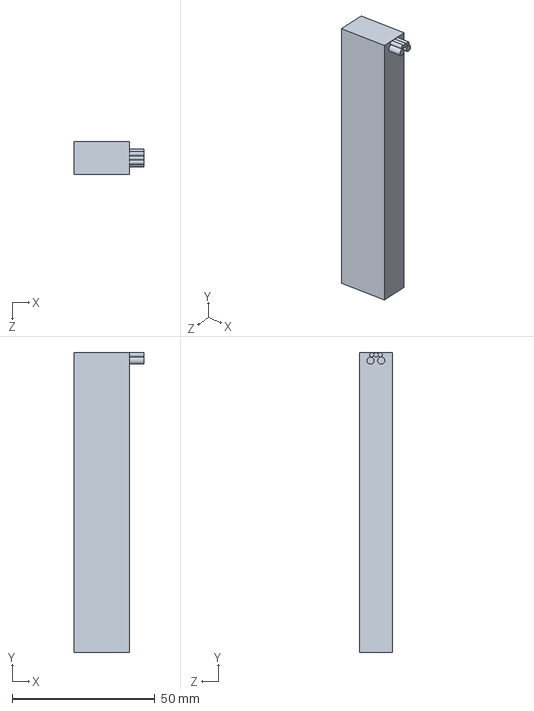
[picture p259: CAD file, 2018-07-02]
modelos_3d/Ultima_version/Proyecto BORA/Piezas/Bateria.SLDPRT
24.5 x 105.0 x 11.5 mm
