Seba-san/Trabajo_Final_Controlados/modelos_3d/Ultima_version/Proyecto BORA/Piezas/Motor/Cuerpo.SLDPRT

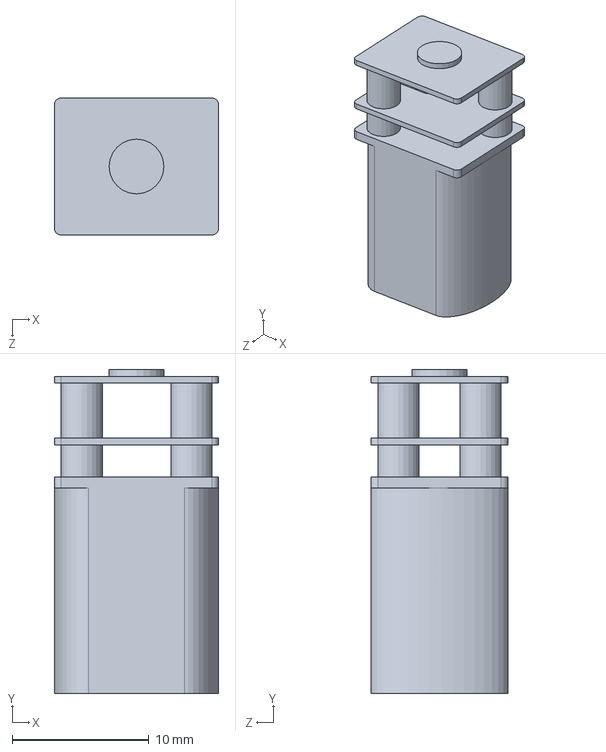
[picture p260: CAD file, 2018-07-02]
modelos_3d/Ultima_version/Proyecto BORA/Piezas/Motor/Cuerpo.SLDPRT
12.0 x 23.6 x 10.0 mm
