Seba-san/Trabajo_Final_Controlados/modelos_3d/Ultima_version/Proyecto BORA/Piezas/MotorV2/DC_GE_RED_Motor_02.SLDPRT

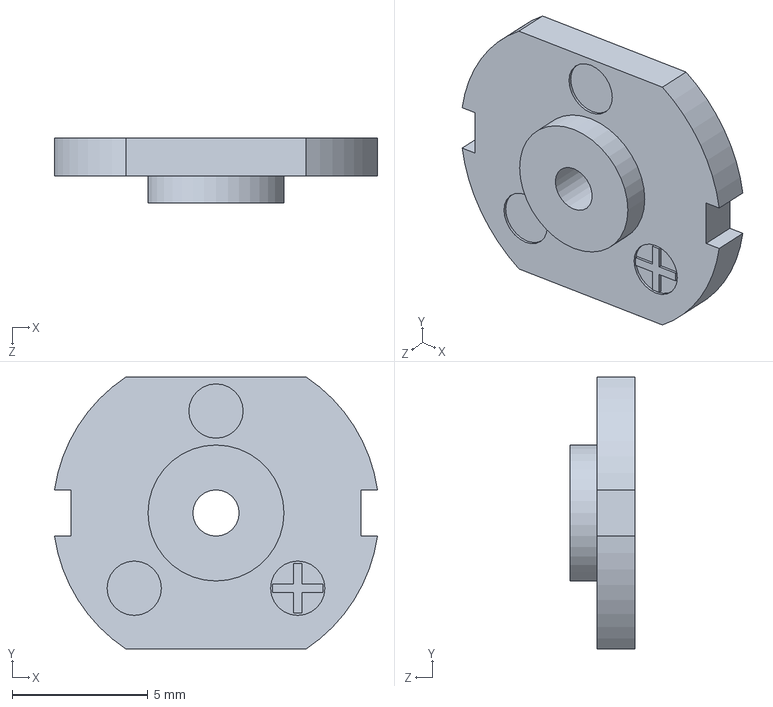
[picture p261: CAD file, 2018-07-02]
modelos_3d/Ultima_version/Proyecto BORA/Piezas/MotorV2/DC_GE_RED_Motor_02.SLDPRT
11.9 x 10.0 x 2.40 mm
