Seba-san/Trabajo_Final_Controlados/modelos_3d/Ultima_version/Proyecto BORA/Piezas/MotorV2/DC_GE_RED_Motor_04.SLDPRT

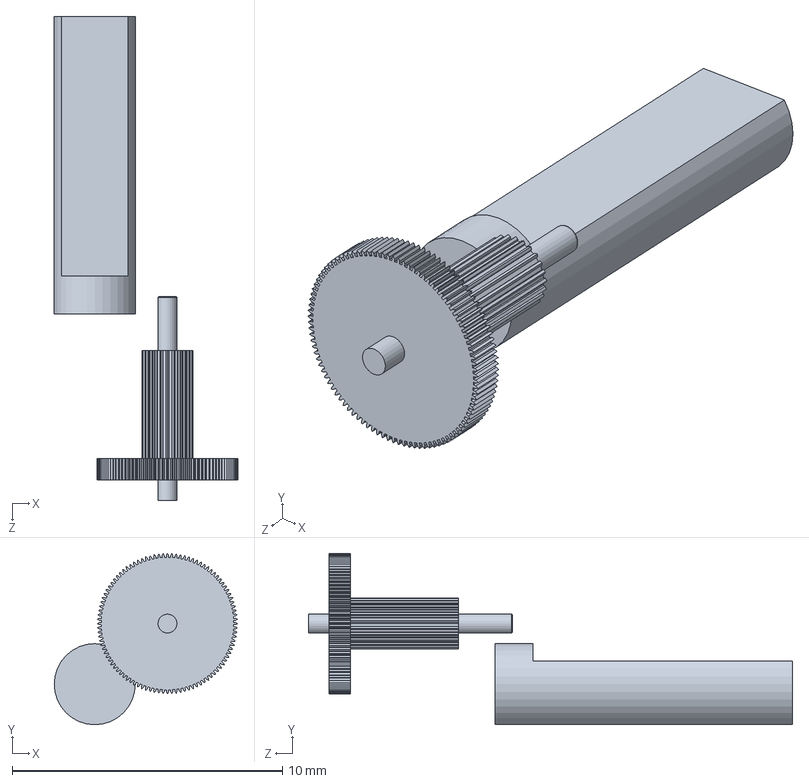
[picture p262: CAD file, 2018-07-02]
modelos_3d/Ultima_version/Proyecto BORA/Piezas/MotorV2/DC_GE_RED_Motor_04.SLDPRT
6.79 x 6.34 x 17.9 mm
