Seba-san/Trabajo_Final_Controlados/modelos_3d/Ultima_version/Proyecto BORA/Piezas/TapaSoporteBateria.SLDPRT

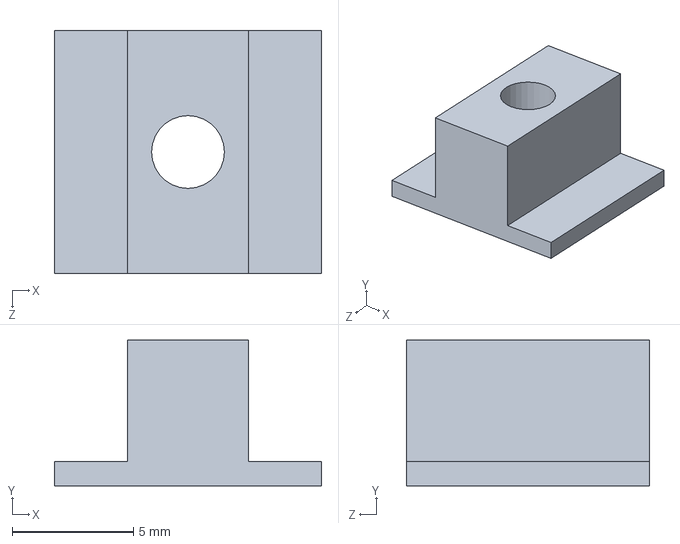
[picture p263: CAD file, 2018-07-02]
modelos_3d/Ultima_version/Proyecto BORA/Piezas/TapaSoporteBateria.SLDPRT
11.0 x 6.00 x 10.0 mm
