Seba-san/Trabajo_Final_Controlados/modelos_3d/Ultima_version/Proyecto BORA/Piezas/MotorV2/DC_GE_RED_Motor - DC_GE_RED_Motor_04-1.STL

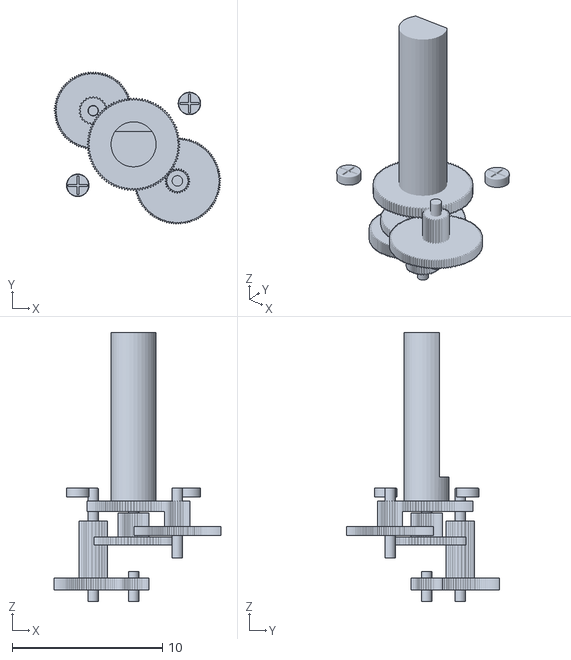
[picture p264: CAD file, 2018-04-25]
modelos_3d/Ultima_version/Proyecto BORA/Piezas/MotorV2/DC_GE_RED_Motor - DC_GE_RED_Motor_04-1.STL
11.1 x 10.2 x 17.9
