Seba-san/Trabajo_Final_Controlados/modelos_3d/Ultima_version/Proyecto BORA/Piezas/SoporteBateria.SLDPRT

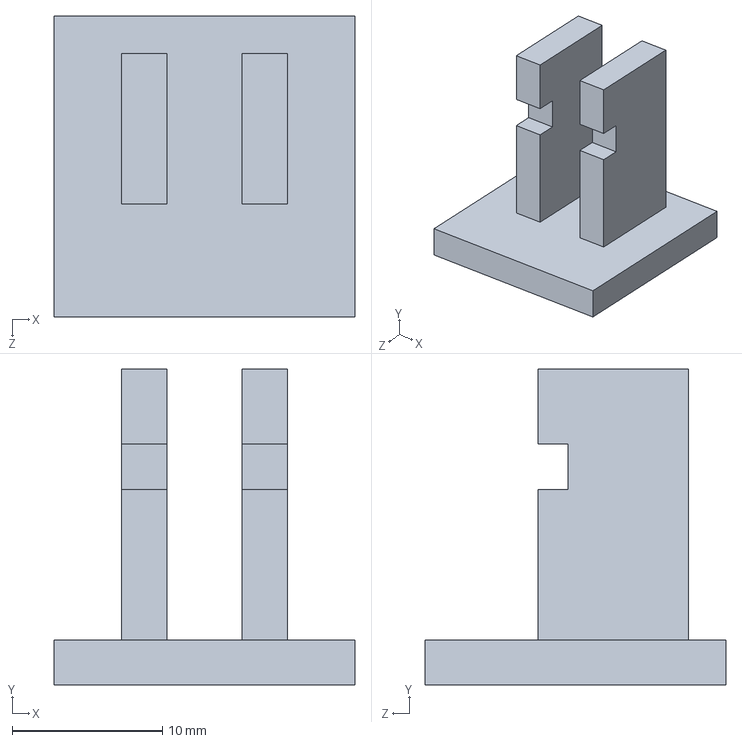
[picture p265: CAD file, 2018-07-02]
modelos_3d/Ultima_version/Proyecto BORA/Piezas/SoporteBateria.SLDPRT
20.0 x 21.0 x 20.0 mm
