Seba-san/Trabajo_Final_Controlados/modelos_3d/Ultima_version/Proyecto BORA/Piezas/Base.SLDPRT

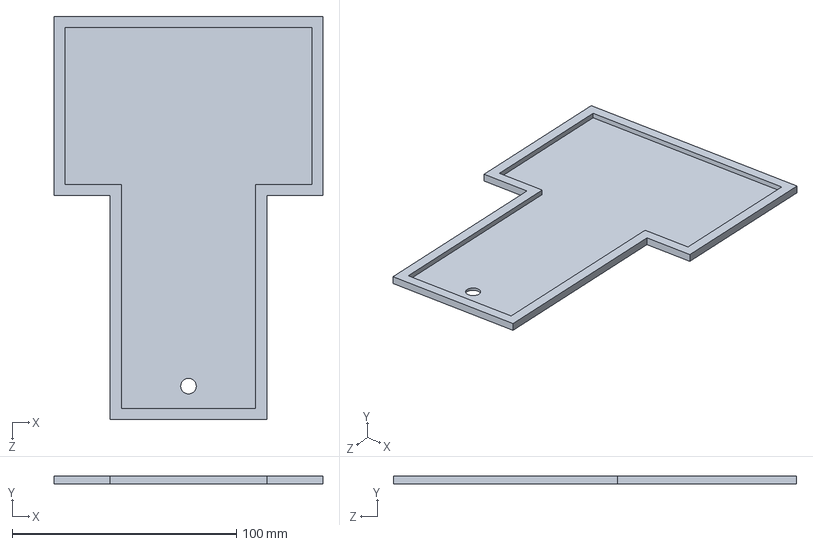
[picture p266: CAD file, 2018-07-02]
modelos_3d/Ultima_version/Proyecto BORA/Piezas/Base.SLDPRT
120.0 x 3.60 x 180.0 mm
