Seba-san/Trabajo_Final_Controlados/modelos_3d/Ultima_version/Proyecto BORA/Piezas/RuedaV6.SLDPRT

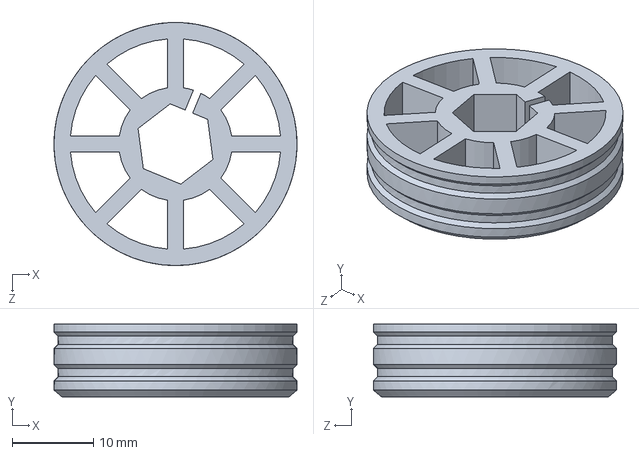
[picture p267: CAD file, 2018-07-02]
modelos_3d/Ultima_version/Proyecto BORA/Piezas/RuedaV6.SLDPRT
30.0 x 9.00 x 30.0 mm
