Seba-san/Trabajo_Final_Controlados/modelos_3d/Ultima_version/Proyecto BORA/Piezas/SoporteSensorLineal.SLDPRT

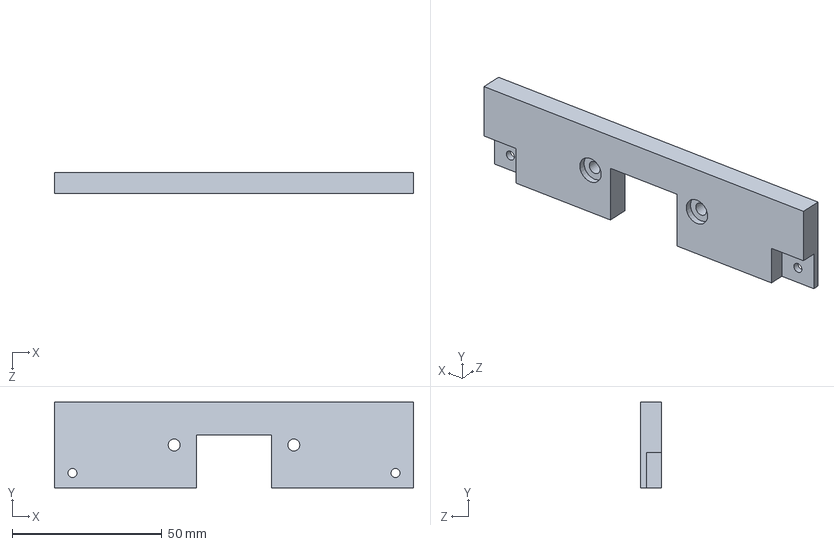
[picture p268: CAD file, 2018-07-02]
modelos_3d/Ultima_version/Proyecto BORA/Piezas/SoporteSensorLineal.SLDPRT
120.0 x 28.7 x 7.00 mm
