Seba-san/Trabajo_Final_Controlados/modelos_3d/Ultima_version/Proyecto BORA/Piezas/ComplementoOmega.SLDPRT

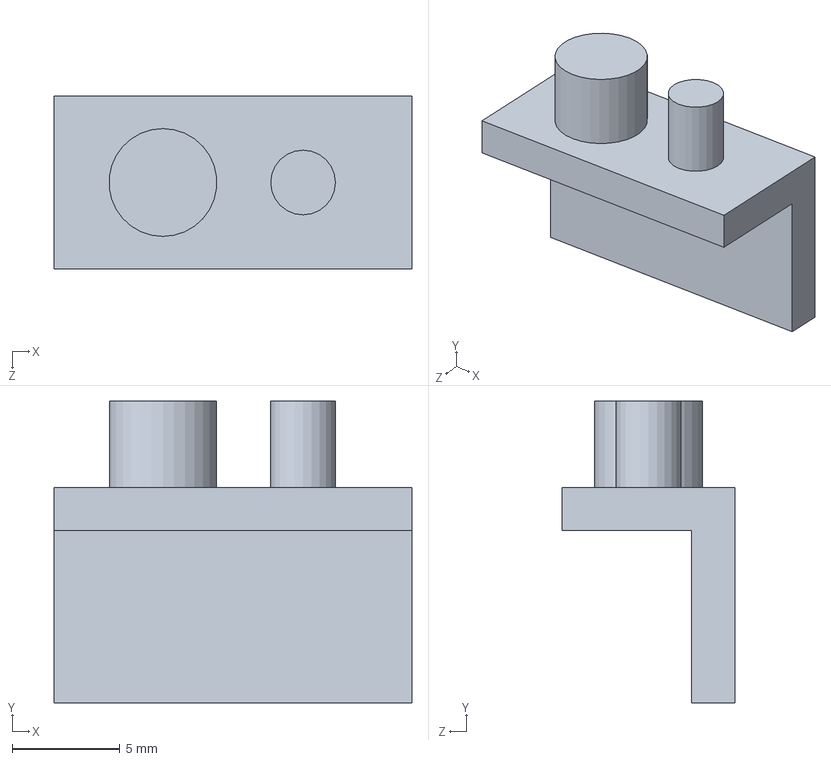
[picture p269: CAD file, 2018-07-02]
modelos_3d/Ultima_version/Proyecto BORA/Piezas/ComplementoOmega.SLDPRT
16.6 x 14.0 x 8.00 mm
