Seba-san/Trabajo_Final_Controlados/modelos_3d/Ultima_version/Proyecto BORA/Piezas/Encoder.SLDPRT

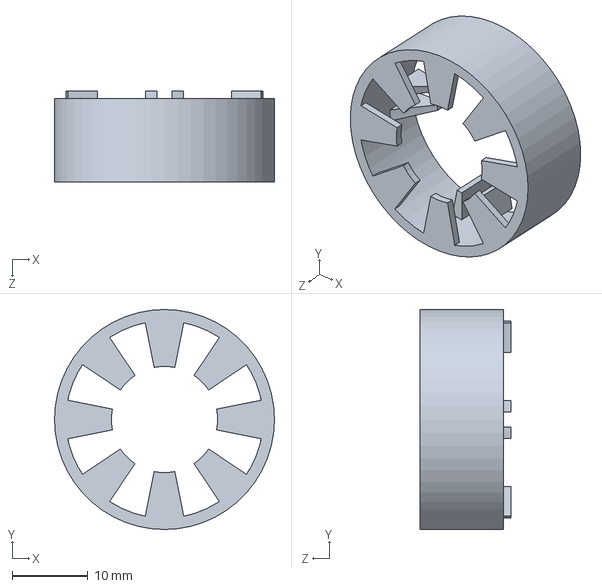
[picture p270: CAD file, 2018-07-02]
modelos_3d/Ultima_version/Proyecto BORA/Piezas/Encoder.SLDPRT
29.0 x 29.0 x 12.0 mm
