Seba-san/Trabajo_Final_Controlados/modelos_3d/Ultima_version/Proyecto BORA/Piezas/SensorLineaArco.SLDPRT

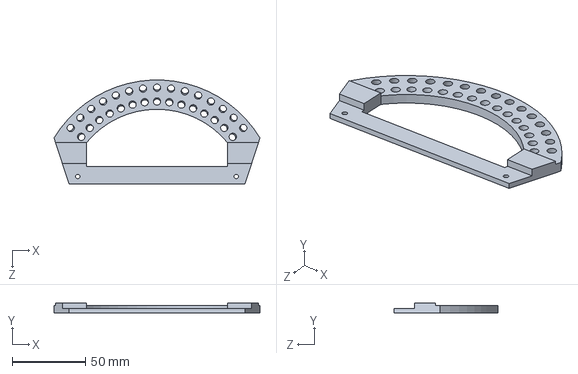
[picture p271: CAD file, 2018-07-02]
modelos_3d/Ultima_version/Proyecto BORA/Piezas/SensorLineaArco.SLDPRT
140.4 x 7.00 x 70.7 mm
