Seba-san/Trabajo_Final_Controlados/modelos_3d/Ultima_version/Proyecto BORA/Piezas/SensorLinealV2.SLDPRT

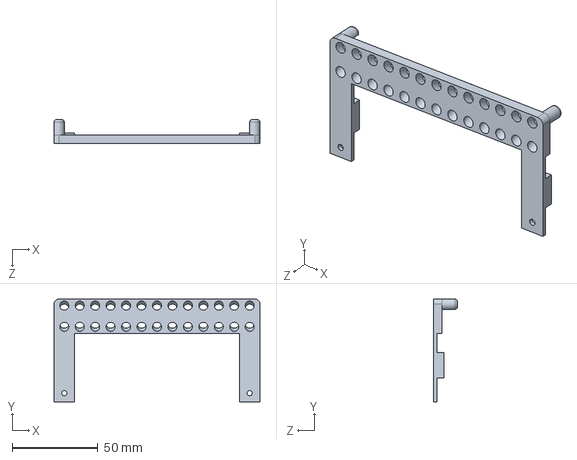
[picture p272: CAD file, 2018-07-02]
modelos_3d/Ultima_version/Proyecto BORA/Piezas/SensorLinealV2.SLDPRT
120.0 x 60.0 x 14.0 mm
