Seba-san/Trabajo_Final_Controlados/modelos_3d/Ultima_version/Proyecto BORA/Piezas/OmegaV8.SLDPRT

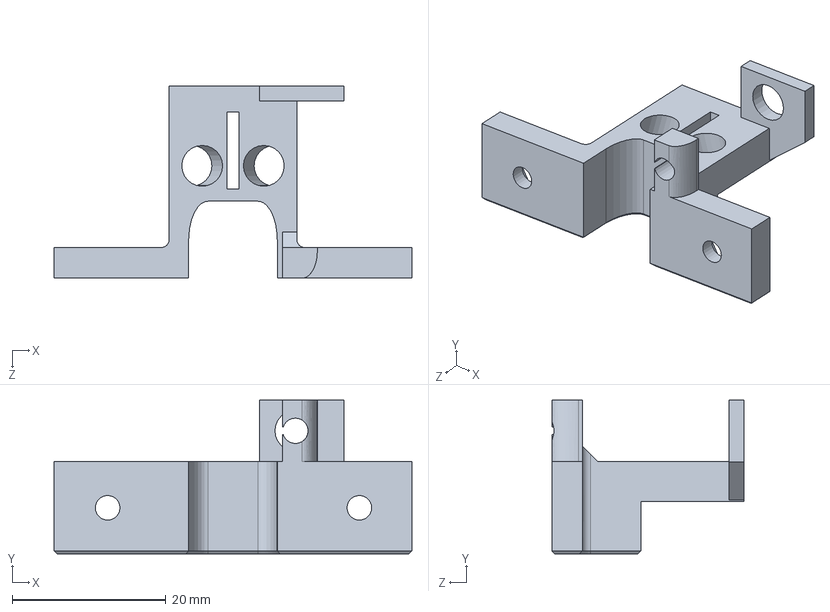
[picture p273: CAD file, 2018-07-02]
modelos_3d/Ultima_version/Proyecto BORA/Piezas/OmegaV8.SLDPRT
46.5 x 20.0 x 25.0 mm
