Seba-san/Trabajo_Final_Controlados/modelos_3d/Ultima_version/Proyecto BORA/Piezas/ComplementoEjeV2.SLDPRT

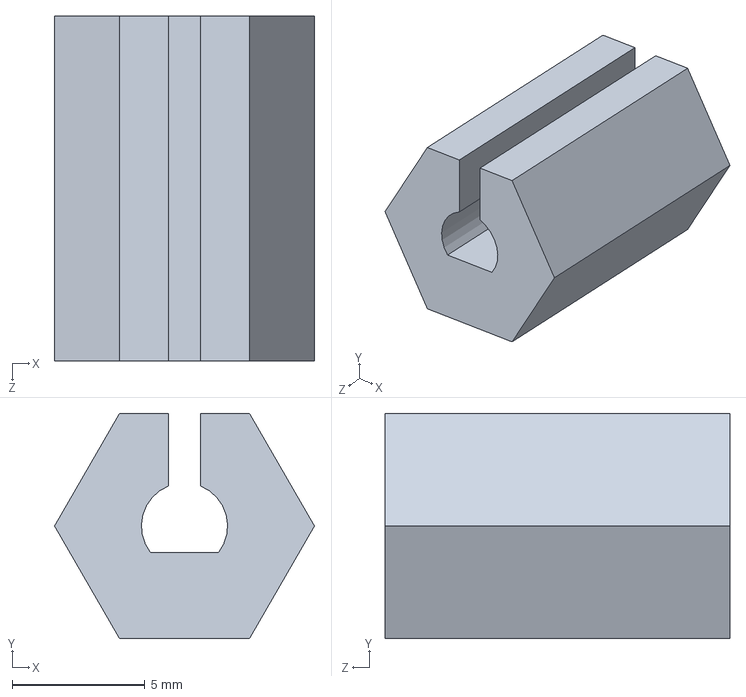
[picture p274: CAD file, 2018-07-02]
modelos_3d/Ultima_version/Proyecto BORA/Piezas/ComplementoEjeV2.SLDPRT
9.80 x 8.49 x 13.0 mm
