Seba-san/Trabajo_Final_Controlados/modelos_3d/Ultima_version/Proyecto BORA/Piezas/SensorLineal.SLDPRT

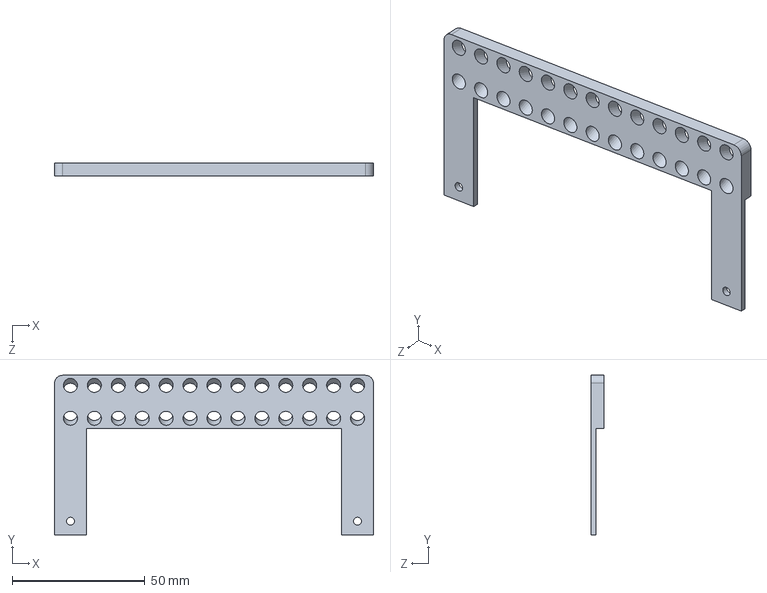
[picture p275: CAD file, 2018-07-02]
modelos_3d/Ultima_version/Proyecto BORA/Piezas/SensorLineal.SLDPRT
120.0 x 60.0 x 5.00 mm
