Seba-san/Trabajo_Final_Controlados/modelos_3d/Ultima_version/Proyecto BORA/Piezas/Rueda.SLDPRT

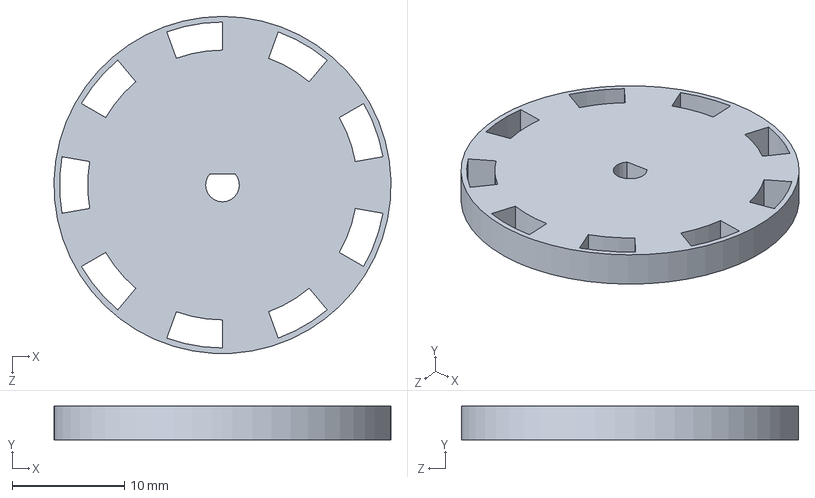
[picture p276: CAD file, 2018-07-02]
modelos_3d/Ultima_version/Proyecto BORA/Piezas/Rueda.SLDPRT
30.0 x 3.00 x 30.0 mm
