Seba-san/Trabajo_Final_Controlados/modelos_3d/Ultima_version/Proyecto BORA/Piezas/PataV2.SLDPRT

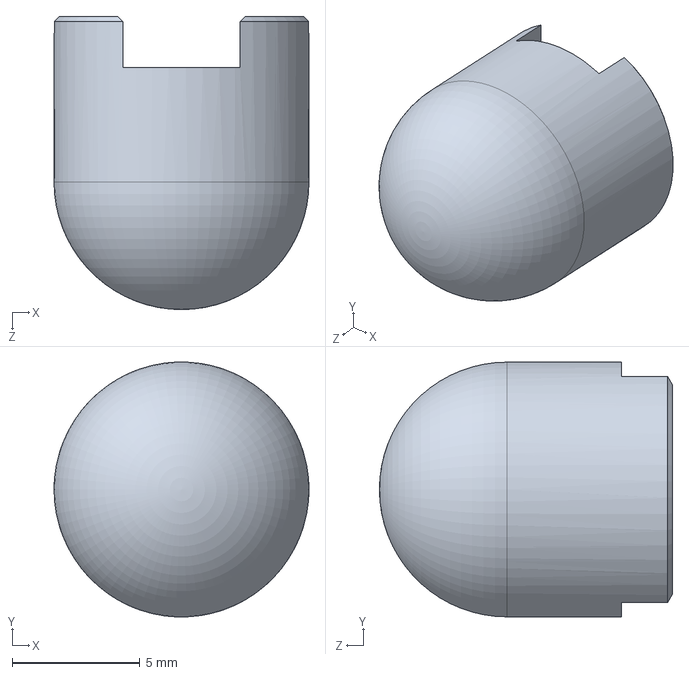
[picture p277: CAD file, 2018-07-02]
modelos_3d/Ultima_version/Proyecto BORA/Piezas/PataV2.SLDPRT
10.0 x 9.99 x 11.5 mm
