Seba-san/Trabajo_Final_Controlados/modelos_3d/Ultima_version/Proyecto BORA/Piezas/ComplementoEje.SLDPRT

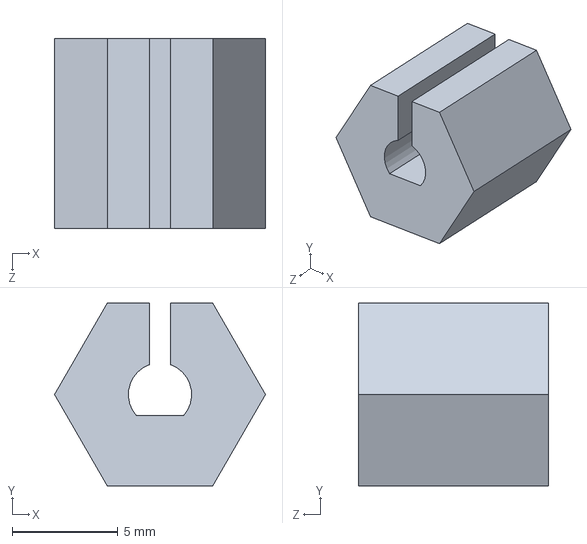
[picture p278: CAD file, 2018-07-02]
modelos_3d/Ultima_version/Proyecto BORA/Piezas/ComplementoEje.SLDPRT
10.0 x 8.66 x 9.00 mm
