Seba-san/Trabajo_Final_Controlados/modelos_3d/Ultima_version/Proyecto BORA/Piezas/Omega.SLDPRT

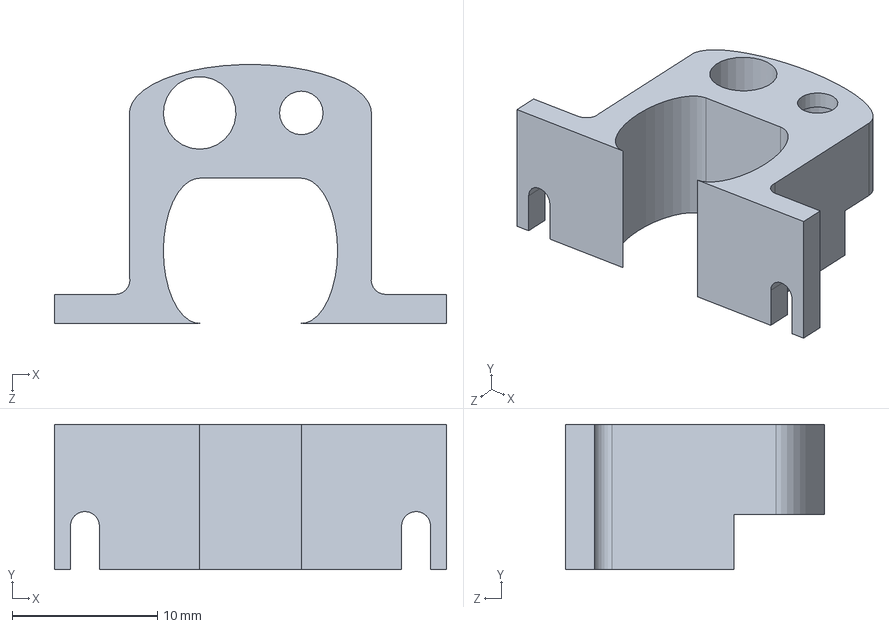
[picture p279: CAD file, 2018-07-02]
modelos_3d/Ultima_version/Proyecto BORA/Piezas/Omega.SLDPRT
27.0 x 10.0 x 17.8 mm
