Seba-san/Trabajo_Final_Controlados/(list of files, cad)

Other CAD files:
modelos_3d/Ultima_version/Proyecto BORA/Piezas/breadboard-small-1.snapshot.2/BREADBOARD_350_POS_CENTER.sldprt
modelos_3d/Ultima_version/Proyecto BORA/Piezas/breadboard-small-1.snapshot.2/BREADBOARD_350_POS_SIDE.sldprt
modelos_3d/Ultima_version/Proyecto BORA/Piezas/Discos.DWG
modelos_3d/Ultima_version/Proyecto BORA/Piezas/MotorV2/DC_GE_RED_Motor - DC_GE_RED_Motor_03-1.STL
modelos_3d/Ultima_version/Proyecto BORA/Piezas/MotorV2/DC_GE_RED_Motor - DC_GE_RED_Motor_02-1.STL
modelos_3d/Ultima_version/Proyecto BORA/Piezas/MotorV2/DC_GE_RED_Motor - DC_GE_RED_Motor_01-1.STL
modelos_3d/Ultima_version/Proyecto BORA/Piezas/EncoderV3.SLDPRT
modelos_3d/Ultima_version/Proyecto BORA/Piezas/BaseV2.SLDPRT
modelos_3d/Ultima_version/Proyecto BORA/Piezas/Discos.SLDDRW
modelos_3d/Ultima_version/Proyecto BORA/Piezas/EncoderV2.SLDPRT
modelos_3d/Ultima_version/Proyecto BORA/Piezas/OmegaV2.SLDPRT
modelos_3d/Ultima_version/Proyecto BORA/Piezas/OmegaV3.SLDPRT
modelos_3d/Ultima_version/Proyecto BORA/Piezas/OmegaV4.SLDPRT
modelos_3d/Ultima_version/Proyecto BORA/Piezas/OmegaV5.SLDPRT
modelos_3d/Ultima_version/Proyecto BORA/Piezas/OmegaV6.SLDPRT
modelos_3d/Ultima_version/Proyecto BORA/Piezas/OmegaV7.SLDPRT
modelos_3d/Ultima_version/Proyecto BORA/Piezas/Pata.SLDPRT
modelos_3d/Ultima_version/Proyecto BORA/Piezas/RuedaV2.SLDPRT
modelos_3d/Ultima_version/Proyecto BORA/Piezas/RuedaV3.SLDPRT
modelos_3d/Ultima_version/Proyecto BORA/Piezas/RuedaV4.SLDPRT
modelos_3d/Ultima_version/Proyecto BORA/Piezas/RuedaV5.SLDPRT
modelos_3d/Ultima_version/Proyecto BORA/Piezas/STL/Base.STL
modelos_3d/Ultima_version/Proyecto BORA/Piezas/STL/BaseV2.STL
modelos_3d/Ultima_version/Proyecto BORA/Piezas/STL/ComplementoEje.STL
modelos_3d/Ultima_version/Proyecto BORA/Piezas/STL/ComplementoEjeV2.STL
modelos_3d/Ultima_version/Proyecto BORA/Piezas/STL/EncoderV2.STL
modelos_3d/Ultima_version/Proyecto BORA/Piezas/STL/EncoderV3.STL
modelos_3d/Ultima_version/Proyecto BORA/Piezas/STL/Omega.STL
modelos_3d/Ultima_version/Proyecto BORA/Piezas/STL/OmegaV3.STL
modelos_3d/Ultima_version/Proyecto BORA/Piezas/STL/OmegaV4.STL
modelos_3d/Ultima_version/Proyecto BORA/Piezas/STL/OmegaV7.STL
modelos_3d/Ultima_version/Proyecto BORA/Piezas/STL/OmegaV8.STL
modelos_3d/Ultima_version/Proyecto BORA/Piezas/STL/Pata.STL
modelos_3d/Ultima_version/Proyecto BORA/Piezas/STL/RuedaV3.STL
modelos_3d/Ultima_version/Proyecto BORA/Piezas/STL/RuedaV4.STL
modelos_3d/Ultima_version/Proyecto BORA/Piezas/STL/RuedaV5.STL
modelos_3d/Ultima_version/Proyecto BORA/Piezas/STL/RuedaV6.STL
modelos_3d/Ultima_version/Proyecto BORA/Piezas/STL/SensorLineaArco.STL
modelos_3d/Ultima_version/Proyecto BORA/Piezas/STL/SensorLineaArcoV2.STL
modelos_3d/Ultima_version/Proyecto BORA/Piezas/STL/SensorLineal.STL
modelos_3d/Ultima_version/Proyecto BORA/Piezas/STL/SensorLinealV2.STL
modelos_3d/Ultima_version/Proyecto BORA/Piezas/STL/SoporteBateria.STL
modelos_3d/Ultima_version/Proyecto BORA/Piezas/STL/TapaSoporteBateria.STL
