Seba-san/Trabajo_Final_Controlados/Mediciones/180423120930_calibrando_100hz.png

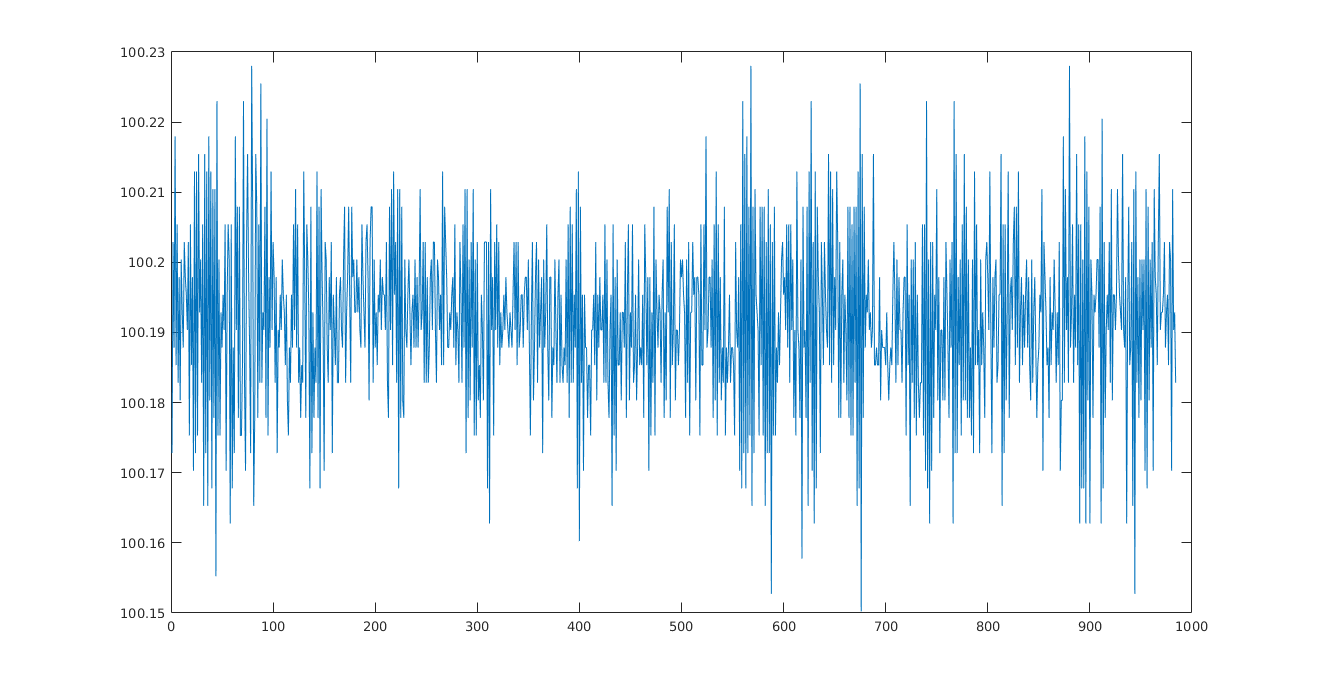
Mediciones/180423120930_calibrando_100hz.png
