Seba-san/Trabajo_Final_Controlados/pcb_mother/Prueba.png

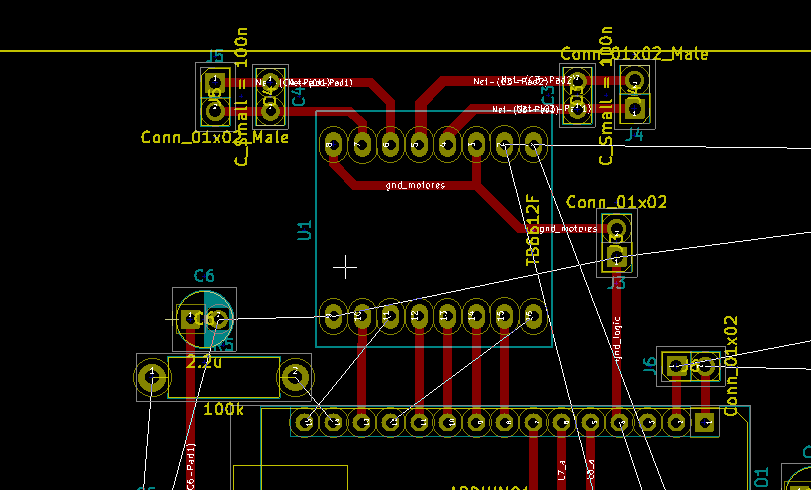
pcb_mother/Prueba.png
