Seba-san/Trabajo_Final_Controlados/Informe/Pre_informe/imagenes/prueba_linealidad-eps-converted-to.pdf

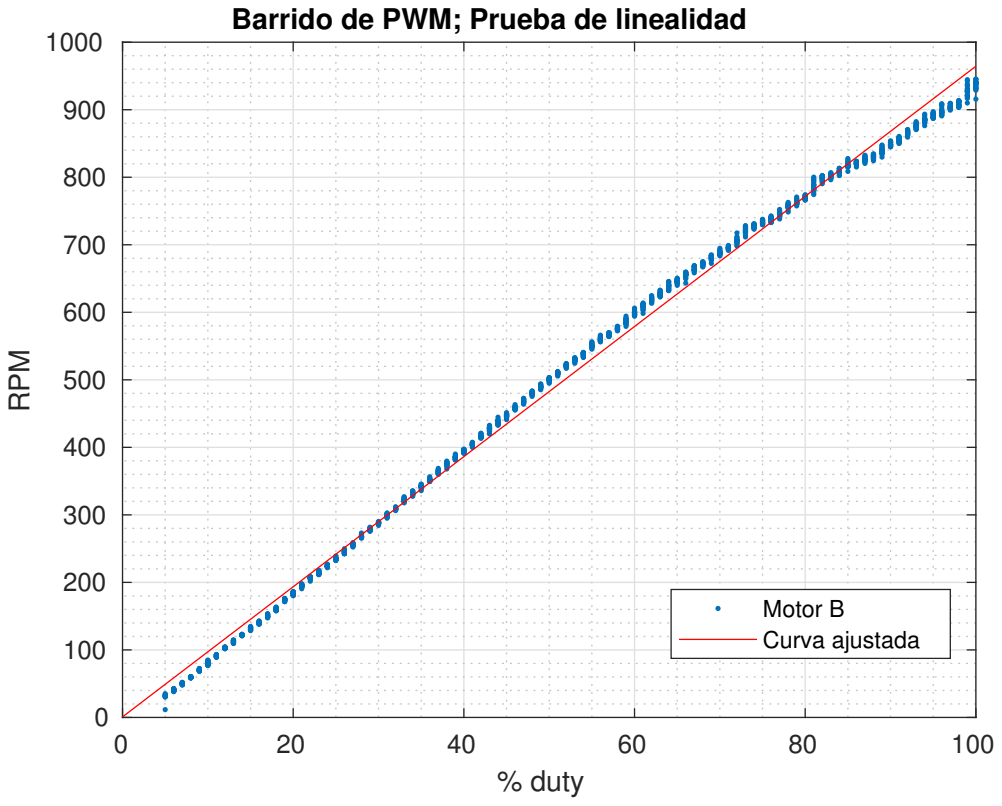
[picture p282: page 1]
% duty; RPM; Motor B Curva ajustada

Barrido de PWM; Prueba de linealidad
