Seba-san/Trabajo_Final_Controlados/Informe/Pre_informe/imagenes/resp_escalon_motores_2-eps-converted-to.pdf

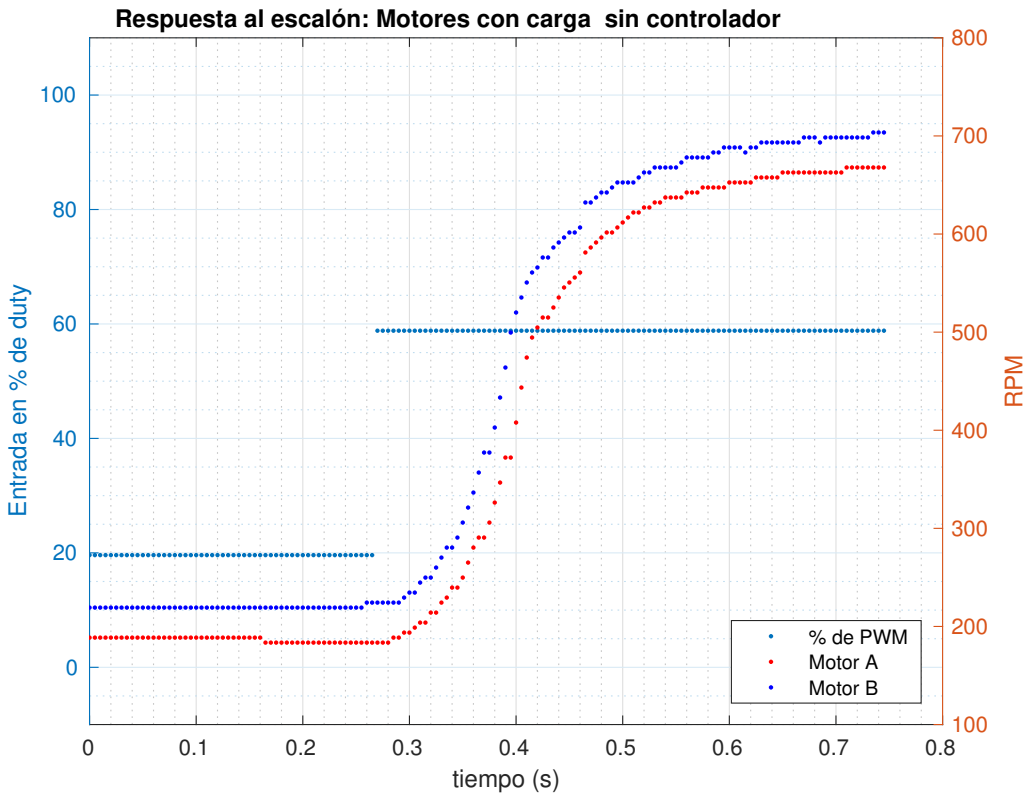
[picture p283: page 1]
tiempo (s); RPM

Respuesta al escalón: Motores con carga sin controlador

Entrada en % de duty

% de PWM
Motor A
Motor B
