Seba-san/Trabajo_Final_Controlados/Informe/Pre_informe/imagenes/resp_escalon_motores_controlados_2-eps-converted-to.pdf

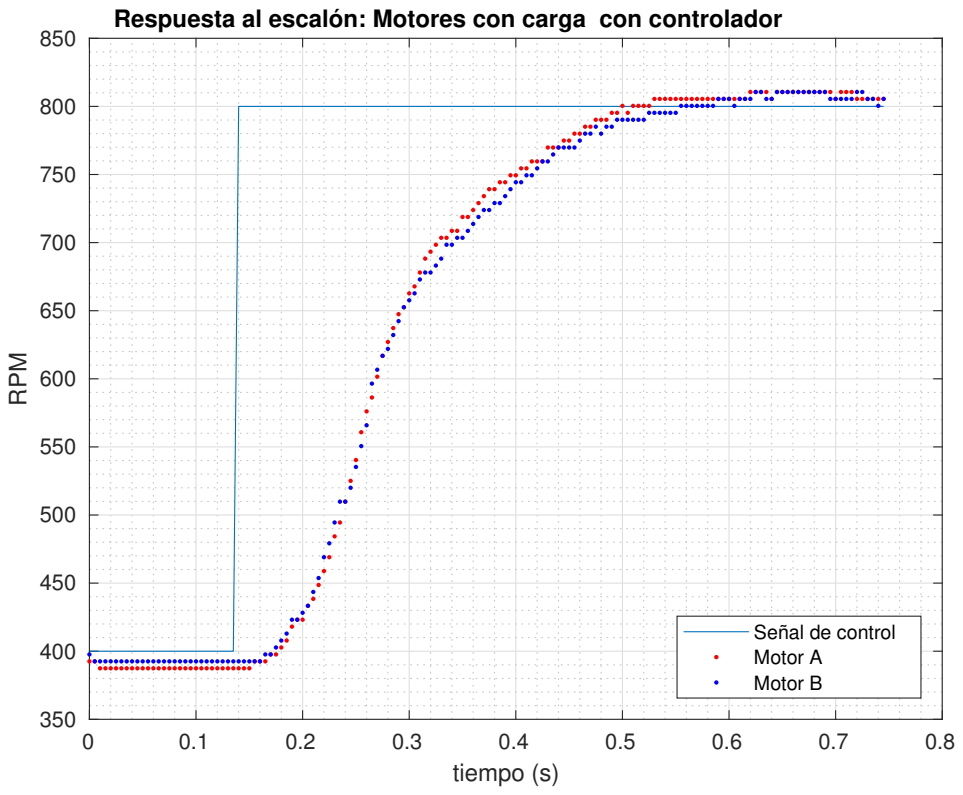
[picture p284: page 1]
tiempo (s); RPM

Respuesta al escalón: Motores con carga con controlador

Señal de control
Motor A
Motor B
