Seba-san/Trabajo_Final_Controlados/Informe/Pre_informe/imagenes/resp_escalon_motores-eps-converted-to.pdf

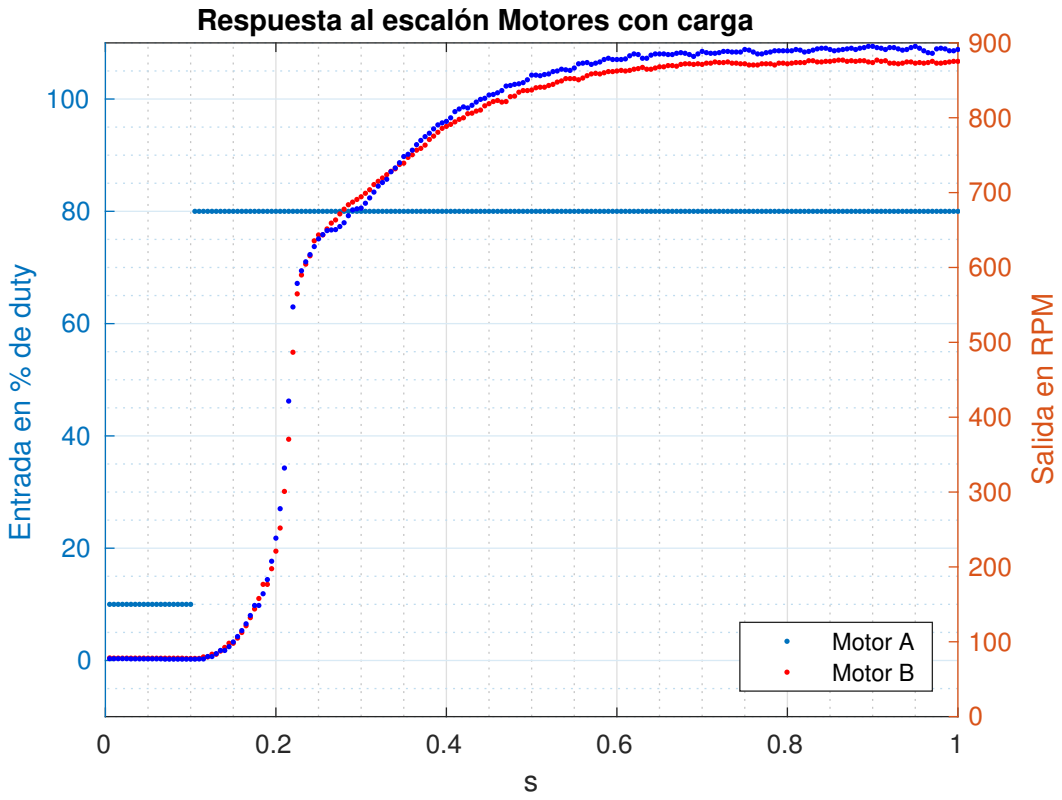
[picture p285: page 1]

Respuesta al escalón Motores con carga

Entrada en % de duty

Salida en RPM

Motor A
Motor B
