Seba-san/Trabajo_Final_Controlados/Informe/Pre_informe/imagenes/resp_escalon_motores_controlados-eps-converted-to.pdf

## Respuesta al escalón simulada Motor B controlado

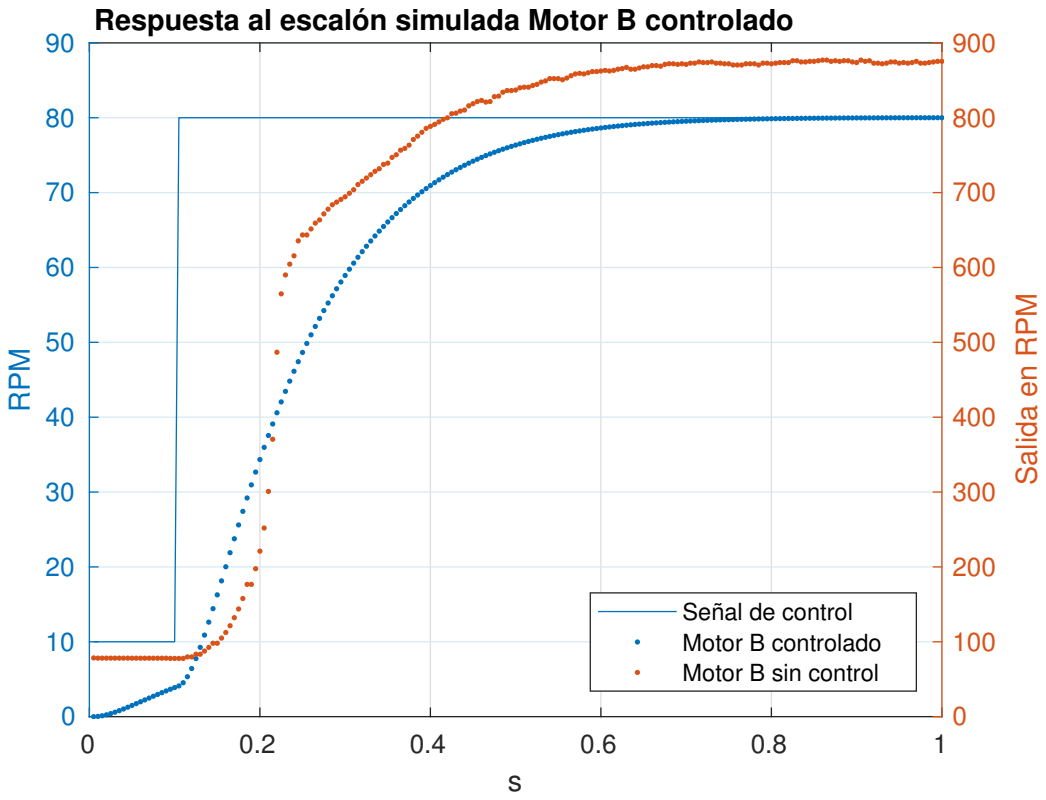
[picture p286: page 1]
RPM

Salida en RPM

Señal de control Motor B | controlado

Motor B | sin control
