Seba-san/Trabajo_Final_Controlados/pcb_mother/pdf/Final.pdf

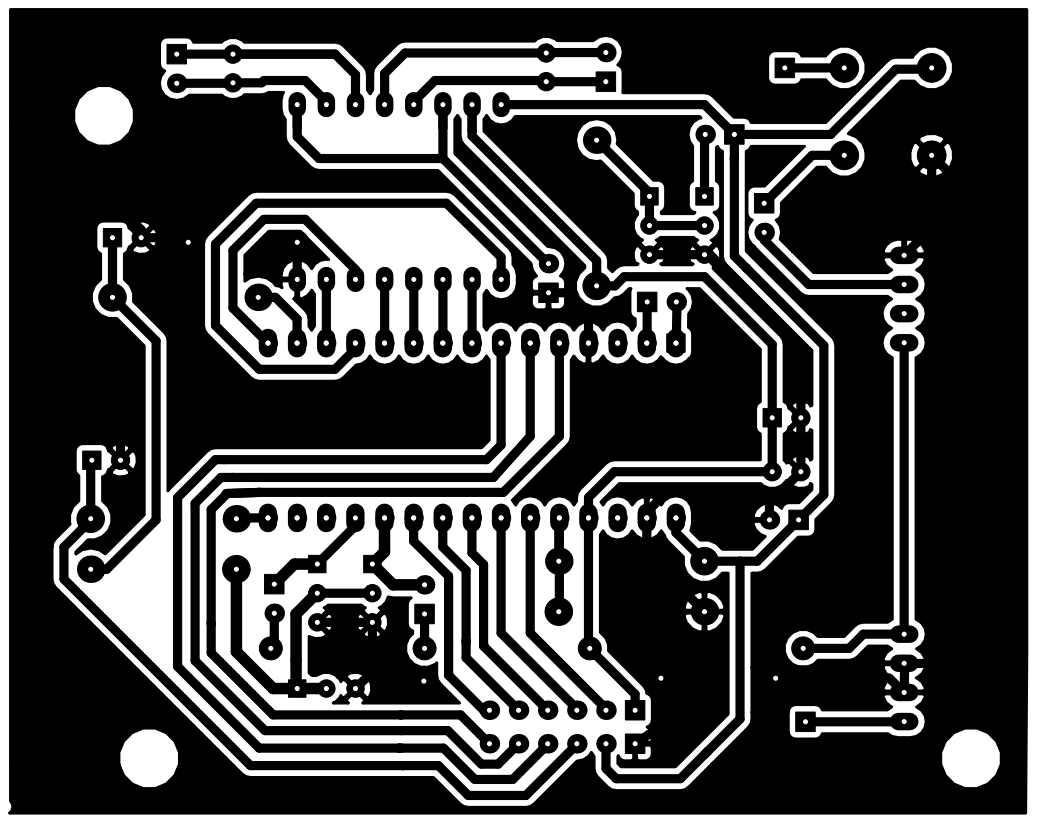
[picture p287: page 1]
