Seba-san/Trabajo_Final_Controlados/pcb_mother/pdf/pcb_v1-F.Cu2.pdf

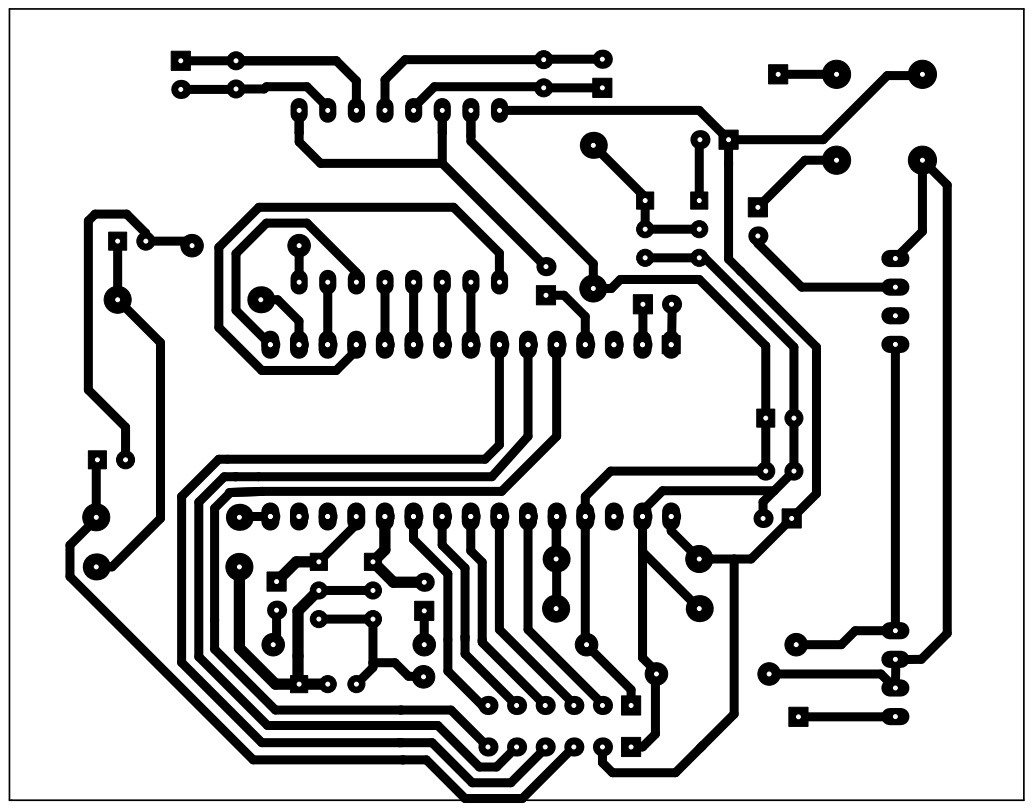
[picture p288: page 1]
