Seba-san/Trabajo_Final_Controlados/pcb_mother/pdf/pcb_v1-F.Cu_da.pdf

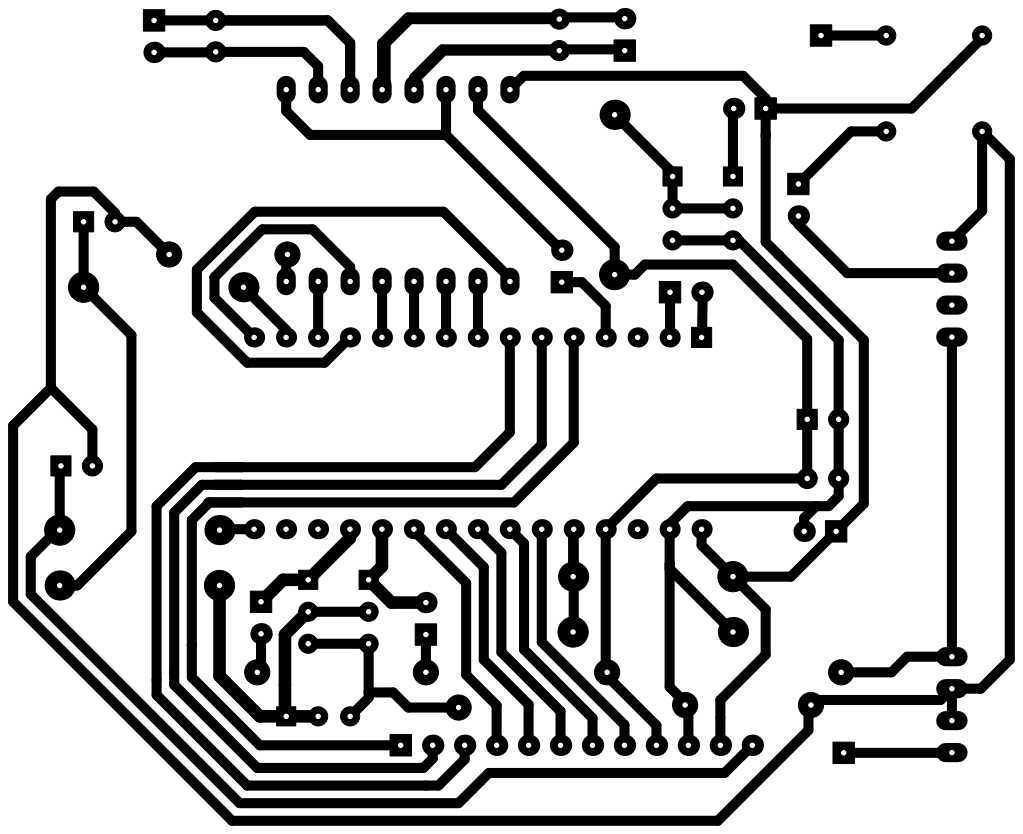
[picture p289: page 1]
