Seba-san/Trabajo_Final_Controlados/pcb_mother/sens_linea/pdf/sens_linea-B.Cu.pdf

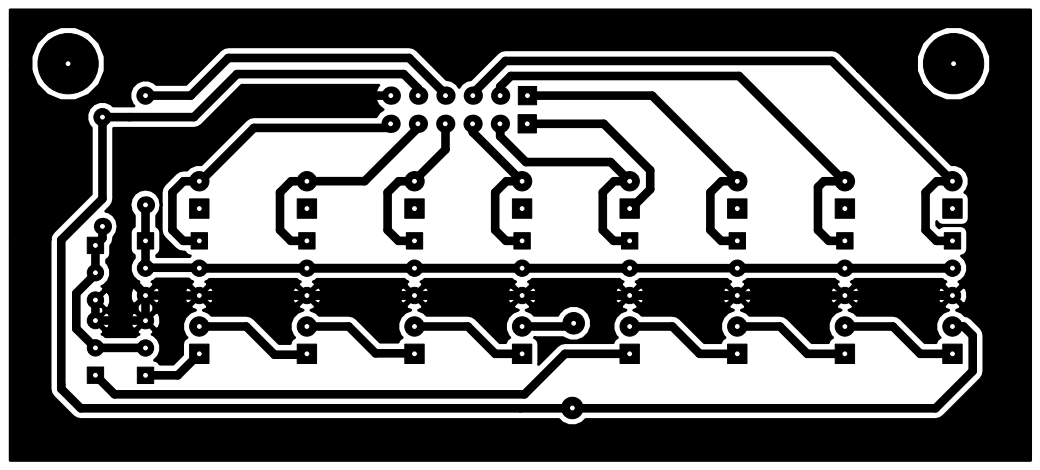
[picture p290: page 1]
