Seba-san/Trabajo_Final_Controlados/Informe/Pre_informe/imagenes/circuito_sens_linea.asc

A1: diffschmtinv
A2: diffschmtinv
D1: LED; ""
D2: LED; ""
D3: LED; ""
D4: LED; ""
D5: diode
D6: diode
Q1: npn; 2N2222
Q2: npn; 2N2222
Q3: npn; 2N2222
Q4: npn; 2N2222
Q5: npn; 2N2222
R1: res
R2: res
Named nets: 0, Vbat, 5V, Sens_2, Sens_1
