Seba-san/Trabajo_Final_Controlados/pcb_mother/pcb_v1.kicad_pcb

## KiCad design pcb_mother/pcb_v1.kicad_pcb (2018-05-09)

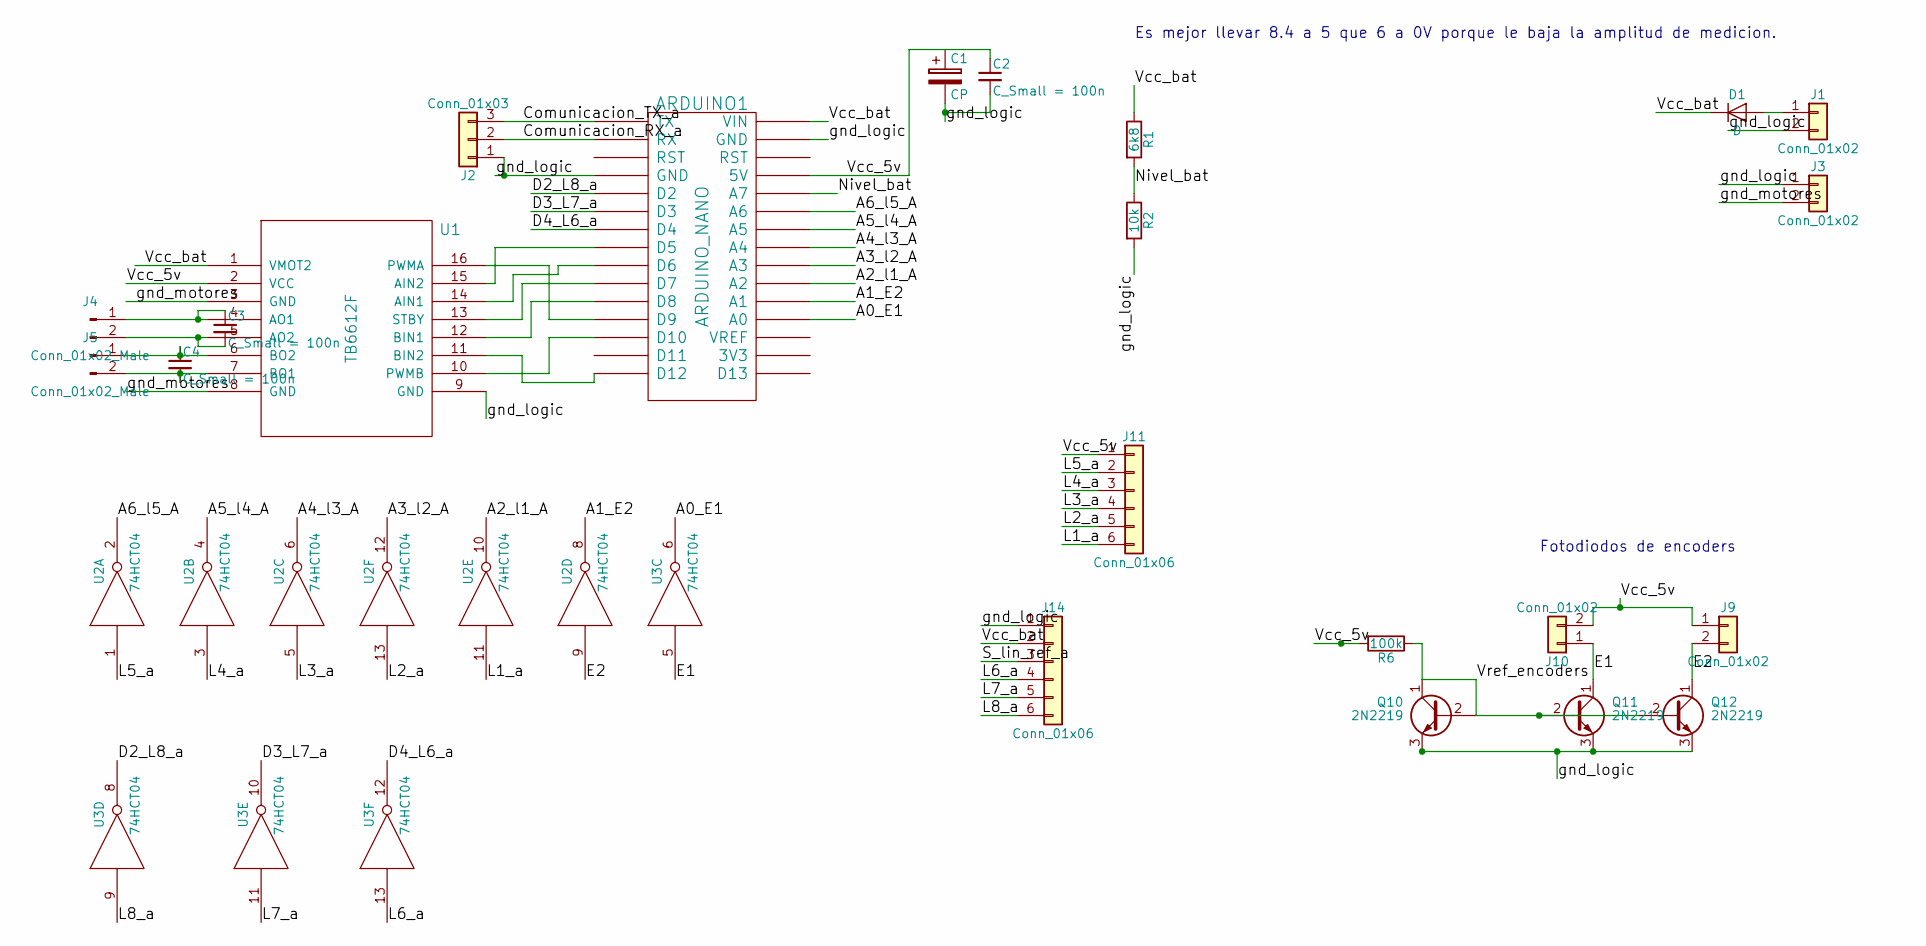
[picture p292: schematic pcb_v1.sch]

Parts:
ARDUINO1: ARDUINO_NANO; Arduino_Nano
C1: CP; CP_Radial_D5.0mm_P2.50mm
C2, C3, C4: C_Small = 100n; C_Disc_D5.0mm_W2.5mm_P2.50mm
D1: D; D_1206
J1, J3, J9, J10: Conn_01x02; Pin_Header_Straight_1x02_Pitch2.54mm
J2: Conn_01x03; Pin_Header_Straight_1x03_Pitch2.54mm
J4, J5: Conn_01x02_Male; Pin_Header_Straight_1x02_Pitch2.54mm
J11, J14: Conn_01x06; Pin_Header_Straight_1x06_Pitch2.54mm
Q10, Q11, Q12: 2N2219; TO-92_Inline_Wide
R1: 6k8; R_Axial_DIN0207_L6.3mm_D2.5mm_P10.16mm_Horizontal
R2: 10k; R_Axial_DIN0207_L6.3mm_D2.5mm_P10.16mm_Horizontal
R6: 100k; R_Axial_DIN0207_L6.3mm_D2.5mm_P10.16mm_Horizontal
U1: TB6612F; tb6612
U2, U3: 74HCT04; DIP-14_W7.62mm_Socket_LongPads

Connections:
/A0_E1: ARDUINO1.19 (A0), U3.6
/A1_E2: ARDUINO1.20 (A1), U2.8
/A2_l1_A: ARDUINO1.21 (A2), U2.10
/A3_l2_A: ARDUINO1.22 (A3), U2.12
/A4_l3_A: ARDUINO1.23 (A4), U2.6
/A5_l4_A: ARDUINO1.24 (A5), U2.4
/A6_l5_A: ARDUINO1.25 (A6), U2.2
/Comunicacion_RX_a: ARDUINO1.2 (RX), J2.2
/Comunicacion_TX_a: ARDUINO1.1 (TX), J2.3
/D2_L8_a: ARDUINO1.5 (D2), U3.8
/D3_L7_a: ARDUINO1.6 (D3), U3.10
/D4_L6_a: ARDUINO1.7 (D4), U3.12
/E1: J10.1, Q11.1 (C), U3.5
/E2: J9.2, Q12.1 (C), U2.9
/L1_a: J11.6, U2.11
/L2_a: J11.5, U2.13
/L3_a: J11.4, U2.5
/L4_a: J11.3, U2.3
/L5_a: J11.2, U2.1
/L6_a: J14.4, U3.13
/L7_a: J14.5, U3.11
/L8_a: J14.6, U3.9
/Nivel_bat: ARDUINO1.26 (A7), R1.2, R2.1
/S_lin_ref_a: J14.3; also elsewhere on the board
/Vcc_5v: ARDUINO1.27 (5V), C2.1, J9.1, J10.2, J11.1, R6.2, U1.2 (VCC)
/Vcc_bat: ARDUINO1.30 (VIN), D1.1 (K), J14.2, R1.1, U1.1 (VMOT2)
/Vref_encoders: Q10.1 (C), Q10.2 (B), Q11.2 (B), Q12.2 (B), R6.1
/gnd_logic: ARDUINO1.4 (GND), ARDUINO1.29 (GND), C1.2, C2.2, J1.2, J2.1, J3.1, J14.1, Q10.3 (E), Q11.3 (E), Q12.3 (E), R2.2, U1.9 (GND); also elsewhere on the board
/gnd_motores: J3.2, U1.3 (GND), U1.8 (GND)
GND: U2.7 (GND), U3.7 (GND)
unnamed: ARDUINO1.8 (D5), U1.15 (AIN2)
unnamed: ARDUINO1.9 (D6), U1.14 (AIN1)
unnamed: ARDUINO1.10 (D7), U1.13 (STBY)
unnamed: ARDUINO1.11 (D8), U1.12 (BIN1)
unnamed: ARDUINO1.12 (D9), U1.16 (PWMA)
unnamed: ARDUINO1.13 (D10), U1.10 (PWMB)
unnamed: ARDUINO1.15 (D12), U1.11 (BIN2)
unnamed: C3.1, J4.1, U1.4 (AO1)
unnamed: C3.2, J4.2, U1.5 (AO2)
unnamed: C4.1, J5.1, U1.6 (BO2)
unnamed: C4.2, J5.2, U1.7 (BO1)
unnamed: D1.2 (A), J1.1
VCC: U2.14 (VCC), U3.14 (VCC)

Notes on the sheet:
Es mejor llevar 8.4 a 5 que 6 a 0V porque le baja la amplitud de medicion.
Fotodiodos de encoders

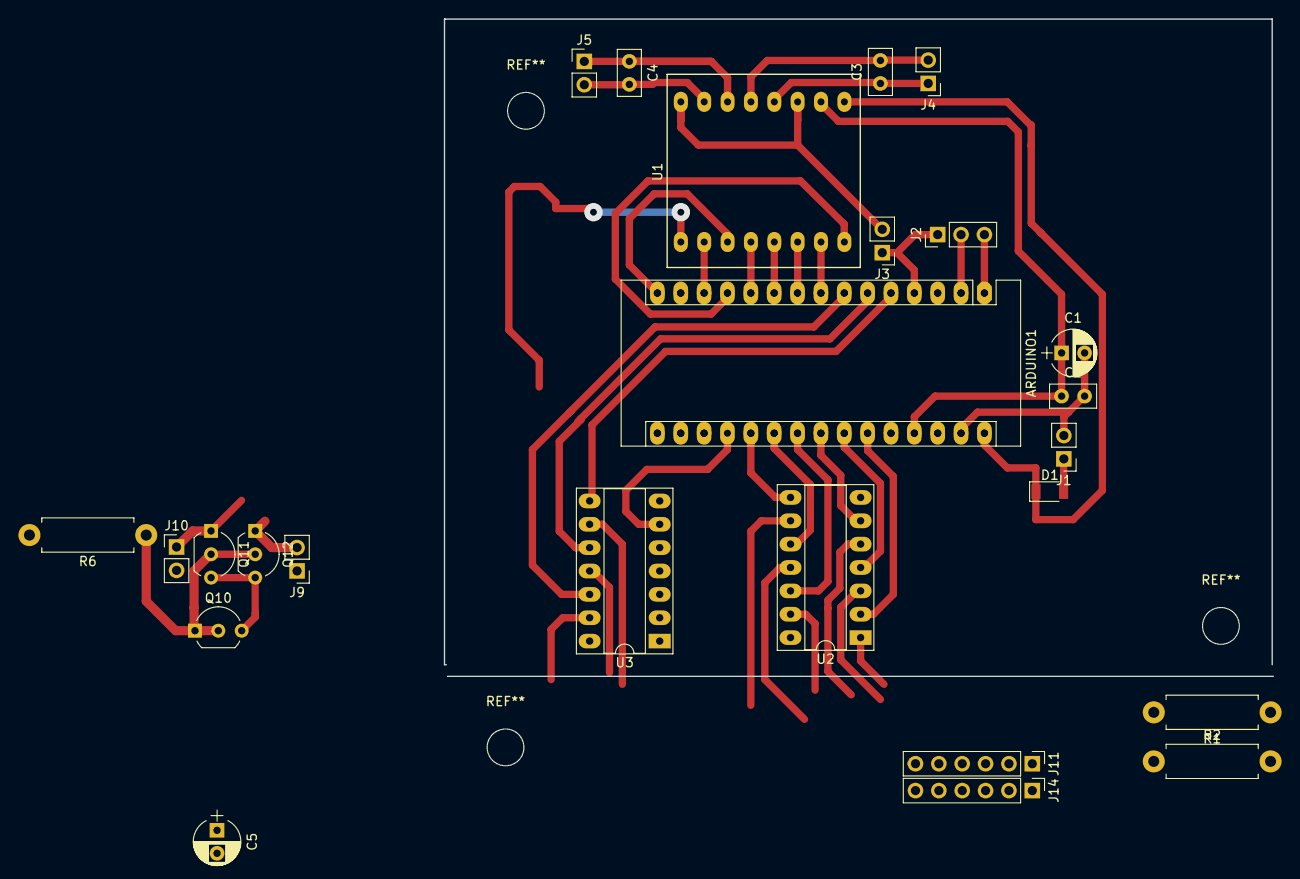
[picture p293: board pcb_mother/pcb_v1.kicad_pcb from above]

Board: 2 copper layers, 25 parts (0 on the bottom side), 43 nets.

Other parts of the board:
C5: 2.2u; CP_Radial_D5.0mm_P2.50mm

Their connections:
/S_lin_ref_a: C5.1; also elsewhere on the board
/gnd_logic: C5.2; also elsewhere on the board
