Seba-san/Trabajo_Final_Controlados/pcb_mother/Versiones_anteriores/pcb_v1.kicad_pcb

## KiCad design pcb_mother/Versiones_anteriores/pcb_v1.kicad_pcb (2018-05-07)

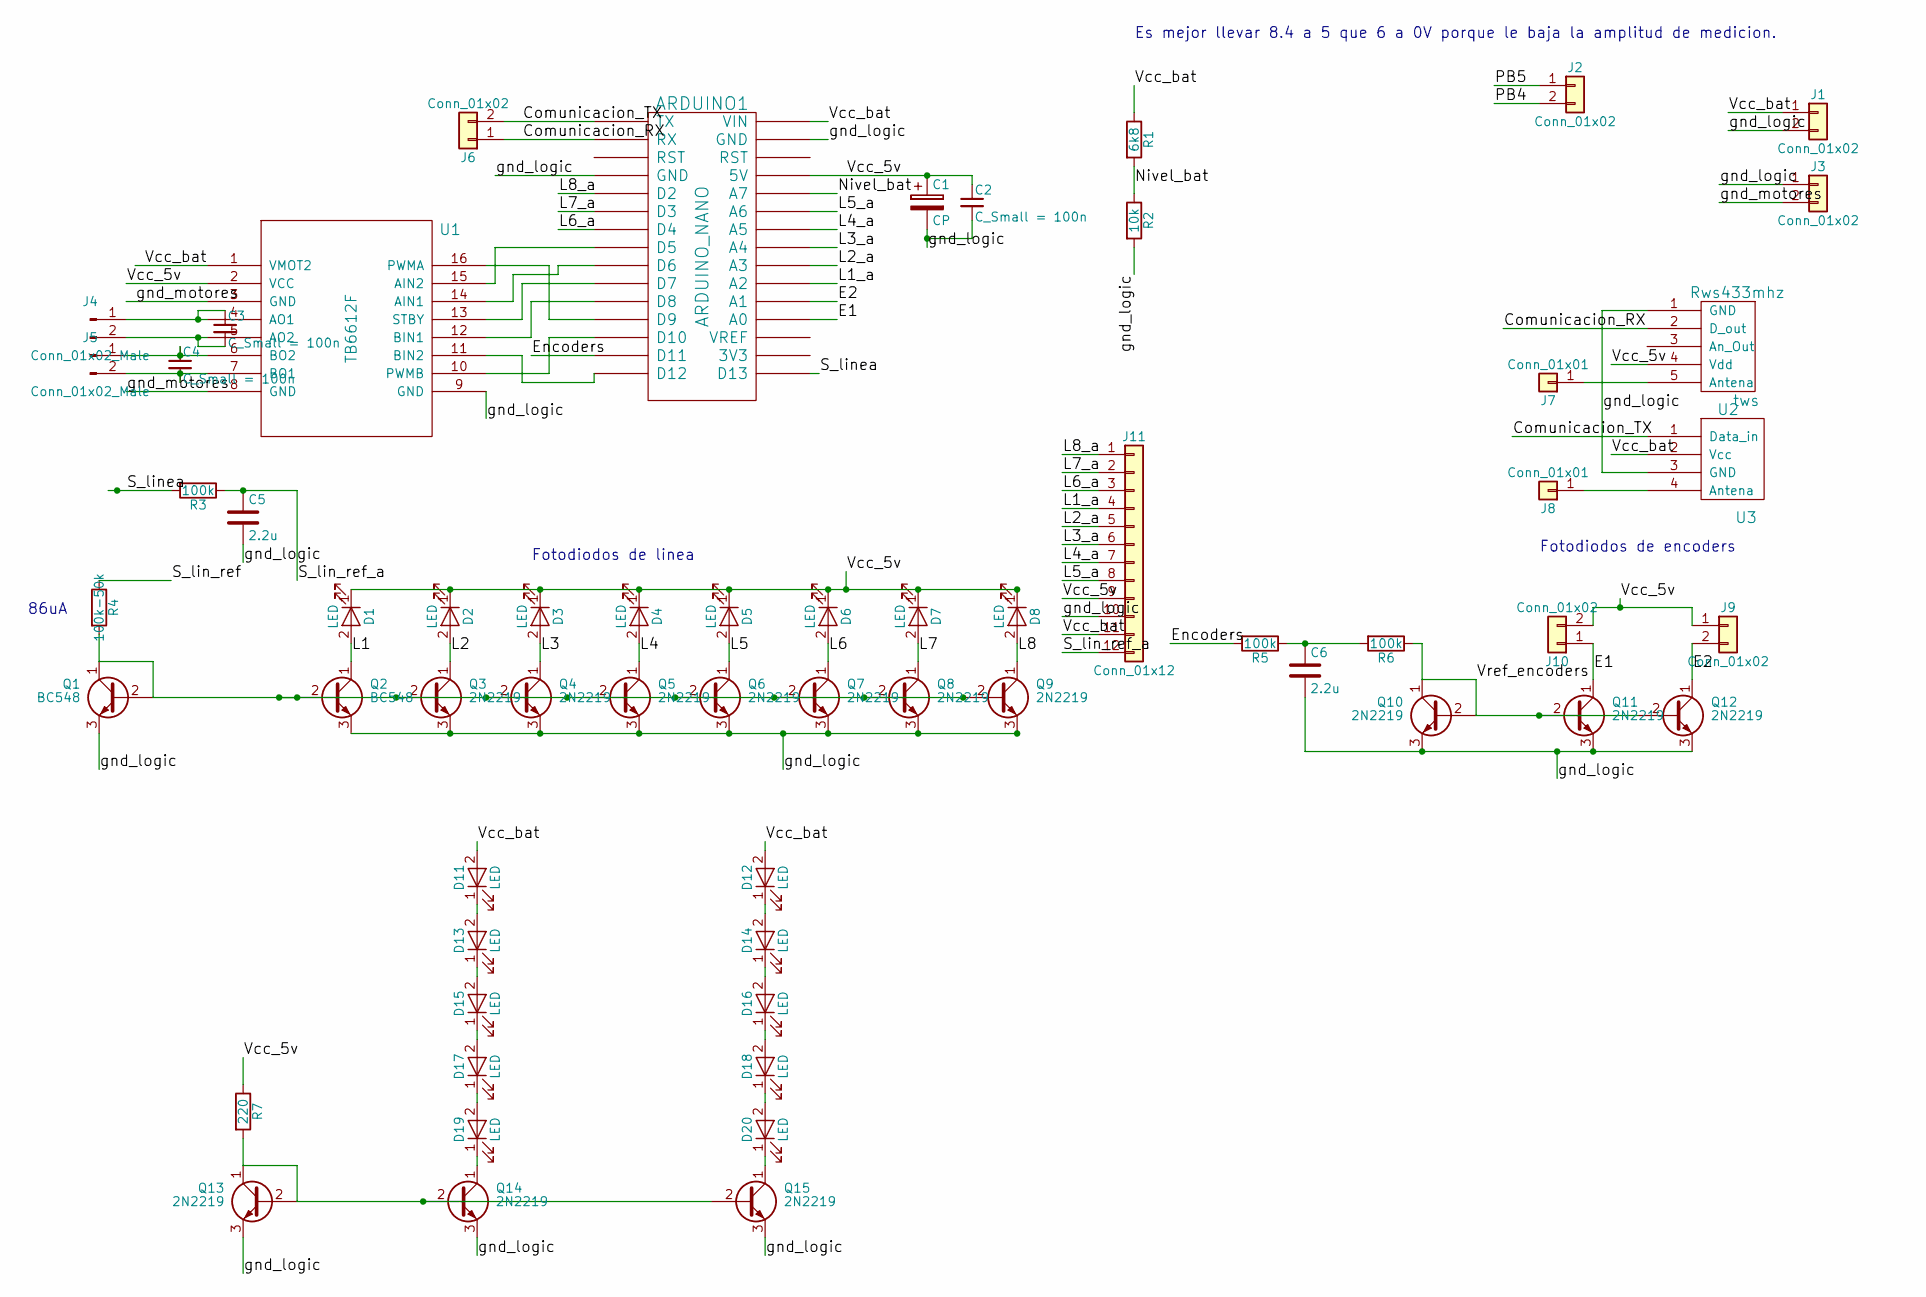
[picture p294: schematic pcb_v1.sch]

Parts:
ARDUINO1: ARDUINO_NANO; Arduino_Nano
C1: CP; CP_Radial_D5.0mm_P2.50mm
C2, C3, C4: C_Small = 100n; C_Disc_D5.0mm_W2.5mm_P2.50mm
C5, C6: 2.2u; CP_Radial_D5.0mm_P2.50mm
D1, D2, D3, D4, D5, D6, D7, D8, D11, D12, D13, D14, D15, D16, D17, D18, D19, D20: LED; LED_D5.0mm
J1, J2, J3, J6, J9, J10: Conn_01x02; Pin_Header_Straight_1x02_Pitch2.54mm
J4, J5: Conn_01x02_Male; Pin_Header_Straight_1x02_Pitch2.54mm
J7, J8: Conn_01x01
J11: Conn_01x12; Pin_Header_Straight_1x12_Pitch2.54mm
Q1, Q2: BC548; TO-92_Inline_Wide
Q3, Q4, Q5, Q6, Q7, Q8, Q9, Q10, Q11, Q12, Q13, Q14, Q15: 2N2219; TO-92_Inline_Wide
R1: 6k8; R_Axial_DIN0411_L9.9mm_D3.6mm_P12.70mm_Horizontal
R2: 10k; R_Axial_DIN0411_L9.9mm_D3.6mm_P12.70mm_Horizontal
R3, R5, R6: 100k; R_Axial_DIN0411_L9.9mm_D3.6mm_P12.70mm_Horizontal
R4: 100k-50k; R_Axial_DIN0411_L9.9mm_D3.6mm_P12.70mm_Horizontal
R7: 220; R_Axial_DIN0411_L9.9mm_D3.6mm_P12.70mm_Horizontal
U1: TB6612F; tb6612
U2: Rws433mhz; rws433
U3: tws; tws433

Connections:
/Comunicacion_RX: ARDUINO1.2 (RX), J6.1, U2.2 (D_out)
/Comunicacion_TX: ARDUINO1.1 (TX), J6.2, U3.1 (Data_in)
/E1: ARDUINO1.19 (A0), J10.1, Q11.1 (C)
/E2: ARDUINO1.20 (A1), J9.2, Q12.1 (C)
/Encoders: ARDUINO1.14 (D11), R5.2
/L1: D1.2 (A), Q2.1 (C)
/L1_a: ARDUINO1.21 (A2), J11.4
/L2: D2.2 (A), Q3.1 (C)
/L2_a: ARDUINO1.22 (A3), J11.5
/L3: D3.2 (A), Q4.1 (C)
/L3_a: ARDUINO1.23 (A4), J11.6
/L4: D4.2 (A), Q5.1 (C)
/L4_a: ARDUINO1.24 (A5), J11.7
/L5: D5.2 (A), Q6.1 (C)
/L5_a: ARDUINO1.25 (A6), J11.8
/L6: D6.2 (A), Q7.1 (C)
/L6_a: ARDUINO1.7 (D4), J11.3
/L7: D7.2 (A), Q8.1 (C)
/L7_a: ARDUINO1.6 (D3), J11.2
/L8: D8.2 (A), Q9.1 (C)
/L8_a: ARDUINO1.5 (D2), J11.1
/Nivel_bat: ARDUINO1.26 (A7), R1.2, R2.1
/PB4: J2.2
/PB5: J2.1
/S_lin_ref: R4.1
/S_lin_ref_a: C5.1, J11.12, R3.1
/S_linea: ARDUINO1.16 (D13), R3.2
/Vcc_5v: ARDUINO1.27 (5V), C1.1, C2.1, D1.1 (K), D2.1 (K), D3.1 (K), D4.1 (K), D5.1 (K), D6.1 (K), D7.1 (K), D8.1 (K), J9.1, J10.2, J11.9, R7.1, U1.2 (VCC), U2.4 (Vdd)
/Vcc_bat: ARDUINO1.30 (VIN), D11.2 (A), D12.2 (A), J1.1, J11.11, R1.1, U1.1 (VMOT2), U3.2 (Vcc)
/Vref_encoders: Q10.1 (C), Q10.2 (B), Q11.2 (B), Q12.2 (B), R6.1
/gnd_logic: ARDUINO1.4 (GND), ARDUINO1.29 (GND), C1.2, C2.2, C5.2, C6.2, J1.2, J3.1, J11.10, Q1.3 (E), Q2.3 (E), Q3.3 (E), Q4.3 (E), Q5.3 (E), Q6.3 (E), Q7.3 (E), Q8.3 (E), Q9.3 (E), Q10.3 (E), Q11.3 (E), Q12.3 (E), Q13.3 (E), Q14.3 (E), Q15.3 (E), R2.2, U1.9 (GND), U2.1 (GND), U3.3 (GND)
/gnd_motores: J3.2, U1.3 (GND), U1.8 (GND)
unnamed: ARDUINO1.8 (D5), U1.15 (AIN2)
unnamed: ARDUINO1.9 (D6), U1.14 (AIN1)
unnamed: ARDUINO1.10 (D7), U1.13 (STBY)
unnamed: ARDUINO1.11 (D8), U1.12 (BIN1)
unnamed: ARDUINO1.12 (D9), U1.16 (PWMA)
unnamed: ARDUINO1.13 (D10), U1.10 (PWMB)
unnamed: ARDUINO1.15 (D12), U1.11 (BIN2)
unnamed: C3.1, J4.1, U1.4 (AO1)
unnamed: C3.2, J4.2, U1.5 (AO2)
unnamed: C4.1, J5.1, U1.6 (BO2)
unnamed: C4.2, J5.2, U1.7 (BO1)
unnamed: C6.1, R5.1, R6.2
unnamed: D11.1 (K), D13.2 (A)
unnamed: D12.1 (K), D14.2 (A)
unnamed: D13.1 (K), D15.2 (A)
unnamed: D14.1 (K), D16.2 (A)
unnamed: D15.1 (K), D17.2 (A)
unnamed: D16.1 (K), D18.2 (A)
unnamed: D17.1 (K), D19.2 (A)
unnamed: D18.1 (K), D20.2 (A)
unnamed: D19.1 (K), Q14.1 (C)
unnamed: D20.1 (K), Q15.1 (C)
unnamed: J7.1, U2.5 (Antena)
unnamed: J8.1, U3.4 (Antena)
unnamed: Q1.1 (C), Q1.2 (B), Q2.2 (B), Q3.2 (B), Q4.2 (B), Q6.2 (B), Q7.2 (B), Q8.2 (B), Q9.2 (B), R4.2
unnamed: Q13.1 (C), Q13.2 (B), Q14.2 (B), Q15.2 (B), R7.2

Notes on the sheet:
Fotodiodos de linea
Es mejor llevar 8.4 a 5 que 6 a 0V porque le baja la amplitud de medicion.
Fotodiodos de encoders
86uA

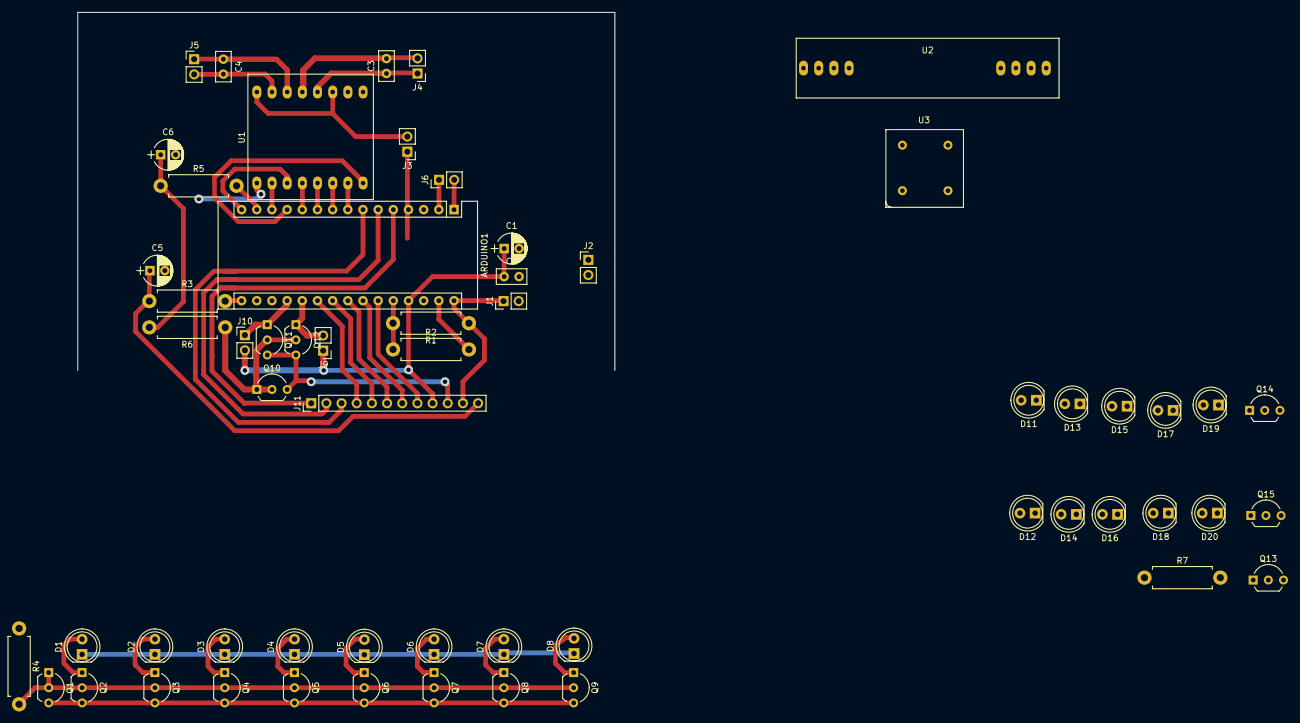
[picture p295: board pcb_mother/Versiones_anteriores/pcb_v1.kicad_pcb from above]

Board: 2 copper layers, 59 parts (0 on the bottom side), 53 nets.
