Seba-san/Trabajo_Final_Controlados/pcb_mother/adaptador_wifi/adaptador_wifi.kicad_pcb

## KiCad design pcb_mother/adaptador_wifi/adaptador_wifi.kicad_pcb (2018-05-07)

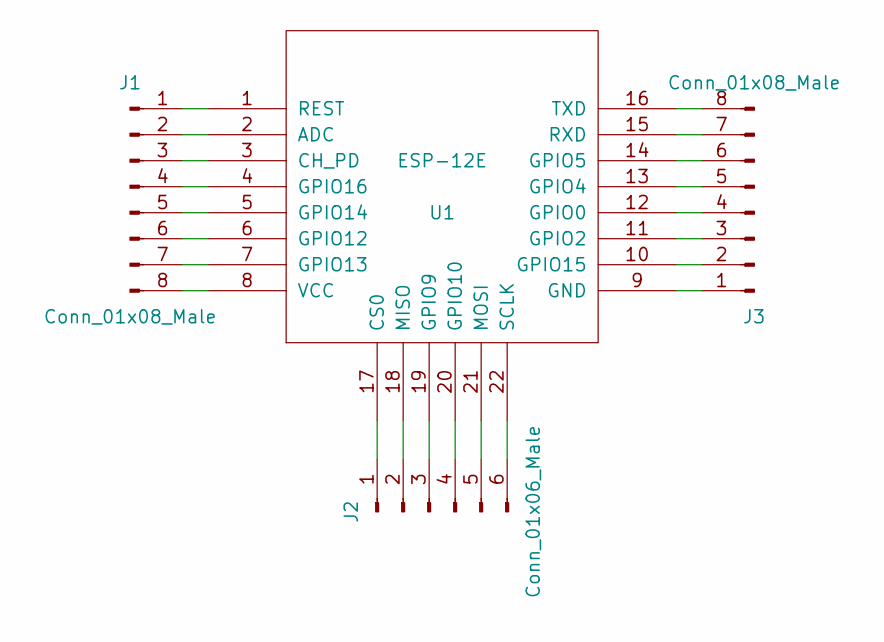
[picture p296: schematic adaptador_wifi.sch]

Parts:
J1, J3: Conn_01x08_Male; Pin_Header_Straight_1x08_Pitch2.54mm
J2: Conn_01x06_Male; Pin_Header_Straight_1x06_Pitch2.54mm
U1: ESP-12E; ESP-12E_SMD

Connections:
unnamed: J1.1, U1.1 (REST)
unnamed: J1.2, U1.2 (ADC)
unnamed: J1.3, U1.3 (CH_PD)
unnamed: J1.4, U1.4 (GPIO16)
unnamed: J1.5, U1.5 (GPIO14)
unnamed: J1.6, U1.6 (GPIO12)
unnamed: J1.7, U1.7 (GPIO13)
unnamed: J1.8, U1.8 (VCC)
unnamed: J2.1, U1.17 (CS0)
unnamed: J2.2, U1.18 (MISO)
unnamed: J2.3, U1.19 (GPIO9)
unnamed: J2.4, U1.20 (GPIO10)
unnamed: J2.5, U1.21 (MOSI)
unnamed: J2.6, U1.22 (SCLK)
unnamed: J3.1, U1.9 (GND)
unnamed: J3.2, U1.10 (GPIO15)
unnamed: J3.3, U1.11 (GPIO2)
unnamed: J3.4, U1.12 (GPIO0)
unnamed: J3.5, U1.13 (GPIO4)
unnamed: J3.6, U1.14 (GPIO5)
unnamed: J3.7, U1.15 (RXD)
unnamed: J3.8, U1.16 (TXD)

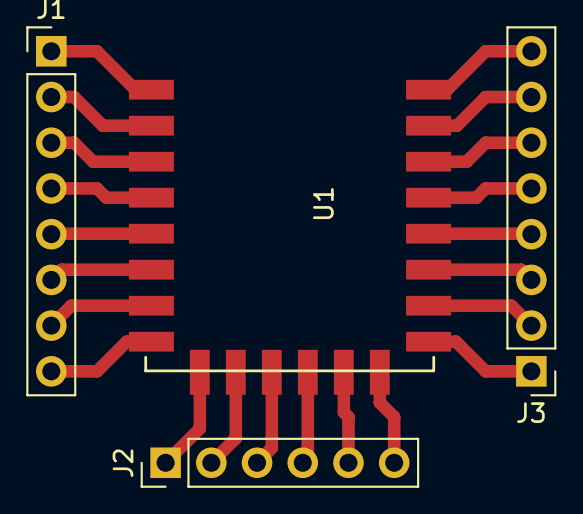
[picture p297: board adaptador_wifi.kicad_pcb from above]

Board: 2 copper layers, 4 parts (0 on the bottom side), 22 nets.
