Seba-san/Trabajo_Final_Controlados/pcb_mother/sens_linea/sens_linea.kicad_pcb

## KiCad design pcb_mother/sens_linea/sens_linea.kicad_pcb (2018-05-07)

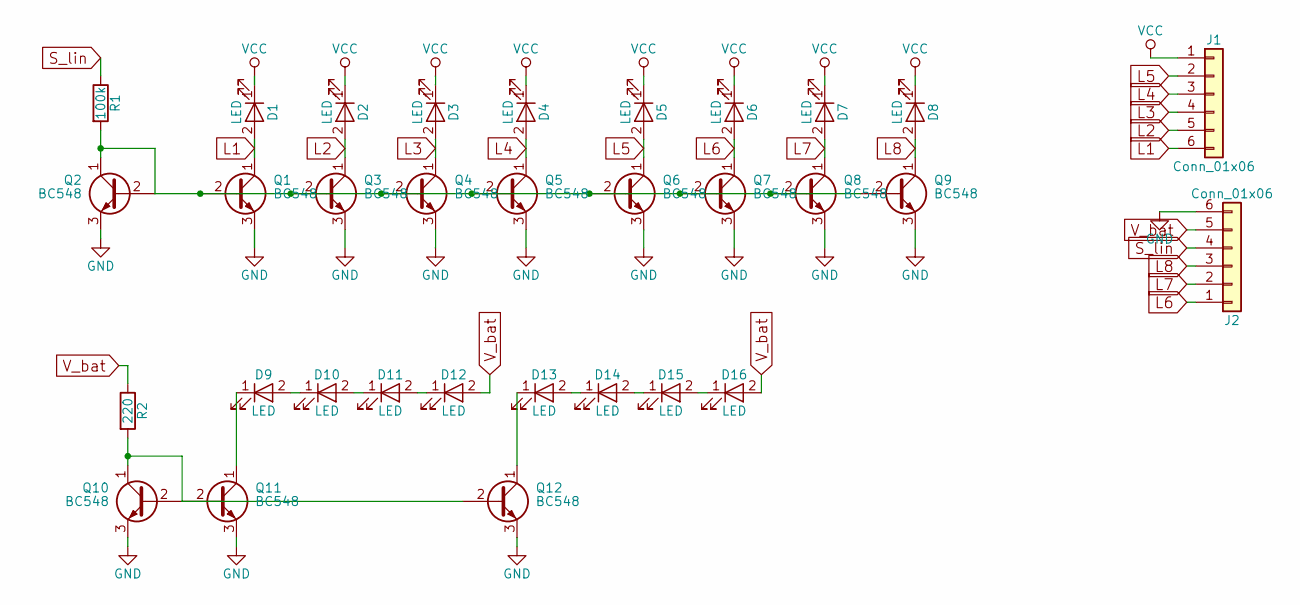
[picture p298: schematic sens_linea.sch]

Parts:
D1, D2, D3, D4, D5, D6, D7, D8, D9, D10, D11, D12, D13, D14, D15, D16: LED; LED_D5.0mm
J1, J2: Conn_01x06; Pin_Header_Straight_1x06_Pitch2.54mm
Q1, Q2, Q3, Q4, Q5, Q6, Q7, Q8, Q9, Q10, Q11, Q12: BC548; TO-92_Inline_Wide
R1: 100k; R_Axial_DIN0207_L6.3mm_D2.5mm_P10.16mm_Horizontal
R2: 220; R_Axial_DIN0207_L6.3mm_D2.5mm_P10.16mm_Horizontal

Connections:
GND: J2.6, Q1.3 (E), Q2.3 (E), Q3.3 (E), Q4.3 (E), Q5.3 (E), Q6.3 (E), Q7.3 (E), Q8.3 (E), Q9.3 (E), Q10.3 (E), Q11.3 (E), Q12.3 (E)
L1: D1.2 (A), J1.6, Q1.1 (C)
L2: D2.2 (A), J1.5, Q3.1 (C)
L3: D3.2 (A), J1.4, Q4.1 (C)
L4: D4.2 (A), J1.3, Q5.1 (C)
L5: D5.2 (A), J1.2, Q6.1 (C)
L6: D6.2 (A), J2.1, Q7.1 (C)
L7: D7.2 (A), J2.2, Q8.1 (C)
L8: D8.2 (A), J2.3, Q9.1 (C)
unnamed: D9.1 (K), Q11.1 (C)
unnamed: D9.2 (A), D10.1 (K)
unnamed: D10.2 (A), D11.1 (K)
unnamed: D11.2 (A), D12.1 (K)
unnamed: D13.1 (K), Q12.1 (C)
unnamed: D13.2 (A), D14.1 (K)
unnamed: D14.2 (A), D15.1 (K)
unnamed: D15.2 (A), D16.1 (K)
unnamed: Q1.2 (B), Q2.1 (C), Q2.2 (B), Q3.2 (B), Q4.2 (B), Q5.2 (B), Q6.2 (B), Q7.2 (B), Q8.2 (B), Q9.2 (B), R1.2
unnamed: Q10.1 (C), Q10.2 (B), Q11.2 (B), Q12.2 (B), R2.2
S_lin: J2.4, R1.1
VCC: D1.1 (K), D2.1 (K), D3.1 (K), D4.1 (K), D5.1 (K), D6.1 (K), D7.1 (K), D8.1 (K), J1.1
V_bat: D12.2 (A), D16.2 (A), J2.5, R2.1

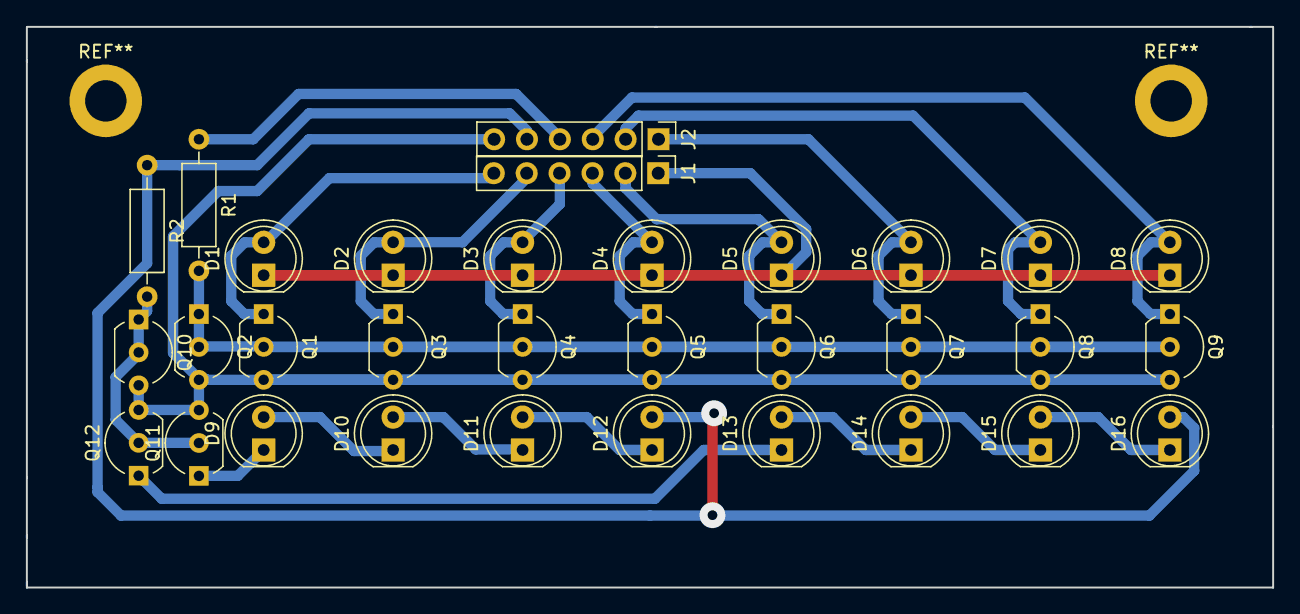
[picture p299: board sens_linea.kicad_pcb from above]

Board: 2 copper layers, 96.3 x 43.3 mm, 32 parts (0 on the bottom side), 22 nets.
