Seba-san/Trabajo_Final_Controlados/Codigos/Codigos_Arduino/Trabajo_Final_Controlados/Trabajo_Final_Controlados.ino

#include "includes.h"

Controlados controlados1;


// #   #   #   # Constantes $1
const int cantMarcasEncoder = 9; //Es la cantidad de huecos que tiene el encoder de cada motor.
const int cantMarcasEncoderB = 9; //$ BORRAR!!! SOLO PARA PRUEBAS
const int FsEncoders = 400;//400;//2000;//8000 2000 // Esto significa Overflow cada 2Khz
const int preescaler = 1024;//1024;//32;//8 32 64
const int cota = 2000;//75;//cota=32 hace que de 0 a aprox 100rpm asuma que la velocidad es cero.
unsigned long _OCR2A;
const int controlador=0;
// F_CPU es el valor con el que esta trabajando el clock del micro.


// #   #   #   # Variable Basura
int Bandera=0; // bandera para administrar procesos fuera de interrupciones


//################

// #   #   #   # Variables
unsigned long ticc,tocc;
unsigned char trama_activa=0;//Lo pongo en unsigned char para que ocupe 1 byte (int ocupa 2)
bool online;//Me indica si poner o no el identificador para la transmisión (online=true no lo transmite para ahorrar tiempo)
bool tx_activada;//Me indica si transmitir o no.
bool iniciar=false; // le dice al micro cuando puede iniciar.
int PWMA;int PWMB;//Acá guardo los valores de nuevos de PWM que me mada Matlab para que actualice. La actualización efectiva se hace cuando tengo estos dos valores.
volatile unsigned long cantOVerflowA=0,cantOVerflowB=0;//Variable que almacena la cantidad de veces que se desbordó el timer2 hasta que vuelvo a tener interrupción por pin de entrada. 
                                                       //Esto permite realizar la medición de tiempos entre agujeros del encoder.
volatile unsigned long TCNT2anteriorA=0,TCNT2anteriorB=0;//Valor anterior del contador (para corregir la medición)
volatile unsigned long TCNT2actualA=0,TCNT2actualB=0;//Almaceno el valor del timer para que no me jodan posibles actualizaciones.
volatile unsigned long cantOVerflow_actualA=0,cantOVerflow_actualB=0;//Valor anterior del contador (para corregir la medición), correspondiente al TCNT2anterior.
unsigned long aux[6];  // este es un buffer para enviar datos en formato trama, corresponde a la funcion "EnviarTX"
float  bufferVelA[2*cantMarcasEncoder],bufferVelB[2*cantMarcasEncoderB];//buffer donde almaceno las últimas velocidades calculadas.
bool Motores_ON=false;
int soft_prescaler=0;
// Variables del PID
float uA[3],uB[3]; // historia del error cometido y la historia de las salidas de control ejecutadas.
float errorA[3],errorB[3];
float set_pointA=300,set_pointB=300; // Set_point esta en RPM
float wref=300;//Velocidad lineal del centro del robot.
float beta=0;//Ángulo entre el eje central del robot y la línea (en radianes)
float dw[3]={0,0,0},errorBeta[3]={0,0,0};//Variación de velocidad angular.

unsigned char byteSensor;//Byte del sensor de línea. Sirve para debuggear y para almacenar con menos bytes la información del sensor

//Parametros PID: de las mediciones que habíamos hecho cuando hacíamos el ensayo con un sólo motor teníamos:
//PID andando medio pedorro={0.76184,-1.2174,0.48631,0,1};//PI andando={0.10679,-0.099861,0,1,0}; Andando tambien: { 0.12649 ,   -0.12348  , 0, 1, 0}; ZN

float ParametrosA[]={0.025506,-0.022009,0,1,0};//{0.092303,-0.090109,0,1,0};//{0.017045,-0.0059137,0,1,0};//{0.10679,-0.099861,0,1,0};//{0.12562,-0.1067,0,1,0};
float ParametrosB[]={0.025506,-0.022009,0,1,0};//{0.029213,-0.025653,0,1,0};//{ 0.12649 ,   -0.12348  , 0, 1, 0};//{ 0.25007  ,  -0.23902, 0 ,1 ,0};//{0.14865 ,-0.14113,0,1,0};//{0.12115  ,  -0.11309  ,       0  ,  1  ,  0};//{0.10679,-0.099861,0,1,0};//{0.095868,-0.09343,0,1,0};//{0.10679,-0.099861,0,1,0};//{0.11391,-0.095936,0,1,0};
float Parametros[]={0,0,0,0,0};//PID del sistema total

volatile float freqA;
volatile float freqB;
int windup_top=100,windup_bottom=10;
int windup_top_dw=100,windup_bottom_dw=-100;//Definir bien

unsigned char estadoEncoder=0;//En esta variable guardo el valor de las entradas de los encoders para identificar cuando se genera la interrupción cuál de los dos motores se movió

// #   #   #   # Declaracion de Funciones
void medirVelocidadA(unsigned char);
void medirVelocidadB(unsigned char);
void medirBeta(void);


void setup() { // $2
  interruptOFF; // se desactivan las interrupciones para configurar.

  Serial.begin(115200); // Si se comunica a mucha velocidad se producen errores (que no se detectan hasta que haces las cuentas)

  while (!Serial) {
    ; // wait for serial port to connect. Needed for native USB
  }

  Serial.println("Inicio");//$$$BORRAR

  //Config pines de encoders:
  pinMode(14, INPUT);//A0 = pin 14 del nano
  pinMode(15, INPUT);//A1 = pin 15 del nano
  
  controlados1.configPinesMotores();
  controlados1.modoStop();
  controlados1.configTimerMotores();
  controlados1.configTimer2Contador(FsEncoders,preescaler,1);//Configuro el timer2 como contador con interrupción. La frecuencia va desde 500000 hasta 1997.
  controlados1.actualizarDutyCycleMotores(0,0);
  
  //Antes de prender los motores guardo el valor de los encoderes en la variable estadoEncoder para que cuando se genere la primer interrupción por
  int encoderAux;
  encoderAux=bitRead(PINC,0);
  bitWrite(estadoEncoder,0,encoderAux);
  encoderAux=bitRead(PINC,1);
  bitWrite(estadoEncoder,1,encoderAux);

  //$.$
  //controlados1.modoAdelante();
  _OCR2A=OCR2A;
  interruptON;//Activo las interrupciones
}

void loop() { //$3
  if (bitRead(Bandera,0)){bitWrite(Bandera,0,0);// timer 2 overflow
  }
  if (bitRead(Bandera,1)){bitWrite(Bandera,1,0); // Entra cuando no registra cambio en la entrada A
  medirVelocidadA(0);
  }
  if (bitRead(Bandera,2)){bitWrite(Bandera,2,0);// se registra cambio en la entrada A
  medirVelocidadA(1);
  }
  if (bitRead(Bandera,3)){bitWrite(Bandera,3,0); // Entra cuando no registra cambio en la entrada B
  medirVelocidadB(0);
  }
  if (bitRead(Bandera,4)){bitWrite(Bandera,4,0);// se registra cambio en la entrada B
  medirVelocidadB(1);
  }
  if (bitRead(Bandera,5)){bitWrite(Bandera,5,0);
  medirBeta();//Actualizo la medición de ángulo
  //PID_total();//PID del sistema en su conjunto
  if (controlador==0){
     EnviarTX_online(freqB);
  }
  else{
    PID_offline_Motores(); // $VER, analizar esto, porque va a entrar varias veces (entre 8 y 9 o mas) antes de tener una nueva medida de las RPM
    Serial.println(byteSensor,BIN);
    //EnviarTX_online(freqB);
  }
  //EnviarTX_online(freqB);
  //EnviarTX_online(uB[2]);
  }
}

void medirVelocidadA(unsigned char interrupcionA)
{
long suma=0;
  //Corro los valores de w en el buffer un lugar y voy sumando los valores para después calcular el promedio de velocidades:
  for(int k=0;k<(2*cantMarcasEncoder-1);k++)
  {
    bufferVelA[k]=bufferVelA[k+1];//Desplazamiento a la derecha de los datos del buffer
    suma=suma+bufferVelA[k];
  }
  //Al terminar el bucle bufferVel tiene los últimos dos valores iguales (los dos de más a la izquierda). Esto cambia a continuación con la actualización del valor más a la derecha:
  if(interrupcionA){
    // Se hace de forma separada porque se detectaron problemas de calculo asociado con los tipos de variables. Esto se resolvio separando las cuentas, queda a futuro resolverlo en una sola linea.
    interruptOFF; // Es importante poner esto antes de hacer el calculo para evitar que modifique las variables en la interrupcion. Se observaron problemas de medicion.
    bufferVelA[2*cantMarcasEncoder-1]=(long)(preescaler)*(TCNT2actualA-TCNT2anteriorA+cantOVerflow_actualA*_OCR2A);
    suma=suma+ bufferVelA[2*cantMarcasEncoder-1];
    freqA=float((F_CPU*60.0)/(suma));
    interruptON;
  }
  else{
     bufferVelA[2*cantMarcasEncoder-1]=0;
     suma=suma+ bufferVelA[2*cantMarcasEncoder-1];
     freqA=0; // Hay que calcularla aca porque sino da cualquier valor.
  }
}

void medirVelocidadB(unsigned char interrupcionB)
{
long suma=0;
  //Corro los valores de w en el buffer un lugar y voy sumando los valores para después calcular el promedio de velocidades:
  for(int k=0;k<(2*cantMarcasEncoderB-1);k++)
  {
    bufferVelB[k]=bufferVelB[k+1];//Desplazamiento a la derecha de los datos del buffer
    suma=suma+bufferVelB[k];
  }
  //Al terminar el bucle bufferVel tiene los últimos dos valores iguales (los dos de más a la izquierda). Esto cambia a continuación con la actualización del valor más a la derecha:
  if(interrupcionB){
    // Se hace de forma separada porque se detectaron problemas de calculo asociado con los tipos de variables. Esto se resolvio separando las cuentas, queda a futuro resolverlo en una sola linea.
    interruptOFF; // Es importante poner esto antes de hacer el calculo para evitar que modifique las variables en la interrupcion. Se observaron problemas de medicion.
    bufferVelB[2*cantMarcasEncoderB-1]=(long)(preescaler)*(TCNT2actualB-TCNT2anteriorB+cantOVerflow_actualB*_OCR2A);
    suma=suma+ bufferVelB[2*cantMarcasEncoderB-1];
    freqB=float((F_CPU*60.0)/(suma));
   
    interruptON;
  }
  else{
     bufferVelB[2*cantMarcasEncoderB-1]=0;
     suma=suma+ bufferVelB[2*cantMarcasEncoderB-1];
     freqB=0; // Hay que calcularla aca porque sino da cualquier valor.
  }
}

void medirBeta(void){
  float betaAux;
  betaAux=controlados1.leerSensorDeLinea(&byteSensor);
  //Si beta=3 es porque el sensor tiró un valor erróneo o perdió la línea.
  //En ese caso mantengo el valor anterior medido. Por eso sólo actualizo beta si la rutina NO devuelve un 3.
  if(betaAux!=3){beta=betaAux;}
}
