Seba-san/Trabajo_Final_Controlados/(commit log)

2018-04-25 comentario inicial. Este proyecto se genero a partir de otros proyectos, por lo que tienen sus propios comentarios, para tener un mayor orden, decidi (seba) reiniciar el control de versiones. Actualm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
    [Assem2.SLDASM, Base.STL, BaseV2.SLDPRT, BaseV2.STL, Cronograma.xlsx, DC_GE_RED_Motor-DC_GE_RED_Motor_01-1.STL, DC_GE_RED_Motor-DC_GE_RED_Motor_02-1.STL, DC_GE_RED_Motor-DC_GE_RED_Motor_03-1.STL]
2018-04-25 Se implemento el ajuste de Z-N segun la respuesta escalon. Se compararon los resultados y resulto que la pagina ajusta medio mal, el ajuste de matlab funciona maso y la data del Ogata fue la mejor.
2018-04-26 Cambié de lugar la carpeta de Matlab para que quede todo junto.
2018-04-26 commit para hacer pruebas, ademas se agregaron algunos comentarios.
2018-04-26 Se cargo el codigo de PID y algunas estructuras de control, sin embargo no se probo. Ademas se borro codigo que no se utilizaba.
2018-04-26 cambie las funciones tic y toc, pero tiran errores de compilacion, seguir intentandolo.
    [Controlados.cpp, Controlados.h, Trabajo_Final_Controlados.ino]
2018-04-26 no funciona la comunicacion, vuelvo para atras para ver que paso.
2018-04-28 modifique algunos errores del codigo y consegui realizar un control proporcional :)git branch ./MATLAB.sh La clave estaba en hacer lo siguiente: considerar K=0.1 (porque el set_point esta en RPM (0-1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
    [Trabajo_Final_Controlados.ino]
2018-04-30 Se realizaron algunas pruebas con el sistema continuo. Aun no funciona
2018-04-30 se implemento el PID desde matlab. Esto es: el arduino envia la frecuencia, matlab calcula el PID y envia la señal de control. Lo probamos con: 0.007 0 0 1 0, y ANDAgit add Codigos/Matlab/Matlab_Seba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
2018-04-30 Si se multiplica la salida del controlador por una constante que acomode las unidades, es decir, del controlador entran RPM y SALEN RPM, por esto hay que multiplicarlo por una constante para que se t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
2018-05-01 se acomodaron algunas funciones y se genero un nuevo archivo .m para hacer mas facil la carga de parametros (obtener_parametros.m). Ademas se probaron distintos controladores: Z-N regula muy lento, l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
2018-05-03 surgio un problema de merge, se corrigio y ahora se commitea
2018-05-03 todo dejo de funcionar, vuelvo para atras
2018-05-03 commit para corregir errores anteriores.
    [Trabajo_Final_Controlados.ino]
2018-05-03 comento antes de abrir una nueva rama para hacer unas pruebas
2018-05-04 Voy a realizar pruebas con otro tiempo de muestreo, 200hz y un prescaler de 1024, por esto hago este commit
2018-05-04 Se estuvieron probando y calibrando nuevamente los motores, PID, etc. Pero se obtiene los mismos resultados.
2018-05-04 se agrego el gitignore, puede que ahroa todo ande mal :P
2018-05-04 Gracias a Cliver supe como agregar las funciones y que compile, todo para ordenar un toque el programa. Ahora falta testearlo.
2018-05-05 Se ajustaron las funciones para que mida correctamente, se calibro con un clock generado con otro arduino a 5mS.
    [Trabajo_Final_Controlados.ino, funciones.cpp, funciones.h, interrupciones.cpp, interrupciones.h]
2018-05-07 se agrego el pcb a git. Luego de este comentario se va a modificar el layout.
    [_saved_pcb_v1.sch, adaptador_wifi.kicad_pcb, adaptador_wifi.sch, pcb_v1 (copy).sch, pcb_v1.kicad_pcb, pcb_v1.sch, sens_linea.kicad_pcb, sens_linea.sch]
2018-05-09 Se moifico el esquematico y se esta acomodando para poder armar el pcb, la linea que se va a seguir es priorizar el funcionamiento antes que la estetica y el espacio.
    [_saved_pcb_v1.sch, pcb_v1.kicad_pcb, pcb_v1.sch]
2018-05-09 se modificaron las funciones para que funcionen :) seguro que producto del merge final se copiaron cosas que no debian. Hay que mejorar la forma de hacer los merge.... Ademas se creo un script de mat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
2018-05-09 modificacion del pcb previas a hacer una nueva rama.
    [pcb_v1.kicad_pcb]
2018-05-09 se cambiaron de lugar unas mediciones.
2018-05-10 Anduvo :D
    Seba encontró la solución mágica: el setpoint se lo dabamos como byte, por eso pedirle w>255 tiraba giladas. Ahora el setpoint va de 10 en 10 (Matlab lo manda dividido 10 y el nano después multiplica por 10).
    Con eso pudimos implementar los controladores P y PI según lo calculado en Simulaciones Planta Contínua y andan (no wow, pero andan). Quedan cositas por entender, pero mantienen la velocidad deseada y se oponen a las perturbaciones. Además el PID anda a pesar de que Matlab insiste en que debería dar un lazo cerrado inestable.
2018-05-18 Limpieza paso inicial
    La idea es borrar todo lo que no sea indispensable del código que implementa un PID en los motores. Por ahora lo único que hice es guardar una réplica del código en la carpeta Ensayo_escalon_y_PID_motores para que el código no se pierda y lo pueda revisar sin tener que cambiar de commit. La idea a continuación es empezar a borrar cosas del código. Pongo un commit acá por si deja de andar, así me muestra las diferencias con eso y nada más.
2018-05-21 Ajuste de código sin probar
    Se acomodó el código para que implemente el PID en ambos motores de forma simultánea. Por ahora sería lo único que hace. Todavía no se probó si anda.
2018-05-22 Correción de código 1
    Se corrigió el problema que hacía que no entrara en los if de la interrupción por cambio de estado. Era porque otra vez puse "PORTC" cuando es "PINC" -.- .
    Con esta corrección se verificó que anda bien uno de los motores. El otro no se pudo probar porque tenemos que solucionar un problema electrónico con la señal del encoder.
    [Trabajo_Final_Controlados.ino, interrupciones.cpp]
2018-05-23 Agregamos jaula
    Ahora los dos motores tienen la jaulita. Se probó ver la respuesta de un motor y después del otro. Parece andar, pero con los valores de control puestos se ve que el motor de la derecha no responde tan bien como el otro. Creo que si hacemos los ensayos de vuelta para c/motor y calibramos debería dar bien. Igual ambos tiran cada tanto un error raro, que es como un pico de velocidad y después se reacomoda.
    [Trabajo_Final_Controlados.ino]
2018-05-23 Ensayo Escalón Ambos Motores
    Se copió el código que implementaba el PID en ambos motores y se le modificó para crear el código Ensayo_Escalon_Ambos_Motores. Los resultados obtenidos se guardaron en la carpeta de Matlab. Da medio feo, pero esperemos que alcance (para calcular el PID hay que ir a SimulacionesPlantaContinua).
2018-05-23 Prueba nuevos PI
    Se probaron los nuevos controladores calculados. Funcionan horrible :( ....y eso que son parecidos los números... Andan trabado, como que de a ratos se baja la velocidad y después arranca de nuevo. No sé qué onda.
2018-05-25 Acomodando Sensor de Línea
2018-05-25 Acomodando para debuggear
2018-05-25 Andando (ponele)
    Bueno, ahí nos tira para bajas velocidades (<10) los tiempos que va midiendo (último valor de bufferVelB), estando la mitad aprox cerca de un valor y la otra mitad cerca de otro mayor.
2018-05-25 Para Mostrarle a Daniel
    Estuvimos mirando el espectro de la velocidad estimada con los tiempos entre palitos del encoder (sin sumar, ni filtrar).
2018-05-25 Sospechoso
    Le pedí que me envíe el valor de "suma" para calcular yo la frec angular y da extremadamente bien...
2018-05-25 Era eso, boludoooo!
    Le pusimos el nuevo sistema de actualización de valores por flanco ascendente al motor A y tira hermoso. Parece que era eso :v
2018-05-26 Recalculando controladores
    Con los nuevos ensayos al escalón recalculamos los controladores según ZN. Usamos el mismo código de antes, discretizando el controlador a Fs=200, pero da medio pedorro. Los PI son demasiado lentos y los PID hacen cualquiera :/ . No sé por qué antes habíamos calculado un PI tan bueno y ahora no nos sale, pero bueno...lo dejamos por ahora porque parece que es una cuestión de control teórico puro, así que se puede rever después.
2018-05-28 hago un commit para recuperar la medicion respuesta_escalon_motorB180523193004.mat
2018-05-28 La rutina de lectura del sensor anda (byte)
    Se puede leer bien el byte del sensor.
2018-05-29 se agrego el otro metodo de Cogen Coen segun el pdf que nos paso Daniel. Este nuevo metodo con tangente=0 da parametros distintos a los de antes con el PI
2018-05-29 Rutina sensor + modificaciones inconclusas
    Se terminó de armar la rutina de lectura del sensor. Tira bien los valores de beta en radianes según el ensayo hecho para el sensor actual (la versión 1 es medio mala).
    También se empezó a modificar el código para poner el PID total y hacer el ensayo al escalón, pero todavía no se sabe si eso está bien o si ahora explotó todo.
2018-05-29 Se probo el controlador CC en el modo PI para 500 RPM y funciona muy bien, para 300 RPM actua subamortiguado
2018-05-29 se agrego la variable control al codigo de arduino para activar o no el controlador. Se implemento una 3era forma de obtener los parametros de ZN, pero no es satisfactoria en la practica. Se realizo 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
2018-05-29 Acomodando Variables para la implementacion del PID final
    Eso.
2018-05-30 Agrego un archivo de texto que habia quedado perdido en otro branch
2018-05-30 Inicio otra secion de trabajo, consegui levantar el modelo del sistema de 2 polos reales ../planta3.mat
2018-05-30 se diseñaron un par de filtros para filtrar la señal, para que de esta manera se evite hacer una media movil. No hubo exito. Ademas se levanto la 180530150723respuesta_escalon_motorB_sin_promedio_10_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
2018-05-30 Se utilizo el sistema de planta3.mat para tunear el sistema en continuo por medio del PID Tuner. Para obtener un mejor rendimiento hay que bajarle el retardo al sistema; este retardo depende de las R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
2018-05-30 Se acomodo un poco el codigo 'Simulando_planta.m' para que sea un poco mas intuitivo realizar el ajuste. Hay que estimar nuevamente los retardos del sistema.
2018-05-30 Código de Ensayo al Escalón Listo
    Terminé de escribir el código. Me cambio de branch para sacar los coeficientes del controlador andando de Seba y me largo a probar.
2018-05-30 Explotó todo :'(
    Terminé de armar el código que mediría el ensayo al escalón de los motores offline. El tema es que no anda nada T-T . Parecería que por algún extraño motivo no está andando la generación de los PWM :'(
2018-05-31 Sigue sin andar
    No sé qué mierda hice :'( ! Y ahora tampoco anda lo de Ensayo al Escalón viejo!! (Probé pedirle que arranque con PWM=10 y no hace nada).
2018-05-31 Ensayo Escalón Motores
    Anda el código.
2018-06-01 Los Ensayos andan
    Estuvimos probando los ensayos y los guardamos. Anda muy bien. Después probamos ponerle un controlador calculado hace mucho y vimos cómo anda. Se nota que está mal calibrado, pero la medición muestra clarito que es por oscilación del controlador.
    Después me puse a modificar el código de ensayo escalón del sist total. Mientras comparaba códigos toqué un par de detalles del de los motores sin darme cuenta que no había commiteado....espero que no pase nada...
2018-06-01 Ensayos corregidos
    Me había olvidado de corregir la medición de velocidad u.u . Ahí acomodé el código y repetimos un par de ensayos. Anda, pero a alta velocidad tiene un detalle raro en el comportamiento...como si a alta velocidades estuviera limitada la aceleración.
2018-06-01 Ensayo total escrito, no testeado
    Terminé de armar el código. Falta probar
2018-06-01 se cargaron y ajustaron los valors para obtener un nuevo PID con los ensayos en carga
2018-06-01 Probando
    Probamos el código del ensayo al escalón. Hay que mejorarlo para facilitar el ensayo.
2018-06-01 Procesando datos con Matlab
    Le agregué código para convertir la medición del ensayo que está en bytes a radianes copiando la rutina con el switch case del sensor. Ahí me dí cuenta que aparecen configuraciones que no había contemplado con esta línea más gruesa. Específicamente, todas las combinaciones de a 3 LEDs a la vez y una de 4 LEDs a la vez. Falta agregarlas al código del nano.
2018-06-01 se esta afinando el sensor de linea para realizar el escalon
2018-06-01 Conversion Byte Sensor Mejorada
    Se modificó el código que mide el sensor de línea para hacer una suma ponderada para determinar beta. Se logró implementar sin switch case :D . Falta probarlo
2018-06-01 Se ajustaron los 2 PID de los motores de la misma forma, hay que buscar una manera de que se ajuste el sistema completo.Y usar otros controladores
2018-06-02 Probando K
    Le puse un K inventado, parece que no anda.
    Esta en Sistema_Total_Prueba
2018-06-02 Se intento ajustar el sistema en base a los datos de angulo medido, pero la formula propuesta b.=aomega*k no es una exponencial... en todo caso seria b.=aomega*k*b; sin embargo con esta 2da considera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
2018-06-02 creo que encontre la solucion: por medio de un k negativo, hacer el sistema estable y luego a ese nuevo sistema aplicarle el controlador. Por la naturaleza del sistema creo que el K de realimentacion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
2018-06-02 Logre estimar el sistema INESTABLE y lo logro estavilizar por medio del PID tuner. tiene un polo en 9.47 y la ganancia es 0.094 o 0.062
2018-06-02 Probando estimar el sist total
2018-06-02 No se que paso
2018-06-02 se cargo el modelos.mat
2018-06-02 Ensayo con controlador
    Pudimos hacer un ensayo con un proporcional a mano, donde nos tira los setpoints de los motores y el beta medido mientras sigue una línea recta. La idea es usarlo para estimar el sistema
2018-06-03 Ensayo Escalón con proporcional al principio
    Usamos el proporcional para que siga bien la línea hasta la muestra n0 y después desactiva el controlador y pone un escalón en dw. Como el nano nos muestra las mediciones de beta y el valor de dw, funciona como hace 2 commits, pero la señal de entrada es más representativa para ver la respuesta del sistema. La idea sería usar ambas para estimar el sist
2018-06-04 Estimando la Cinematica
    Se hicieron dos ensayos midiendo beta y velocidad angular según los encoders para poder estimar el sistema.
2018-06-04 Consegui levantar el modelo considerando beta como entrada y delta W como salida, por medio de sistemas inversos quizas se pueda hacer la estimacion inversa :=). El modelo es sysb_dw del archivo ../.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
2018-06-04 es dw=wB-wA, el sistema que mejor ajusta es un polo en el origen y otro polo en algun lado. Ver todas_las_medidas.sid
2018-06-04 se cargaron todos los ensayos con algunas correcciones de dW.
2018-06-05 Se cargaron los datos y se estimo el sistema. Se armo el sistema completo y se calculo el PI, tiene datos coherentes
2018-06-08 Se considera cerrao por un tiempo el desarrollo y se comienza en la redaccion del informe.
2018-06-11 Se realizo un pre-pre informe, falta realizar mediciones con el dispositivo con carga. edgardo me dijo que si se detecta un sobreimpulso en las PWM quiere decir (no directamente) que hay drift
2018-06-24 Se creo un nuevo programa en matlab para levantar los datos medidos del ensayo al escalon para estimar el sistema total. Faltan levantar mas datos en este sentido. Copie los ensayos de Testeos para p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
2018-06-24 Cambio de rama para realizar nuevas mediciones
2018-06-25 Se modifico un poco el informe, pero sin ganas, hay que revisar las ecuaciones las hipotesis aplicadas. Tambien hay que revisar la redaccion, ya no es copia literal de lo que estaba antes.
2018-06-25 Se verifico el modelado del sistema general. Falta seguir con el resto. EL modelado de los motores pude salir de la tesis de alexei.
2018-06-25 comentario antes de hacer un merge para trabajar en paralelo con TSF.
2018-06-26 Escribiendo sobre encoders
2018-06-26 commit previo al merge con tania
    [Assem1.SLDASM, Assem2.SLDASM, Assem3.SLDASM, Assem4.SLDASM, Assem5.SLDASM, Assem6.SLDASM, BREADBOARD_350_POS_CENTER.sldprt, BREADBOARD_350_POS_SIDE.sldprt]
2018-06-26 Escribiendo sobre el sensor de línea
2018-06-27 Sección de Sist de Medición casi lista
2018-06-27 Primer borrador de la sección Sistemas de Medición terminado
    Acomodé la cagada que me mandé reseteando un commit u.u
2018-07-02 Commit previo al intento de merge
2018-07-10 Se leyo todo el texto escrito hasta la fecha y se realizaron algunas modificaciones menores. Falta poner las imagenes restantes y redactar lo que sigue.
2018-07-11 Pequeño reajuste de estructura
2018-07-13 algunas cosas resaltadas en la biblia del PID
2018-07-13 Se escribio una breve introduccion de lo que es un controlador PID, por suerte, no es una copia del libro (salvo una parte de la accion derivativa); restaria ver la discretizacion y la estrategia que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
2018-07-13 Se completo la parte de discretizacion del PID, tiene algunos errores (tambien de ortografia), por lo que hay que releerlo y verificarlo. Falta agregar algunas imagenes, establecer como fue el ajuste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
2018-07-13 se completaron todos los items que se podian agregar / modificar. Faltan las mediciones en pista para establecer el rendimiento de los controladores. Ya estan las imagenes, las concluciones, los trab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
2018-07-25 se modifico levemente algunas cosas que decia el informe y ademas se agrego la parte del control total. Este comentario es previo a pońer la tabla de los resultados.
2018-07-25 Se agrego la tabla con algunos controladores probados, falta hacer el checkeo final y entregar a la brevedad.
2018-07-29 Se realizó una lectura completa del trabajo sumado a todas las correcciones pertinentes; se cambiaron algunas imagenes, las dimenciones de otras...
2018-07-29 comentario para evitar el amend
2018-07-29 se modifico la tabla de los resultados y se agrego texto en esa parte. No me convence mucho la precentacion de los resutlados, pero creo que es similar a la de otros trabajos.
2018-07-29 se corrigieron algunos errores de ortografia, de tipeo y de tiempo verbal. Falta pegarle un par (2) leidas mas para ver si hay perdida de consistencia entre otroas cosas
2018-08-01 Modificaciones al Informe terminado
    Hice varias modificaciones menores y otras no tanto. Las que no eran menores en general las deje comentadas, asi como un par de cosas que no me cerraron o que creo que habria que mejorar. Todos esos comentarios empiezan con "$.$ Seba:"; estaria bueno que las busques y las revises para ponernos de acuerdo. Ademas modifique bastante las conclusiones y las mejoras a futuro; deje casi todo lo que habias puesto, pero agregué varias cosas y reacomodé alguna que otra. Me parece importante que leas ambas secciones y entre los dos lleguemos a una versión final, ya que son bastante importantes.
2018-08-01 Se tomaron en cuenta los comentarios y / o observaciones anteriores. Se modifico todo lo modificable, falta rechequear algunos cambios. Buscar los $.$, ahi estan las cosas a revisar o checkear si la 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
2018-08-02 Se agrego un txt LEER_FINAL.txt que explica donde esta cada cosa, falta hacer un merge con la version final del branch Tania...
    [Cronograma.xlsx]
