Seba-san/Trabajo_Final_Controlados/fotos-varias/20180415_181909.jpg

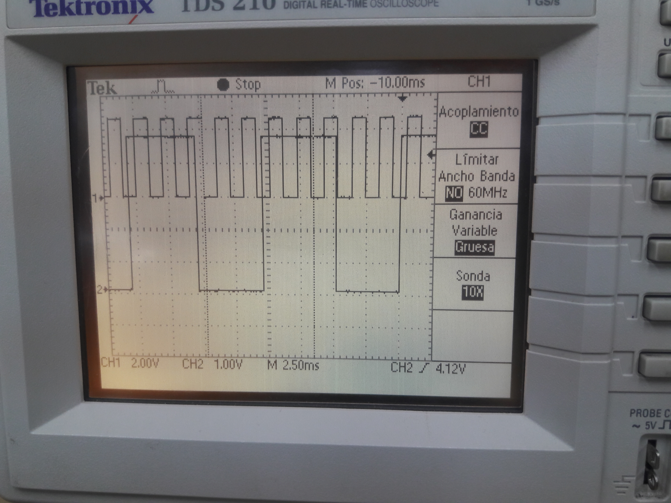
fotos-varias/20180415_181909.jpg
