Seba-san/Trabajo_Final_Controlados/fotos-varias/20180415_201900.jpg

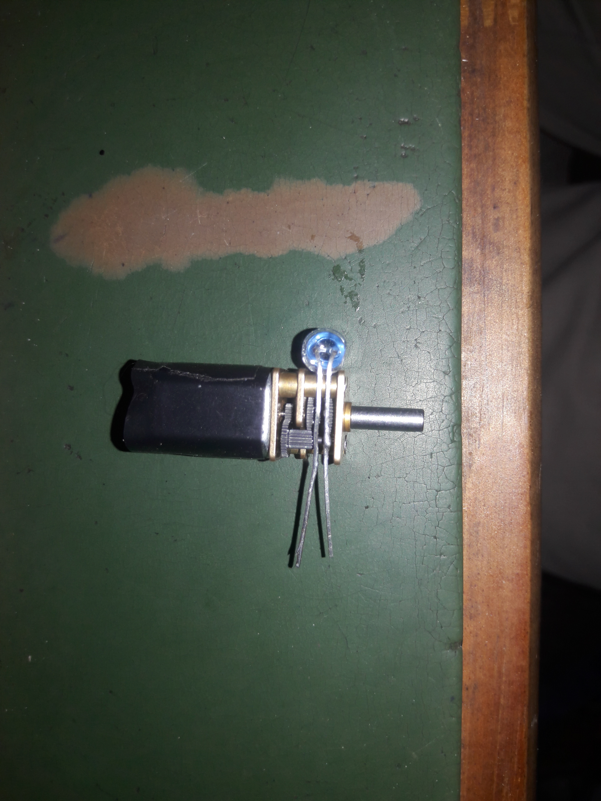
fotos-varias/20180415_201900.jpg
