Seba-san/Trabajo_Final_Controlados/fotos-varias/20180415_201925.jpg

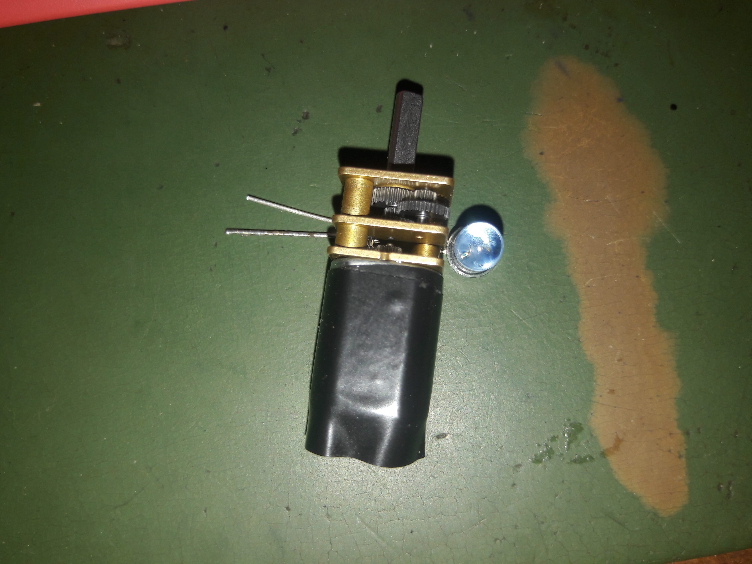
fotos-varias/20180415_201925.jpg
